JonhRon/Non-Isolate-DC_DC-Converter/Boost_Converter/Document/Images/testing/10W.jpg

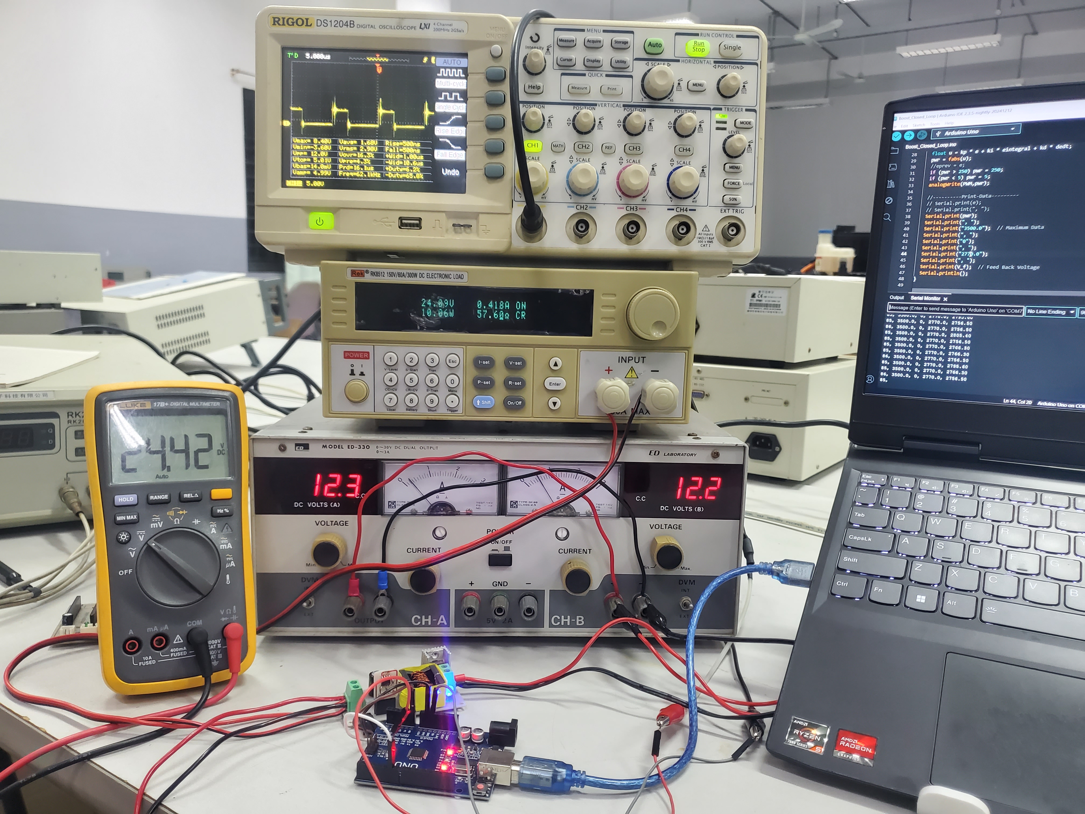
Boost_Converter/Document/Images/testing/10W.jpg
