JonhRon/Non-Isolate-DC_DC-Converter/README.md

# DC-DC Converter
The Project that i do with my 4th year at University.
