JonhRon/Non-Isolate-DC_DC-Converter/Power Electronic Digital Control/Power Electronic Digital Control.txt

Power Electronic Digital Control
[1]. https://drive.google.com/drive/folders/1nfMjxcqcaYfuC1_RFymzxEwPAJWWbfk1    %% For Buck, Boost, Buck-Boost
