JonhRon/Non-Isolate-DC_DC-Converter/Buck_Converter/Document/Docs/inductor_design_using_kg_v1.pdf

## Ferrite Core Selection Using the Kg Method

Input Parameters

L = 34.9 × 10⁻⁶ H | (Inductance)
Io = 4.583 A | (DC Current)
∆I = 1.375 A | (AC Ripple Current)
Po = 110W | (Output Power)
α = 1% | (Regulation)
fs = 100 × 10³ Hz | (Switching Frequency)
Bm = 0.25 T | (Operating Flux Density)
Ku = 0.4 | (Window Utilization)
Tr = 25 ◦C | (Temperature Rise Goal)

Calculations

1. Peak Current (Ipk):

Ipk = Io +

∆I
2
| = 4.583 +
| 1.375
| 2 = 5.27 A
2. Energy-Handling Capability (E):

E =

1
2

LI² pk =

1
2 | · 34.9 × 10⁻⁶ · (5.27)² = 4.87 × 10⁻⁴
J
3. Electrical Condition Coefficient (Ke):

Ke = 0.145 · Po · B

2

m · 10⁻⁴ = 0.145 · 110 · (0.25)²

- 10⁻⁴ = 9.96 × 10⁻⁵
4. Core Geometry Coefficient (Kg):

Kg =

E²
Ke · α

=

(4.87 × 10⁻⁴
)

2
9.96 × 10⁻⁵ · 1

= 2.38 × 10⁻³

Notes

- Kg determines the minimum core size required
- Select a ferrite core with Kg ≥ 2.38 × 10⁻³ cm⁵
- Verify core saturation at Bm = 0.25 T

1
