JonhRon/Non-Isolate-DC_DC-Converter/Buck_Converter/Document/Report/buck_converter_eng_ver02.pdf

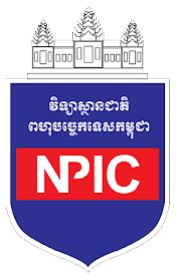
[picture p3: figure]

NATIONAL POLYTECHNIC INSTITUTE OF CAMBODIA

FACULTY OF ELECTRONIC

DEPARTMENT OF ELECTRONIC

# Assignment

# Power Electronic 2

# 120W Buck Converter Design

Professor’s Name : | Meas Saran
Student Name : | Phon Phearon

2024 - 2025

## Contents

1 Overview Of Power Electronic | 1
1.1 What’s DC/DC Converter? | | 1
1.2 Importance of Buck Converters | | 1
2 Fundamental Of Buck Converter | 2
2.1 Basic Operation and Working Principle | | 2
2.2 Key Components | | 3
2.3 Duty Cycle, In/Output Voltage Relationship, and Efficiency | | 3
3 | Mathematical Modeling | 4
3.1 Derivation of the Voltage Conversion Equation | | 4
3.2 Continuous Conduction Mode (CCM)vsDiscontinuous Conduction Mode (DCM) 5
4 Design and Implementation | 9
4.1 Power Stage Calculation and Component Selection | | 9
4.2 Power Stage Calculation and Component Selection Using Matlab Script . . . | 13
4.3 Simulation On LTspice ( Open Loop ) | | 14
4.4 Simulation On Simulink (Open Loop) | | 15
4.5 Simulation on Simulink Using PI Controller (Close Loop) | | 16

## List of Figures

1 | Buck DC-DC Converter | | 2
2 | Equivalent circuit for the switch closed | | | 2
3 | Equivalent circuit for the switch open | | 3
4 | Idealized current and voltage waveforms in the PWM buck converter for CCM. | | | 7
5 | Idealized current and voltage waveforms in the PWM buck converter for DCM. | | | 8
6 | Pulse and Magnetizing Inductance Current Waveform | | 11
7 | EE Core Selected | | | 11
8 | Buck Converter Schematic on LTspice | | | 14
9 | Output Voltage and Ouput Current Waveform | | 14
10 | Duty Cycle and Inductor Current Waveform | | 14
11 | Buck Converter Schematic on LTspice | | | 15
12 | Output Voltage and Ouput Current Waveform | | 15
13 | Duty Cycle and Inductor Current Waveform | | 15
14 | Buck Converter Schematic on LTspice | | | 16
15 | Output Voltage and Ouput Current Waveform | | 16
16 | Duty Cycle and Inductor Current Waveform | | 16

## List of Tables

1 | Parameters Needed for Power Stage Calculation | | 9
2 | IRF540N MOSFET | | 10
3 | 15SQ045 Schottky Diode | | 10
4 | Input Parameters for Ferrite Core Design | | 10
5 | Core Parameters for Ferrite Design | | 12

I

National Polytechnic Institute of Cambodia | | Faculty of Electronic

## 1 Overview Of Power Electronic

### 1.1 What’s DC/DC Converter?

A DC-DC converter is an electronic circuit that converts a source of direct current (DC) from one voltage level to another. Unlike transformers, which are designed to work with alternating current (AC), DC-DC converters are specifically tailored to handle DC power. The primary purpose of a DC-DC converter is to regulate and transform voltage levels to meet the requirements of various electronic devices. For example, step-down converters reduce voltage (for example, from 12V to 5V), while step-up converters increase voltage (e.g., from 3V to 12V).
There are several types of DC-DC converters, including:
- Buck Converter : Steps down voltage.
- Boost Converter : Steps up voltage.
- Buck-Boost Converter : Can both step up and step down voltage.
- Flyback Converter : Used for isolation and multiple outputs.

DC-DC converters are used in a wide range of applications, including consumer electronics (smartphones, laptops, and tablets), automotive systems (electric vehicles, infotainment systems, and lighting), renewable energy (solar panels, battery storage systems, and wind turbines) and industrial equipment (motor drives, robotics, and control systems).

### 1.2 Importance of Buck Converters

A buck converter is a type of DC-DC converter that steps down voltage while maintaining high efficiency. It is also known as a step-down converter because its output voltage is always lower than the input voltage. Buck converters are critical in modern electronics because they allow devices to operate at lower voltages while drawing power from higher-voltage sources. For example, a smartphone battery operates at around 3.7V, but the charger provides 5V or more. A buck converter steps this down efficiently.
The key advantages of buck converters include the following:
- High Efficiency : Buck converters typically achieve efficiencies of 90 or higher, min-imizing energy loss.
- Compact Size : Modern buck converters are small and lightweight, making them ideal for portable devices.
- Cost-Effective : They use fewer components compared to other types of converters, reducing cost and complexity.
- Reliability : With proper design, buck converters can operate reliably for years in demanding environments.

Buck converters are widely used across industries:

- Consumer Electronics : Power microprocessors, memory chips, and displays in laptops, smartphones, and gaming consoles.
- Automotive Systems : Regulating voltage for LED headlights, information system and electric vehicle drivetrains.
Power Electronic 2 | 1 | Buck Converter

- Renewable Energy : Converting the solar panel output to usable voltages for battery charging and grid integration.
- Telecommunications : Providing stable power for routers, switches, and communi-cation towers.

## 2 Fundamental Of Buck Converter

A buck converter is a type of DC-DC switching converter that steps down a higher input voltage Vin to a lower output voltage Vout. Below is a detailed, step-by-step breakdown of its operation, components, and key relationships.

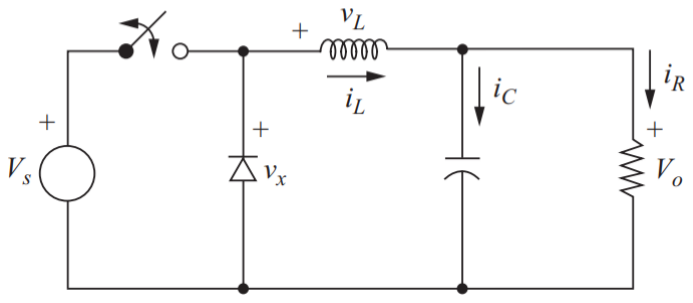
[picture p4: figure]

Figure 1: Buck DC-DC Converter

### 2.1 Basic Operation and Working Principle

The buck converter operates by rapidly switching a power semiconductor (e.g., MOSFET) on and off, controlling energy transfer to the load. Here’s how it works:

Step 1: Switch ON State
- The MOSFET (switch) is turned ON by a PWM (Pulse Width Modulation) signal.
- Current flows from Vin through the inductor (L) to the load and output capacitor (C).
- The inductor stores energy in its magnetic field, and the capacitor charges.
- The diode (D) is reverse-biased (off) during this phase.

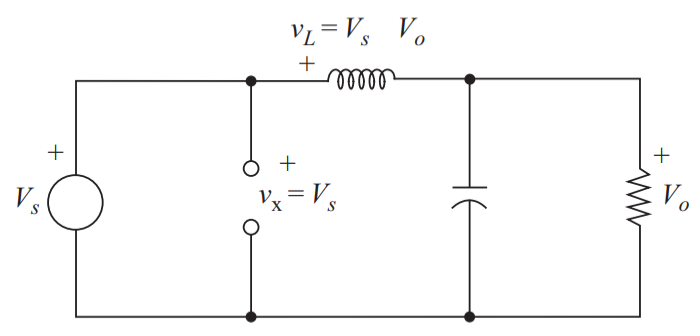
[picture p5: figure]

Figure 2: Equivalent circuit for the switch closed

Power Electronic 2 | 2 | Buck Converter

Step 2: Switch OFF State
- The MOSFET is turned OFF.
- The inductor’s magnetic field collapses, maintaining current flow through the freewheeling diode (D).
- Energy stored in L and C continues to power the load.

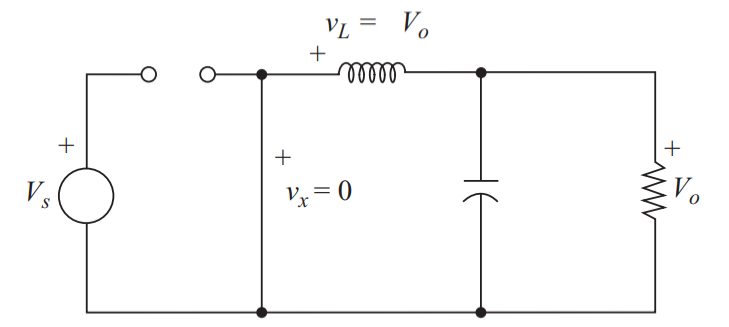
[picture p6: figure]

Figure 3: Equivalent circuit for the switch open

### 2.2 Key Components

A buck converter comprises five critical components:

- MOSFET (Switch):

– Acts as a fast-switching device (e.g., N-channel MOSFET).

– Controlled by a PWM signal to regulate energy transfer.

- Diode (Freewheeling Diode):

– Provides a path for inductor current when the switch is OFF.

– Modern designs often replace diodes with synchronous rectifiers (low-side MOS-FETs) for higher efficiency.

- Inductor (L):

– Stores energy during the ON state and releases it during the OFF state.

– Smooths current ripple.

- Capacitor (C):

– Filters output voltage ripple caused by switching.

– Maintains a stable Vout during load transients.

### 2.3 Duty Cycle, In/Output Voltage Relationship, and Efficiency

1. Duty Cycle (D)
- Defined as the ratio of ON time (Ton) to the total switching period (Tsw):

D =

Ton

Tsw

Power Electronic 2 | 3 | Buck Converter

2. Voltage Relationship:
- In continuous conduction mode (CCM), the output voltage is:

Vout = D · Vin

- This assumes ideal components (no losses).
3. Efficiency (η)
- Efficiency is the ratio of output power (Pout) to input power (Pin):

η =

Pout

Pin

× 100%

4. Losses reduce efficiency:
- Conduction Losses: I
2R losses in MOSFET, diode, inductor, and PCB traces.
- Switching Losses: Energy lost during MOSFET turn-on/turn-off transitions.
- Inductor Core Losses: Hysteresis and eddy current losses in the inductor.
- Capacitor ESR Losses: Equivalent series resistance (ESR) in the capacitor.

## 3 Mathematical Modeling

This section explains the mathematical foundation of buck converters, including voltage conversion equations, conduction modes, and ripple calculations.

### 3.1 Derivation of the Voltage Conversion Equation

During the ON state:
- The switch is closed, and the inductor is charged by the input voltage.
- The voltage across the inductor is:

VL = Vin − Vout

- The current through the inductor increases linearly according to:

∆IL =

VL · Ton
L

=

(Vin − Vout) · Ton
L

During the OFF state:
- The switch is open, and the inductor discharges energy to the load through the diode.
- The voltage across the inductor is:

VL = −Vout

- The current through the inductor decreases linearly according to:

∆IL =

VL · Toff
L

=

−Vout · Toff
L
- In steady-state operation, the increase in inductor current during the ON state equals the decrease during the OFF state:

L · (Vin − Vout) · Ton = L · Vout · Toff

- Simplifying this equation gives:

Vout = D · Vin

Power Electronic 2 | 4 | Buck Converter

### 3.2 Continuous Conduction Mode (CCM)vsDiscontinuous Conduction Mode (DCM)

Continuous Conduction Mode

- In Continuous Conduction Mode (CCM), the inductor current never drops to zero during the switching cycle.
- This mode is common in high-power applications where efficiency and stability are critical.

Discontinuous Conduction Mode

- In Discontinuous Conduction Mode (DCM), the inductor current drops to zero before the next switching cycle begins.
- This mode is often used in low-power applications where simplicity and cost are more important than efficiency.

Key Differences Between CCM and DCM

Inductor Current Waveform:

- In CCM, the inductor current is continuous and has a triangular waveform.
- In DCM, the inductor current becomes zero for part of the switching cycle.

Output Voltage Relationship:

- In CCM, the output voltage is determined solely by the duty cycle:

Vout = D · Vin

- In DCM, the output voltage depends on the load current and switching frequency:

Vout =

2 · L · fsw · Rload
Vin · D²

Efficiency:

- CCM is generally more efficient because the inductor is fully utilized.
- DCM can suffer from higher losses due to the discontinuous nature of the current.

Boundary Condition Between CCM and DCM:

- The boundary between CCM and DCM occurs when the inductor current just reaches zero at the end of the OFF state.
- The critical inductance Lcrit for maintaining CCM is given by:

Lcrit =

(1 − D) · Rload

2 · fsw

- If the actual inductance L is greater than Lcrit, the converter operates in CCM. Oth-erwise, it operates in DCM.
Power Electronic 2 | 5 | Buck Converter

Ripple Current in the Inductor:

- The ripple current ∆IL is the peak-to-peak variation in the inductor current during a switching cycle.
- For CCM, the ripple current is given by:

∆IL =

Vin · D · (1 − D)

L · fsw

where:

– Vin is the input voltage.

– D is the duty cycle.

– L is the inductance.

– fsw is the switching frequency.

Ripple Voltage Across the Capacitor:

- The ripple voltage ∆VC is the variation in the output voltage caused by the charging and discharging of the capacitor.
- It is given by:

∆VC =

∆IL
8 · fsw · C

where:

– ∆IL is the ripple current.

– C is the capacitance.

Power Electronic 2 | 6 | Buck Converter

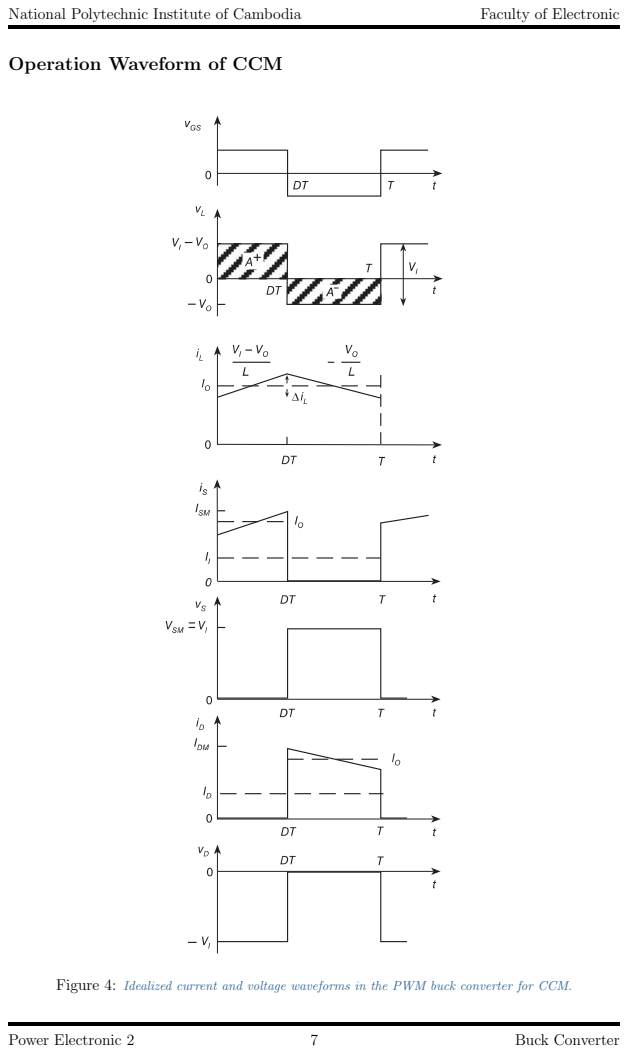
[picture p7: page 9]
Power Electronic 2; Buck Converter

Operation Waveform of CCM

Figure 4: Idealized current and voltage waveforms in the PWM buck converter for CCM.

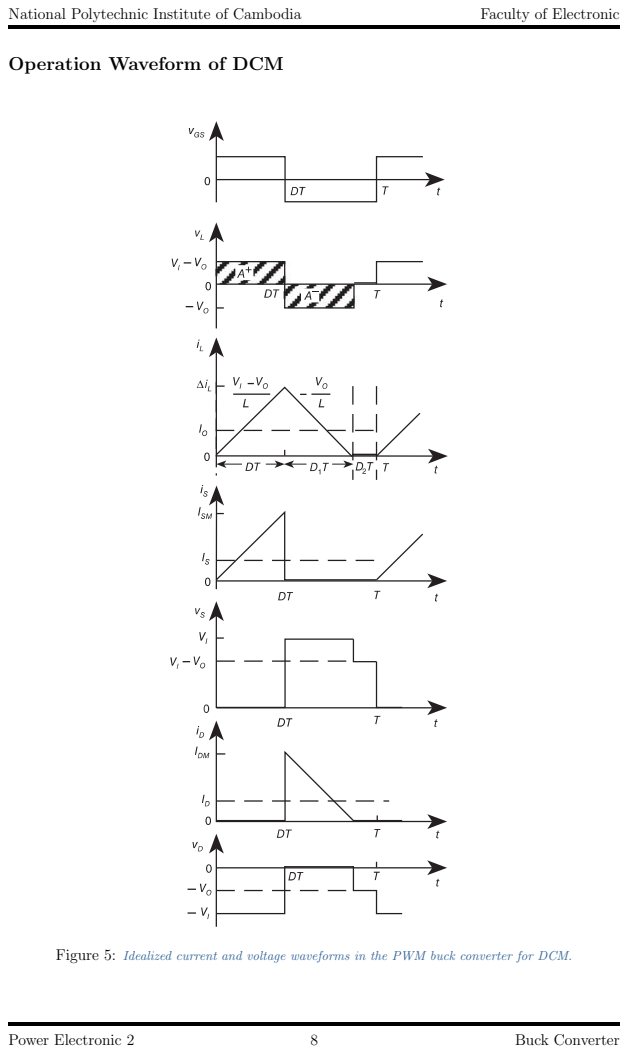
[picture p8: page 10]
Power Electronic 2; Buck Converter

Operation Waveform of DCM

Figure 5: Idealized current and voltage waveforms in the PWM buck converter for DCM.

## 4 Design and Implementation

### 4.1 Power Stage Calculation and Component Selection

Design of a 120W Buck Converter Operating in Continuous Conduction Mode (CCM) with the following specifications:

Parameter | Value
Output Voltage (Vout) | 24 V
Input Voltage (Vin) | 30 V
Output Power (Pout) | 120W
Switching Frequency (fsw) 100 kHz
Ripple Current Rated | 30% of Iout
Ripple Voltage Rated | 1% of Vout

Table 1: Parameters Needed for Power Stage Calculation

### Power Stage Calculations

### 1. Duty Cycle (D)

D =

Vout

Vin

=

24
30

= 0.8 (80%)

### 2. Output Current (Iout)

Iout =

Pout

Vout

=

120
24

≈ 5 A

### 3. Output Resistance (R)

R =

Vout

Iout

=

24
5

≈ 4.8 Ω

### 4. Inductor Ripple Current (∆IL)

∆IL = 30% × Iout = 0.3 × 5 ≈ 1.5 A (peak-to-peak)

### 5. Maximum/Minimum Inductor Current

ILmax = Iout +

∆IL
2

= 5 + 0.75 ≈ 5.75 A

ILmin = Iout −

∆IL
2

= 5 − 0.75 ≈ 4.25 A

### 6. Ripple Voltage (∆Vout)

∆Vout = 1% × Vout = 0.01 × 24 = | 0.24 V (peak-to-peak)
Power Electronic 2 | 9 | Buck Converter

### 7. Output Capacitor (C)

C =

∆IL · D

8 · Fs · ∆Vout

=

1.5 · 0.8
8 · 100 kHz · 0.24

= 6.25 µF

### 8. Inductor (L)

L =

Vout · (Vin − Vout)

Vin · Fs · ∆IL

=

24 · (30 − 24)
30 · 100 kHz · 1.5

= 32 µH

### 9. MOSFET Selection

Table 2: IRF540N MOSFET

Parameter | Value | Test Conditions
VDS | 100 V | Absolute Maximum Rating
ID | 14 A | TC = 25 ◦C
| 10 A | TC = 100 ◦C
RDS(on) | 0.16 Ω | VGS = 10 V, ID = 8.4 A

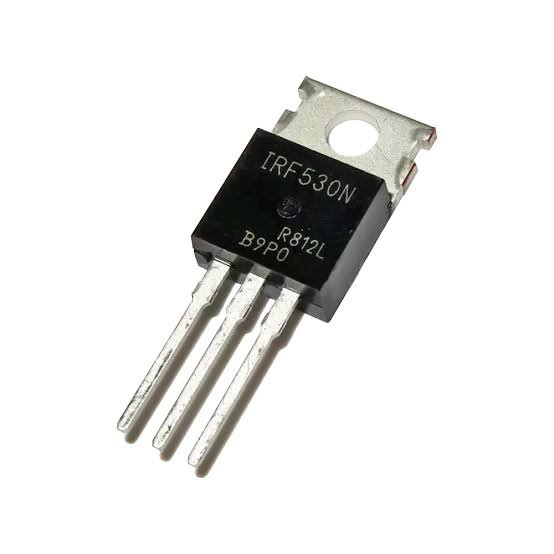
[picture p9: figure]

### 10. Diode Selection

Table 3: 15SQ045 Schottky Diode

Parameter Value | Test Conditions
VRRM | 45 V | Peak Reverse Voltage
IF | 15 A | Continuous, TA = 25 ◦C

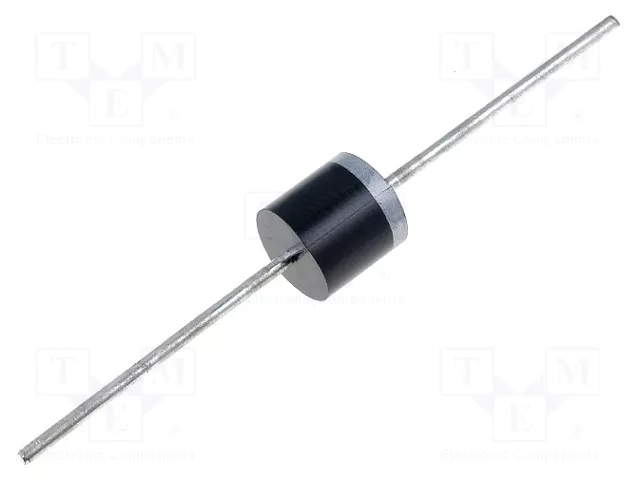
[picture p10: figure]

### 11. Inductor Design

•Inductor Core Selection Using Kg Method

Table 4: Input Parameters for Ferrite Core Design

Symbol Value | Description
L | 32 µH | Inductance
Io | 5 A | DC Current
∆I | 1.5 A | AC Ripple Current
Po | 120W | Output Power
α | 1% | Regulation
fs | 100 kHz Switching Frequency
Bm | 0.25 T | Operating Flux Density
Ku | 0.4 | Window Utilization
Tr | 25 ◦C | Temperature Rise Goal
Power Electronic 2 | 10 | Buck Converter

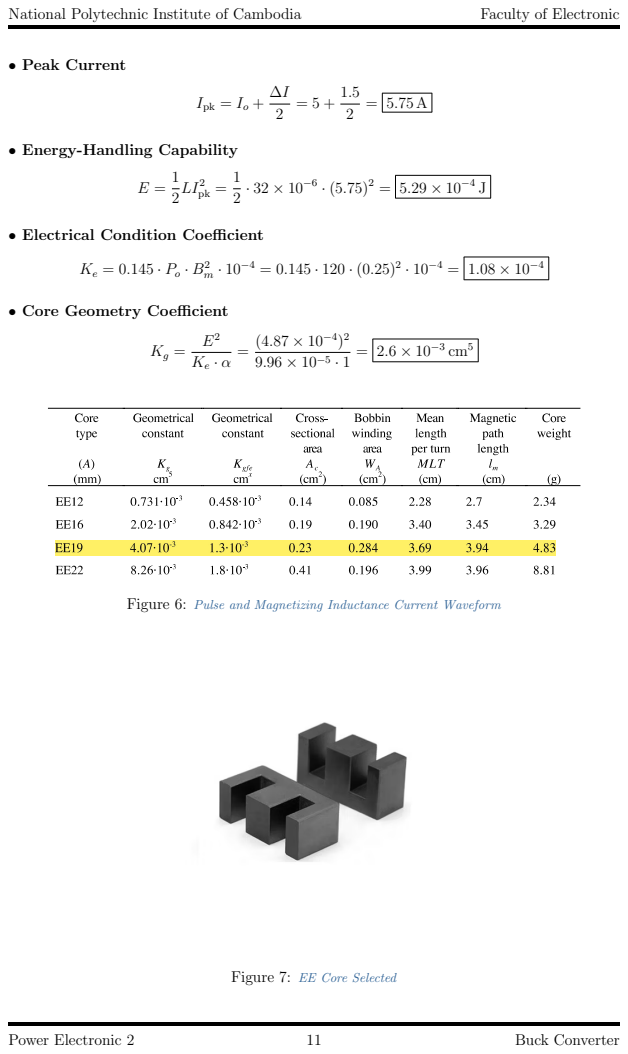
[picture p11: page 13]
• Peak Current; Ipk = Io +; LI² pk =; cm⁵; Power Electronic 2; Buck Converter

• Energy-Handling Capability

• Electrical Condition Coefficient

• Core Geometry Coefficient

Figure 6: Pulse and Magnetizing Inductance Current Waveform

Figure 7: EE Core Selected

Parameter | Value | Description
MPL | 3.94 | Magnetic Path Length (cm)
We | 4.83 | Core Weight (g)
MLT | 3.69 | Mean Length per Turn (cm)
Ac | 0.23 | Cross-Sectional Area (cm²
)
Wa | 0.284 | Window Area (cm²
)
Ap | 0.0653 | Core Product (cm⁴
)
Kg | 4.07 × 10⁻³ Core Geometry (cm⁵
)

Table 5: Core Parameters for Ferrite Design

- Current Density (J)

J =

2 · E · 10⁴

Bm · Ap · Ku

=

2 · 5.29 × 10⁻⁴
- 10⁴
0.25 · 0.06532 · 0.4

≈ 1620 A cm⁻²
- RMS Current (IRMS)

Irms =

p
I

2
o + ∆I

2 =

√
5

2 + 1.5

2 = | 5.22 A | .
- Bare Wire Area (Aw)

Aw =

Irms
J

=

5.22
1620

= 0.003 22 cm²
- Selected Bare Wire Area

Aws = 0.01 cm²

- Effective Window Area (Waeff)
- S3 = 0.75 Window Effective factor for Ferrite core

Waeff = Wa · S3 = 0.284 · 0.75 = 0.213 cm² .

- Number of Turns (N)
- S2 = 0.6 Fill Factor

N =

Waeff · S2

Aws

=

0.213 · 0.6
0.01
= | 12.7 turns | .
- Required Air Gap (Lg)

Lg =

0.4πN²Ac · 10⁻⁸
L

−

MP L
µ0
Substituting values:

Lg =

0.4 · π · 10²

- 0.23 · 10⁻⁸
32 × 10⁻⁶

−

3.94
2500
= | 0.0137 cm | .
Power Electronic 2 | 12 | Buck Converter

### 4.2 Power Stage Calculation and Component Selection Using Matlab Script

Below is the MATLAB code use to calculate the Power Stage and Component Selection for the 120W Buck Converter design.

%% 120W Buck Converter Design
clc , clear , close all ;
%% Design Parameter
Vin = 30; | % Input Voltage (V)
Vout = 24; | % Output Voltage (V)
Pout = 120; | % Output Power (W)
Fs = 100 e3 ; | % Switching Frequency (Hz)
ripple_current_rate = 0.3; % 30% ripple current ripple_voltage_rate = 0.01; % 1% ripple voltage %% 1. Duty Cycle (D)
D = Vout / Vin ;
%% 2. Output Current ( Iout )
Iout = Pout / Vout ;
%% 3. Output Resistance ( Rout )
Rout = Vout / Iout ;
%% 4. Ripple Current
delta_I_L = ripple_current_rate * Iout ; I_L_max = Iout + delta_I_L / 2;
I_L_min = Iout - delta_I_L / 2;
%% 5. Inductor (L)
L = ( Vout * ( Vin - Vout ) ) / ( Vin * Fs * delta_I_L ) ;
L_standard = ceil ( L / 1e -6) ; % Round to nearest standard valuellt %% 6. Ripple Voltage
delta_Vout = ripple_voltage_rate * Vout ;
%% 7. Output Capacitor (C)
C = ( delta_I_L * D ) / (8 * Fs * delta_Vout ) ;
C_standard = ceil ( C / 1e -6) ; % Round to nearest standard value

Listing 1: MATLAB Code for 120W Buck Converter Design

Power Electronic 2 | 13 | Buck Converter

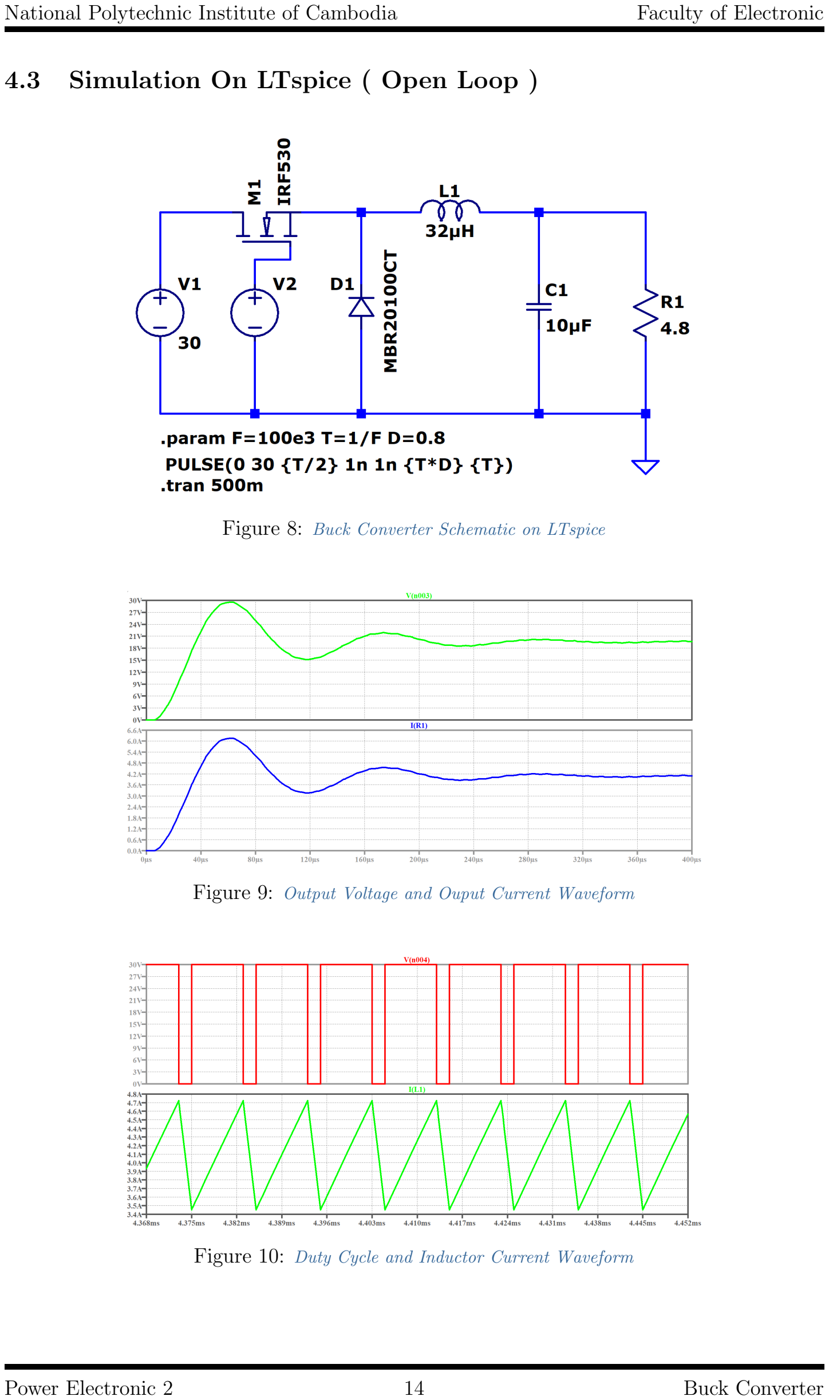
[picture p12: page 16]

### 4.3 Simulation On LTspice ( Open Loop )

Figure 8: Buck Converter Schematic on LTspice

Figure 9: Output Voltage and Ouput Current Waveform

Figure 10: Duty Cycle and Inductor Current Waveform

Power Electronic 2 | 14 | Buck Converter

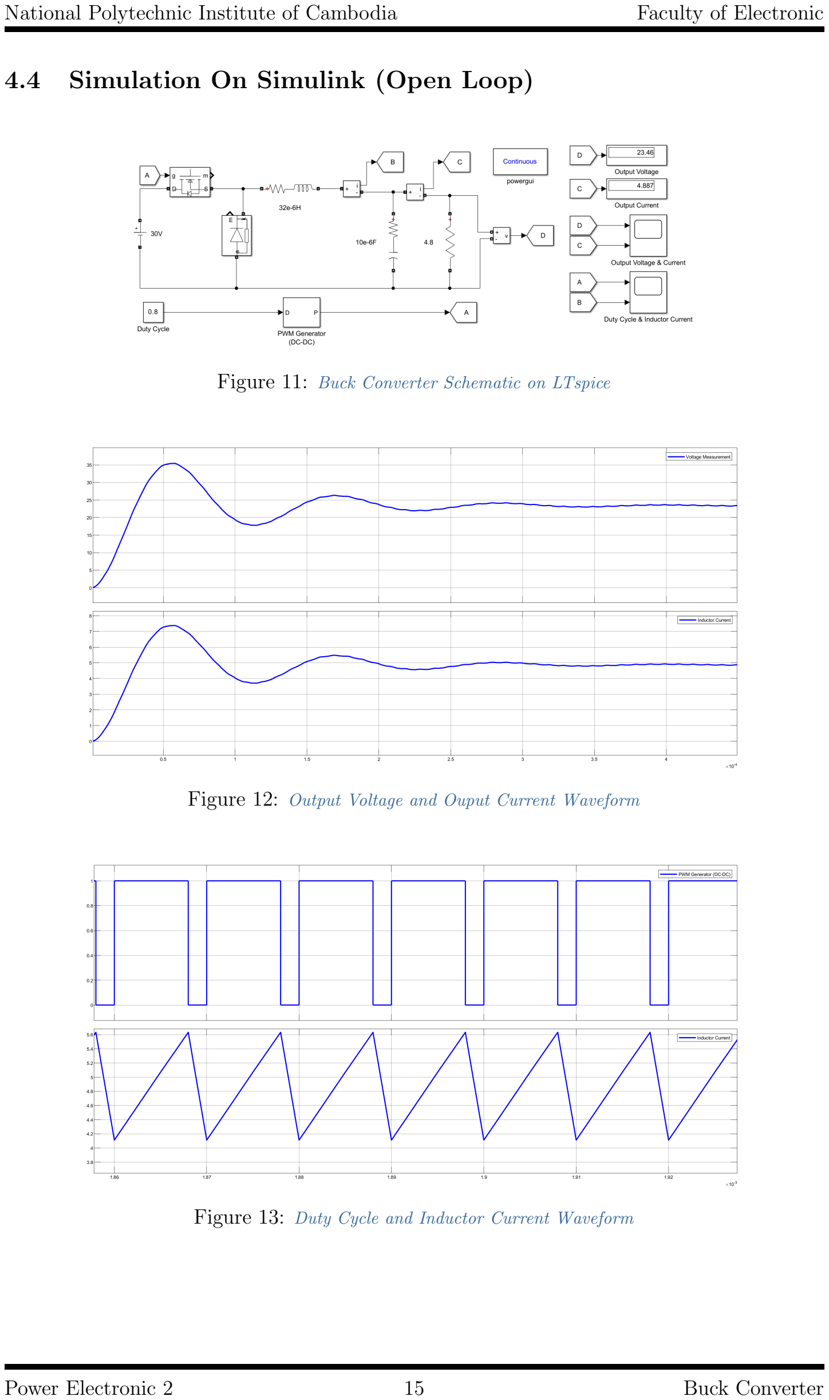
[picture p13: page 17]

### 4.4 Simulation On Simulink (Open Loop)

Figure 11: Buck Converter Schematic on LTspice

Figure 12: Output Voltage and Ouput Current Waveform

Figure 13: Duty Cycle and Inductor Current Waveform

Power Electronic 2 | 15 | Buck Converter

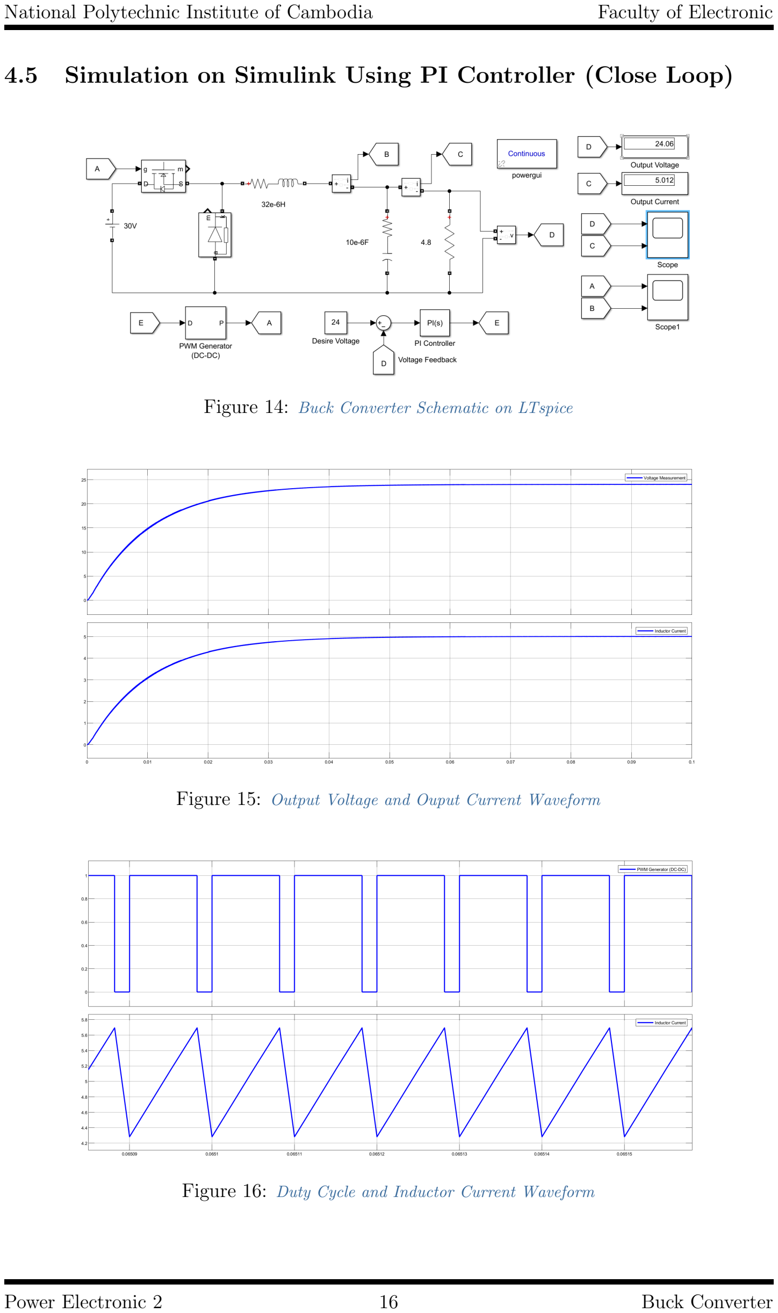
[picture p14: page 18]

### 4.5 Simulation on Simulink Using PI Controller (Close Loop)

Figure 14: Buck Converter Schematic on LTspice

Figure 15: Output Voltage and Ouput Current Waveform

Figure 16: Duty Cycle and Inductor Current Waveform

Power Electronic 2 | 16 | Buck Converter

## References

[1] COLONEY WM.T. MCLYMAN, Transformer Design and Inductor Design Handbook, 3rd ed., Publisher Marcel Dekker, Inc, California, U.S.A, 2004, ISBN: 0-8247-5393-3.
Power Electronic 2 | 17 | Buck Converter
