JonhRon/Non-Isolate-DC_DC-Converter/Boost_Converter/Document/Docs/inductor_design_kg.pdf

## Ferrite Core Selection Using Kg Method

Input Parameters

- Inductance (L): 20 µH
- DC Current (Io): 10 A
- AC Current (∆I): 3 A
- Output Power (Po): 120W
- Regulation (α): 1%
- Switching Frequency (Fs): 100 kHz
- Operating Flux Density (Bm): 0.25 T
- Window Utilization (Ku): 0.4
- Temperature Rise Goal (Tr): 25◦C

Calculations

### 1. Peak Current (Ipk)

Ipk = Io +

∆I
2

= 10 +

3
2
= | 11.5 A | [[4]]

### 2. Energy-Handling Capability (E)

E =

1
2

LI²
pk =

1
2
- 20 × 10⁻⁶
- (11.5)² ≈ | 0.00132W-s | [[3]]

### 3. Electrical Condition Coefficient (Ke)

Ke = 0.145 · Po · B

2

m · 10⁻⁴ = 0.145 · 120 · (0.25)²

- 10⁻⁴ ≈ 2.175 × 10⁻⁵
[[4]]

### 4. Core Geometry Coefficient (Kg)

Kg =

E²
Ke · α

=

(0.00132)²
2.175 × 10⁻⁵ · 1

≈ 0.0805 cm⁵
[[5]][[6]]

Core Selection Criteria

Select a ferrite core with:

Kg ≥ 0.0805 cm⁵
(from manufacturer datasheets) [[7]]

1

Summary of Results

Parameter | Value
Peak Current (Ipk) Energy-Handling (E) Electrical Coefficient (Ke) Core Geometry (Kg) | 11.5 A 0.00132W-s 2.175 × 10⁻⁵ 0.0805 cm⁵

2
