JonhRon/Non-Isolate-DC_DC-Converter/Boost_Converter/Document/Report/BOOST_CONVERTER.pdf

NATIONAL POLYTECHNIC INSTITUTE OF CAMBODIA

FACULTY OF ELECTRONIC

DEPARTMENT OF ELECTRONIC

# Assignment

# Power Electronic 2

# 120W Boost Converter Design

Professor’s Name : | Meas Saran
Student Name : | Phon Phearon

2024 - 2025

## Contents

1 Overview Of Power Electronic | 1
1.1 What’s DC/DC Converter? | | 1
1.2 Importance of Buck Converters | | 1
2 Fundamental Of Buck Converter | 2
2.1 Basic Operation and Working Principle | | 2
2.2 Key Components | | 3
2.3 Duty Cycle, Input/Output Voltage Relationship, and Efficiency | | 4
3 | Mathematical Modeling | 5
3.1 Derivation of the Voltage Conversion Equation | | 5
3.2 Mode of Operation | | 7
4 Design and Implementation | 8
4.1 Power Stage Calculation and Component Selection | | 8
4.2 Power Stage Calculation and Component Selection Using Matlab Script . . . | 13
4.3 Simulation On LTspice ( Open Loop ) | | 14
4.4 Simulation On Simulink (Open Loop) | | 15
4.5 Simulation on Simulink Using PI Controller (Close Loop) | | 16

## List of Figures

1 | 150W Boost Converter | | 1
2 | 5V-35V Boost Converter | | 1
3 | The boost converter | | | 2
4 | Equivalent circuit for the switch closed | | | 2
5 | Equivalent circuit for the switch open | | 3
6 | CCM Operation Mode | | 7
7 | DCM Operation Mode | | 8
8 | PQ Core Parameter Table List | | 11
9 | PQ20/20 Core Selected | | 11
10 | Boost Converter Schematic on LTspice | | 14
11 | Output Voltage and Ouput Current Waveform | | 14
12 | Duty Cycle and Inductor Current Waveform | | 14
13 | Boost Converter Schematic on LTspice | | 15
14 | Output Voltage and Ouput Current Waveform | | 15
15 | Duty Cycle and Inductor Current Waveform | | 15
16 | Boost Converter Schematic on LTspice | | 16
17 | Output Voltage and Ouput Current Waveform | | 16
18 | Duty Cycle and Inductor Current Waveform | | 16

## List of Tables

1 | Parameters Needed for Power Stage Calculation | | 9
2 | IRF540N MOSFET | | 10
3 | 15SQ045 Schottky Diode | | 10
4 | Input Parameters for Ferrite Core Design | | 10
5 | Core Parameters for Ferrite Design | | 12

I

National Polytechnic Institute of Cambodia | Faculty of Electronic

## 1 Overview Of Power Electronic

### 1.1 What’s DC/DC Converter?

A DC-DC converter is an electronic circuit that converts a source of direct current (DC) from one voltage level to another. Unlike transformers, which are designed to work with alternating current (AC), DC-DC converters are specifically tailored to handle DC power. The primary purpose of a DC-DC converter is to regulate and transform voltage levels to meet the requirements of various electronic devices. For example, step-down converters reduce voltage (for example, from 12V to 5V), while step-up converters increase voltage (e.g., from 3V to 12V).
There are several types of DC-DC converters, including:
- Buck Converter : Steps down voltage.
- Boost Converter : Steps up voltage.
- Buck-Boost Converter : Can both step up and step down voltage.
- Flyback Converter : Used for isolation and multiple outputs.

DC-DC converters are used in a wide range of applications, including consumer electronics (smartphones, laptops, and tablets), automotive systems (electric vehicles, infotainment systems, and lighting), renewable energy (solar panels, battery storage systems, and wind turbines) and industrial equipment (motor drives, robotics, and control systems).

### 1.2 Importance of Buck Converters

Boost converters play a vital role in modern power electronics due to their ability to efficiently step up voltage levels. Their importance lies in their capacity to generate higher output voltages from low-voltage sources, ensuring stable and regulated power delivery even under fluctuating input conditions. They are highly efficient, minimizing energy loss and heat generation, which is critical for optimizing system performance. Additionally, their compact design and wide input voltage range make them adaptable to diverse operating environments. Boost converters help increase voltage in different systems. They provide steady voltage control and support modern technologies, making them effective, affordable, and easy to expand.

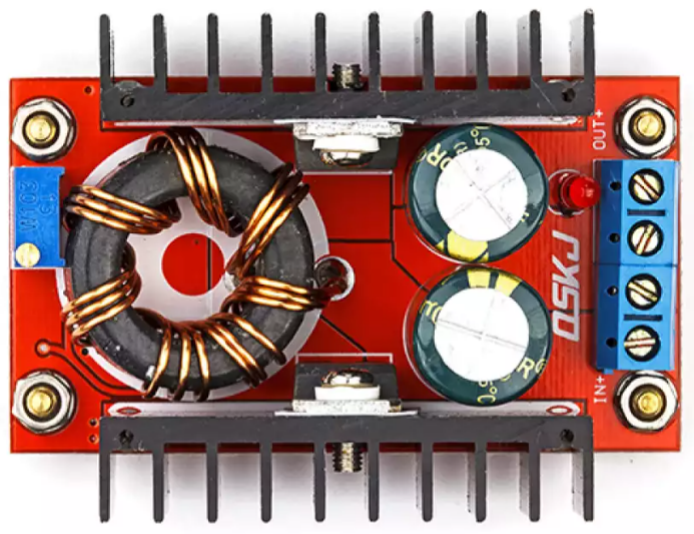
[picture p15: figure]

Figure 1: 150W Boost Converter

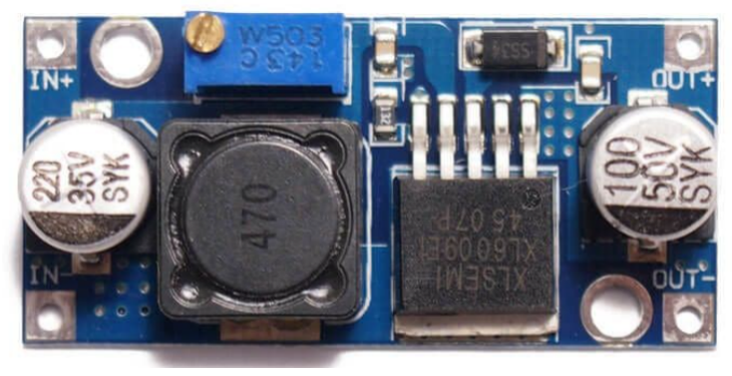
[picture p16: figure]

Figure 2: 5V-35V Boost Converter

Power Electronic 2 | 1 | Boost Converter

## 2 Fundamental Of Buck Converter

### 2.1 Basic Operation and Working Principle

is a type of DC-DC converter that steps up a lower input voltage to a higher output voltage. It operates on the principle of energy storage and transfer using an inductor, a switch, and a diode. The operation alternates between two main phases: Switch ON (Energy Storage) and Switch OFF (Energy Transfer).

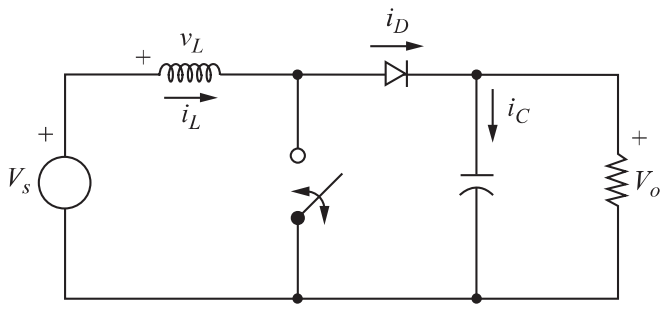
[picture p17: figure]

Figure 3: The boost converter

Switch ON (Energy Storage Phase)

When the switch (typically a MOSFET) is closed (ON), current flows through the inductor and the switch. During this phase:

- The inductor stores energy in its magnetic field.
- The diode is reverse-biased, so no current flows to the load or the output capacitor.
- The voltage across the inductor is given by:

VL = Vin

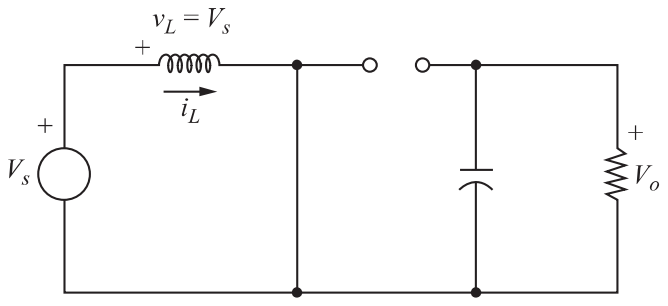
[picture p18: figure]

Figure 4: Equivalent circuit for the switch closed

Power Electronic 2 | 2 | Boost Converter

Switch OFF (Energy Transfer Phase)

When the switch is opened (OFF):

- The inductor resists the sudden drop in current by inducing a voltage that opposes the change.
- This induced voltage forward-biases the diode, allowing current to flow from the inductor to the load and the output capacitor.
- The output capacitor smooths out the voltage, providing a stable DC output.
- The voltage across the inductor during this phase is:

VL = Vout − Vin

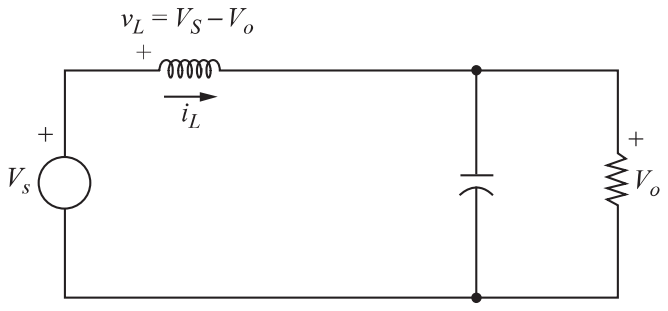
[picture p19: figure]

Figure 5: Equivalent circuit for the switch open

### 2.2 Key Components

The basic boost converter circuit consists of four key components:

### 1. Inductor (L)

- Function: Stores energy in the form of a magnetic field when the switch is ON and releases it to the load when the switch is OFF.
- Role: Smooths out the current ripple and ensures continuous energy transfer to the load.
- Selection Criteria: The inductor value determines the amount of energy stored and affects the ripple current. Larger inductors reduce ripple but increase size and cost.

### 2. Switch (S)

- Function: Controls the flow of current through the inductor. Typically implemented using a MOSFET or transistor.
- Role: The switch alternates between ON and OFF states at a high frequency (con-trolled by a PWM signal).
- Selection Criteria: The switch must handle the maximum input voltage and current with minimal power loss (low Rds(on)

for MOSFETs).

Power Electronic 2 | 3 | Boost Converter

### 3. Diode (D)

- Function: Acts as a freewheeling diode, providing a path for the inductor current when the switch is OFF.
- Role: Prevents the inductor from discharging back into the switch and ensures continuous current flow to the load.
- Selection Criteria: A Schottky diode is often used due to its low forward voltage drop and fast switching speed, which minimizes power loss.

### 4. Capacitor (C)

- Function: Smooths out the output voltage and reduces voltage ripple.
- Role: Stores charge during the OFF phase and releases it during the ON phase, ensuring a stable DC output.
- Selection Criteria: The capacitor value affects the output voltage ripple. Larger capacitors reduce ripple but may increase cost and size.

### 2.3 Duty Cycle, Input/Output Voltage Relationship, and Efficiency

### 1. Duty Cycle (D)

- Definition: The duty cycle is the fraction of time the switch is ON during a switching period.
- Formula:

D =

Ton

Ton + Tof f

=

Ton
T

Where:

– Ton: Time the switch is ON

– Tof f : Time the switch is OFF

– T: Total switching period (T = Ton + Tof f )

### 2. Input/Output Voltage Relationship

The relationship between the input voltage (Vin) and the output voltage (Vout) in a boost converter is determined by the duty cycle (D).

- Formula:

Vout =

Vin
1 − D
Rearranging for D:

D = 1 −

Vin

Vout

Power Electronic 2 | 4 | Boost Converter

### 3. Efficiency

- Definition: Efficiency is the ratio of output power to input power, expressed as a percentage.
- Formula:
Efficiency(η) = Pout

Pin

× 100%

Where:

– Pout = Vout · Iout

– Pin = Vin · Iin

## 3 Mathematical Modeling

### 3.1 Derivation of the Voltage Conversion Equation

The goal of this section is to derive the relationship between the input voltage (Vin) and the output voltage (Vout) in a boost converter. The derivation involves analyzing the two phases of operation (Switch ON and Switch OFF) and applying the principle of energy balance.

Step 1: Understanding the Two Phases of Operation

A boost converter operates in two distinct phases:

1. Switch ON (Energy Storage Phase): The switch is closed, and current flows through the inductor, storing energy in its magnetic field.
2. Switch OFF (Energy Transfer Phase): The switch is open, and the inductor releases its stored energy to the load through the diode.

We will analyze these two phases to derive the voltage conversion equation.

Step 2: Analyzing the Switch ON Phase

During the ON phase, the switch is closed, and the inductor is directly connected to the input voltage source (Vin). The voltage across the inductor is:

VL = Vin

The current through the inductor increases linearly with time because the inductor stores energy. The rate of change of inductor current is given by:

dIL
dt =

VL
L

=

Vin
L

where: - L: Inductance of the inductor - t: Time
The increase in inductor current during the ON phase is proportional to the duration of the ON phase (Ton):

∆Ion =

Vin
L
- Ton
Power Electronic 2 | 5 | Boost Converter

Step 3: Analyzing the Switch OFF Phase

During the OFF phase, the switch is open, and the inductor tries to maintain the current flow (due to its stored energy). This causes the inductor to induce a voltage that adds to the input voltage. The voltage across the inductor during this phase is:

VL = Vout − Vin

The current through the inductor decreases linearly with time. The rate of change of inductor current is given by:
dIL
dt =

VL
L

=

Vout − Vin
L
The decrease in inductor current during the OFF phase is proportional to the duration of the OFF phase (Tof f ):

∆Iof f =

Vout − Vin
L
- Tof f
Step 4: Applying the Principle of Energy Balance

To ensure continuous operation, the average current through the inductor over one switching cycle must remain constant. This means that the increase in inductor current during the ON phase must equal the decrease in inductor current during the OFF phase:

∆Ion = ∆Iof f

Substitute the expressions for ∆Ion and ∆Iof f :

Vin
L
- Ton =

Vout − Vin
L
- Tof f

Cancel out L (since it is the same in both phases):

Vin · Ton = (Vout − Vin) · Tof f

Step 5: Relating Ton and Tof f to the Duty Cycle

From the definition of the duty cycle:

D =

Ton
T

, Tof f = T − Ton = T · (1 − D)

where: - T: Total switching period (T = Ton + Tof f )
Substitute Ton = D · T and Tof f = (1 − D) · T into the equation:

Vin · (D · T) = (Vout − Vin) · ((1 − D) · T)

Cancel out T (since it is the same on both sides):

Vin · D = (Vout − Vin) · (1 − D)

Expand the right-hand side:

Vin · D = Vout · (1 − D) − Vin · (1 − D)

Simplify:

Vin · D = Vout − Vout · D − Vin + Vin · D

Power Electronic 2 | 6 | Boost Converter

Cancel out Vin · D on both sides:

0 = Vout − Vout · D − Vin

Factor out Vout:
Vout · (1 − D) = Vin

Solve for Vout:

Vout =

Vin
1 − D

### 3.2 Mode of Operation

Continuous Conduction Mode (CCM)

In CCM, the inductor current never drops to zero during the switching cycle. This means that energy is continuously transferred from the input to the output through the inductor. CCM is typically used in high-power applications where the load current is relatively high.

- The inductor current has a triangular waveform with a DC offset.
- The converter operates in steady-state, meaning the average inductor current remains constant over time.
- The ripple current is small compared to the average inductor current.

Key Characteristics

- The inductor current is always positive (IL > 0).
- The output voltage depends only on the duty cycle (D) and input voltage (Vin).
- The ripple current is small compared to the average inductor current.

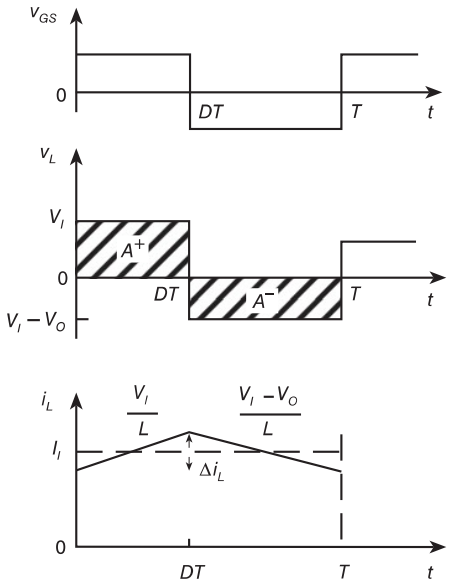
[picture p20: figure]

Figure 6: CCM Operation Mode

Power Electronic 2 | 7 | Boost Converter

### Discontinuous Conduction Mode (DCM)

### DCM Operation Mode

In DCM, the inductor current drops to zero before the next switching cycle begins. This mode occurs when the load current is low, and the inductor cannot maintain continuous current flow. DCM is typically used in low-power applications.

- The inductor current waveform has a triangular shape but drops to zero during part of the switching cycle.
- The output voltage depends not only on the duty cycle (D) but also on the load current and inductor value.

Key Characteristics

- The inductor current is zero for part of the switching cycle (IL = 0).
- The output voltage is less stable compared to CCM.
- Efficiency may drop at very light loads.

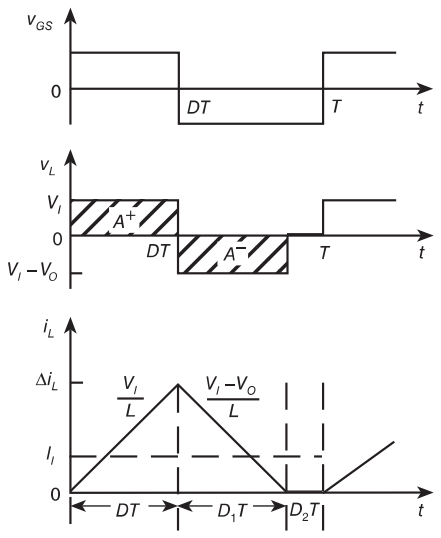
[picture p21: figure]

Figure 7: DCM Operation Mode

## 4 Design and Implementation

### 4.1 Power Stage Calculation and Component Selection

Design of a 120W Boost Converter Operating in Continuous Conduction Mode (CCM) with the following specifications:

Power Electronic 2 | 8 | Boost Converter

Parameter | Value
Output Voltage (Vout) | 24 V
Input Voltage (Vin) | 12 V
Output Power (Pout) | 120W
Switching Frequency (fsw) 100 kHz
Ripple Current Rated | 30%
Ripple Voltage Rated | 1%

Table 1: Parameters Needed for Power Stage Calculation

### Power Stage Calculations

### 1. Duty Cycle (D)

D = 1 −

Vin

Vout

= 1 −

12
24

= 0.5 (50%)

### 2. Output Current (Iout)

Iout =

Pout

Vout

=

120
24

= 5 A

### 3. Output Resistance (R)

Rout =

V

2
out
Pout

=

24²
120

= 4.8 Ω

### 4. Inductor Ripple Current (∆IL)

- Average Inductor Current:

ILavg =

Vout · Iout

Vin

=

24 · 5
12

= 10 A

- Inductor Ripple Current:

∆IL = 0.3 · ILavg = 0.3 · 10 = 3 A (peak-to-peak)

- Minimum Inductor Current:

ILmax = ILavg +

∆IL
2

= 10 −

3
2

= 8.5 A

- Maximum Inductor Current:

ILmin = ILavg −

∆IL
2

= 10 +

3
2

= 11.5A

### 5. Ripple Voltage (∆Vout)

∆Vout = 0.01 · Vout = 0.24 V

Power Electronic 2 | 9 | Boost Converter

### 6. Output Capacitor (C)

C =

Iout · D

Fs · ∆Vout

=

5 · 0.5
100 × 10³
- 0.24

≈ 104 µF

### 7. Inductor (L)

L =

Vin · D
Fs · ∆IL

=

12 · 0.5
100 × 10³
- 3

= 20 µH

### 8. MOSFET Selection

Table 2: IRF540N MOSFET

Parameter | Value | Test Conditions
VDS | 100 V | Absolute Maximum Rating
ID | 14 A | TC = 25 ◦C
| 10 A | TC = 100 ◦C
RDS(on) | 0.16 Ω | VGS = 10 V, ID = 8.4 A


### 9. Diode Selection

Table 3: 15SQ045 Schottky Diode

Parameter Value | Test Conditions
VRRM | 100 V | Maximum repetitive rating
IF | 5 A | Continuous, TA = 25 ◦C


### 11. Inductor Design

- Inductor Core Selection Using Kg Method

Table 4: Input Parameters for Ferrite Core Design

Symbol Value | Description
L | 20 µH | Inductance
Io | 10 A | DC Current
∆I | 3 A | AC Ripple Current
Po | 120W | Output Power
α | 1% | Regulation
fs | 100 kHz Switching Frequency
Bm | 0.25 T | Operating Flux Density
Ku | 0.4 | Window Utilization
Tr | 25 ◦C | Temperature Rise Goal
Power Electronic 2 | 10 | Boost Converter

- Peak Current

Ipk = Io +

∆I
2

= 10 +

3
2

= 11.5 A

- Energy-Handling Capability

E =

1
2

LI²
pk =

1
2
- 20 × 10⁻⁶
- (11.5)² ≈ 0.00132W-s
- Electrical Condition Coefficient

Ke = 0.145 · Po · B

2

m · 10⁻⁴ = 0.145 · 120 · (0.25)²

- 10⁻⁴ ≈ 1.075 × 10⁻⁴
- Core Geometry Coefficient

Kg =

E

2
Ke · α

=

(0.00132)²
1.075 × 10⁻⁴
- 1

≈ 0.0161 cm⁵

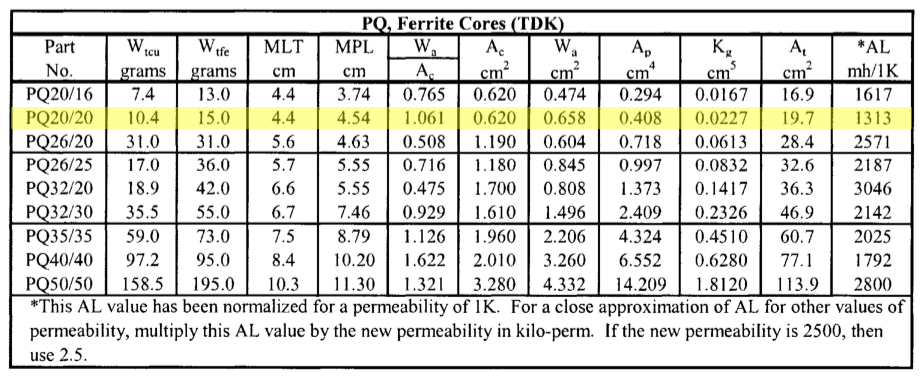
[picture p22: figure]

Figure 8: PQ Core Parameter Table List

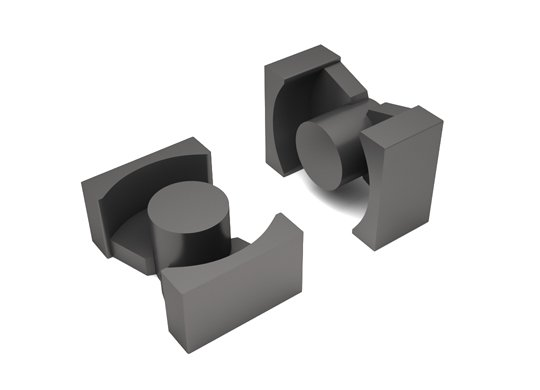
[picture p23: figure]

Figure 9: PQ20/20 Core Selected

Power Electronic 2 | 11 | Boost Converter

Parameter | Value | Description
MPL | 4.54 | Magnetic Path Length (cm)
We | 15 | Core Weight (g)
MLT | 4.4 | Mean Length per Turn (cm)
Ac | 0.620 | Cross-Sectional Area (cm²
)
Wa | 0.658 | Window Area (cm²
)
Ap | 0.408 | Core Product (cm⁴
)
Kg | 0.0227 | Core Geometry (cm⁵
)

Table 5: Core Parameters for Ferrite Design

- Current Density (J)

J =

2 · E · 10⁴

Bm · Ap · Ku

| =

2 · 0.0013 · 10⁴
0.25 · 0.408 · 0.4

≈ 637.25 A/cm²

- RMS Current (IRMS)

Irms =

p
I

2
o + ∆I

2 =

√
10² + 3² = 10.44 A
- Bare Wire Area (Aw)

Aw =

Irms
J

=

10.44
637.25

≈ 0.0164 cm²

- Selected Bare Wire Area

Aws = 0.015 cm²

- Effective Window Area (Waeff)
- S3 = 0.75 Window Effective factor for Ferrite core

Waef f = Wa · S3 = 0.658 · 0.65 ≈ 0.4277 cm²

- Number of Turns (N)
- S2 = 0.6 Fill Factor

N =

Waef f · S2

Aws

=

0.4277 · 0.6
0.015

≈ 17.11 turns

- Required Air Gap (Lg)

Lg =

0.4πN²Ac · 10⁻⁸
L

−

MP L
µ0
Substituting values:

Lg =

0.4 · π · (17.11)²

- 0.620 · 10⁻⁸
20 × 10⁻⁶
−
4.54

2500
≈ | 0.112 cm
Power Electronic 2 | 12 | Boost Converter

### 4.2 Power Stage Calculation and Component Selection Using Matlab Script

Below is the MATLAB code use to calculate the Power Stage and Component Selection for the 120W Boost Converter design.

%% MATLAB Script for Boost Converter Design in Continuous Conduction Mode ( CCM)
clc , clear ;
%% Input Parameters
Vin = 12; % Input Voltage (V)
Vout = 24; % Output Voltage (V)
fsw = 100 e3 ; % Switching Frequency (Hz)
Pout = 120; % Output Power (W)
RippleCurrentRated = 0.3; % Ripple Current Rated (30% of average inductor current )
RippleVoltageRated = 0.01; % Ripple Voltage Rated (1% of output voltage ) %% Step -by - Step Calculations
% Step 1: Calculate Duty Cycle (D)
D = 1 - ( Vin / Vout ) ;
% Step 2: Calculate Output Current ( Iout ) Iout = Pout / Vout ;
% Step 3: Calculate Load Resistance ( Rload )
Rload = Vout / Iout ;
% Step 4: Calculate Ripple Output Voltage ( DeltaVout ) DeltaVout = RippleVoltageRated * Vout ;
% Step 5: Calculate Inductor Value (L)
IL = Iout / (1 - D ) ; % Average Inductor Current
DeltaIL = RippleCurrentRated * IL ; % Ripple Current
L = ( Vin * D ) / ( fsw * DeltaIL ) ; % Inductance in Henries % Step 6: Calculate Maximum and Minimum Inductor Currents ILmax = IL + DeltaIL / 2; % Maximum Inductor Current
ILmin = IL - DeltaIL / 2; % Minimum Inductor Current
C = ( Iout * D ) / ( fsw * DeltaVout ) ; % Capacitance in Farads

Listing 1: MATLAB Code for 120W Boost Converter Design

Power Electronic 2 | 13 | Boost Converter

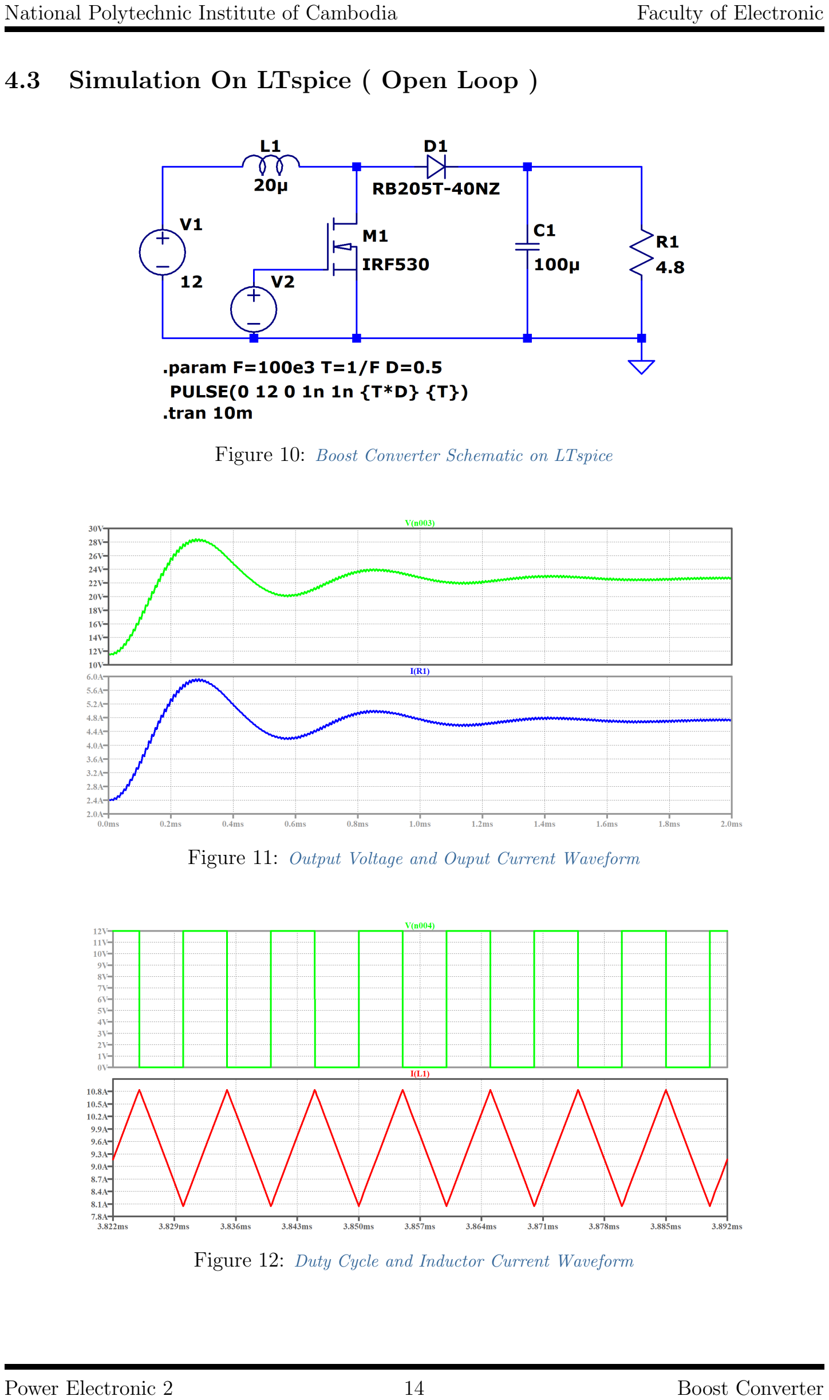
[picture p24: page 16]

### 4.3 Simulation On LTspice ( Open Loop )

Figure 10: Boost Converter Schematic on LTspice

Figure 11: Output Voltage and Ouput Current Waveform

Figure 12: Duty Cycle and Inductor Current Waveform

Power Electronic 2 | 14 | Boost Converter

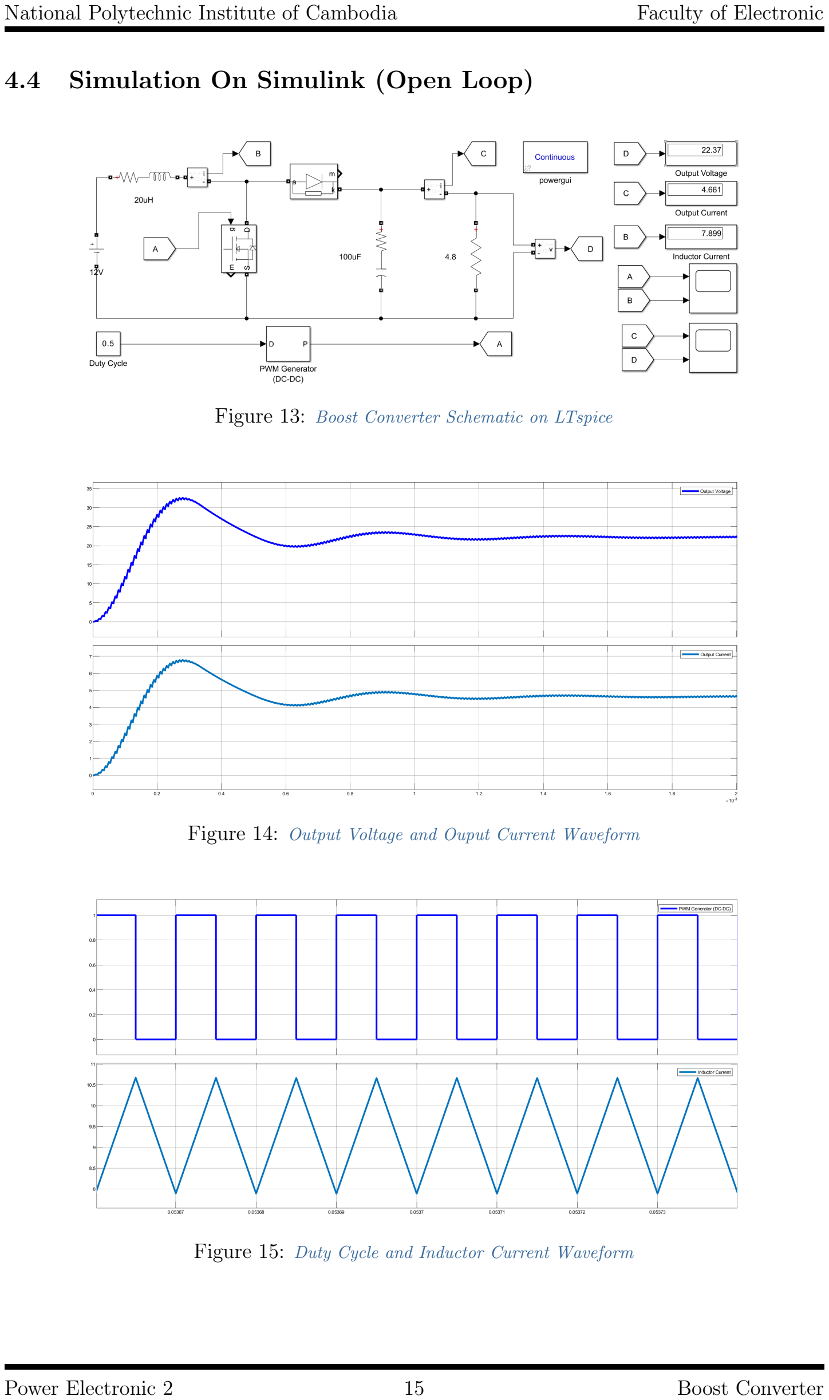
[picture p25: page 17]

### 4.4 Simulation On Simulink (Open Loop)

Figure 13: Boost Converter Schematic on LTspice

Figure 14: Output Voltage and Ouput Current Waveform

Figure 15: Duty Cycle and Inductor Current Waveform

Power Electronic 2 | 15 | Boost Converter

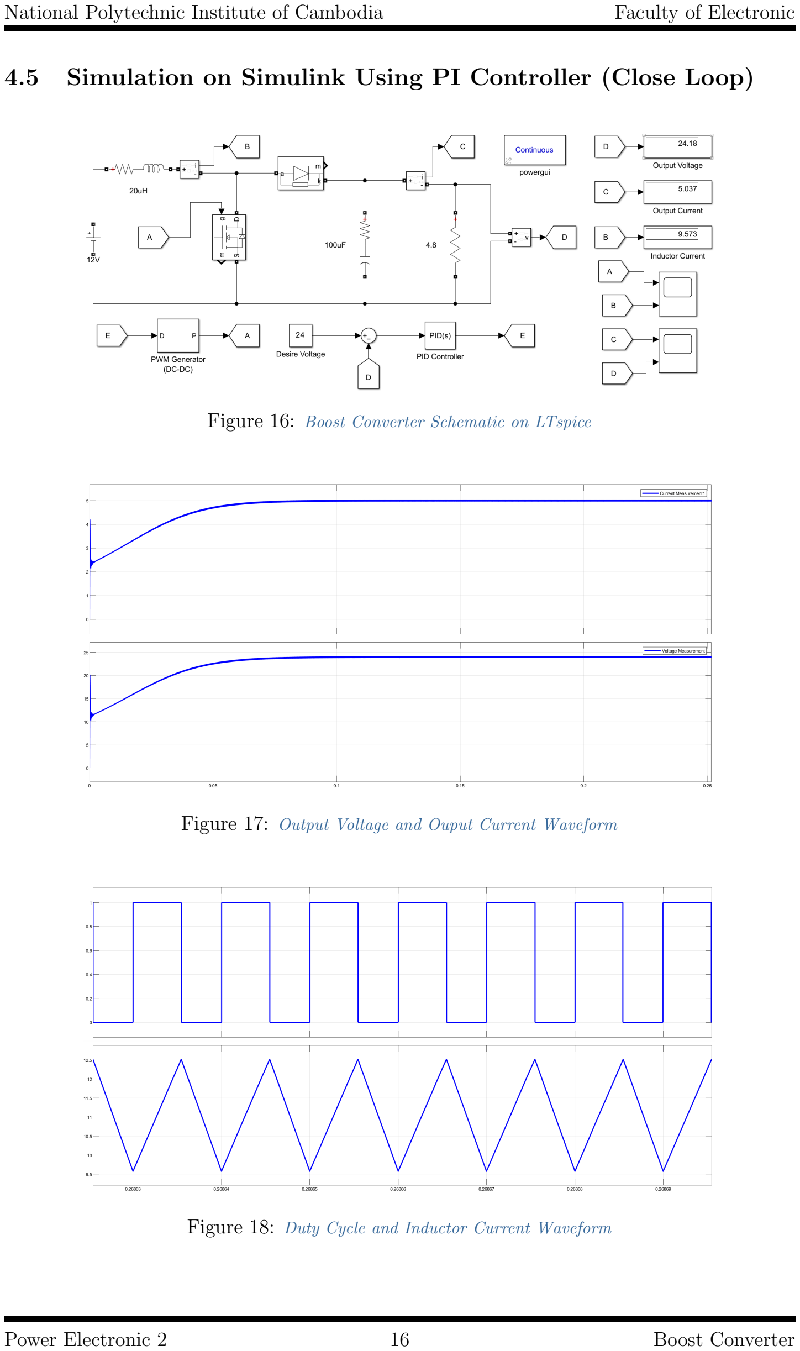
[picture p26: page 18]

### 4.5 Simulation on Simulink Using PI Controller (Close Loop)

Figure 16: Boost Converter Schematic on LTspice

Figure 17: Output Voltage and Ouput Current Waveform

Figure 18: Duty Cycle and Inductor Current Waveform

Power Electronic 2 | 16 | Boost Converter
