JonhRon/Non-Isolate-DC_DC-Converter/Boost_Converter/Document/data.pdf

Desire Power [W] | Load Resistance | Output Current [A] | Output Voltage [V] | Actual Power [W]
5.00 | 115.20 | 0.21 | 24.38 | 5.10
10.00 | 57.60 | 0.42 | 24.42 | 10.21
15.00 | 38.40 | 0.62 | 24.28 | 15.15
20.00 | 28.80 | 0.84 | 24.26 | 20.38
25.00 | 23.04 | 1.03 | 24.18 | 24.91
30.00 | 19.20 | 1.22 | 24.25 | 29.59
35.00 | 16.46 | 1.45 | 24.46 | 35.47
40.00 | 14.40 | 1.69 | 24.65 | 41.66
45.00 | 12.80 | 1.88 | 24.56 | 46.17
50.00 | 11.52 | 2.12 | 24.74 | 52.45
55.00 | 10.47 | 2.34 | 24.77 | 57.96
60.00 | 9.60 | 2.53 | 24.58 | 62.19
