JonhRon/Non-Isolate-DC_DC-Converter/Buck_Converter/Document/Docs/buck_command_v1.pdf

## Flyback Converter Power Stage Calculation

Given parameters:

- Input Voltage: Vin = 30V
- Output Voltage: Vout = 24V
- Output Power: Pout = 120W
- Switching Frequency: Fs = 100KHz
- Ripple Current Rate: 30%
- Ripple Voltage Rate: 1%
- Calculate Duty Cycle
- Calculate Output Current
- Calculate Output Resistance
- Calculate Ripple Current, Maximum and Minimum Ripple Current
- Calculate Ripple Voltage
- Calculate Cpacitor
- Calculate Inductor
- Calculate Selection of Mosfet
- Calculate Selection of Diode

1
