JonhRon/Non-Isolate-DC_DC-Converter/Buck_Converter/Document/Docs/buck_power_stage_calculation_v2.pdf

# Buck Converter Power Stage Design

## Given Parameters

- Input Voltage: Vin = 30 V
- Output Voltage: Vout = 24 V
- Output Power: Pout = 120W
- Switching Frequency: Fs = 100 kHz
- Ripple Current Rate: 30%
- Ripple Voltage Rate: 1%

## Calculations

### 1. Duty Cycle (D)

D =

Vout

Vin

=

24 V
30 V

= 0.8 (80%)

### 2. Output Current (Iout)

Iout =

Pout

Vout

=

120W
24 V

= 5 A

### 3. Output Resistance (Rout)

Rout =

Vout

Iout

=

24 V
5 A = 4.8 Ω

### 4. Ripple Current (∆IL)

∆IL = 0.3 × Iout = 0.3 × 5 A = 1.5 A (peak-to-peak)

ILmax = Iout +

∆IL
2

= 5 A + 0.75 A = 5.75 A

ILmin = Iout −

∆IL
2

= 5 A − 0.75 A = 4.25 A

1

### 5. Inductor (L)

L =

Vout · (Vin − Vout)
Vin · Fs · ∆IL

=

24 · (30 − 24)
30 · 100 kHz · 1.5

= 32 µH

Selection: 33 µH inductor with saturation current > 5.75 A.

### 6. Ripple Voltage (∆Vout)

∆Vout = 1% × Vout = 0.24 V

### 7. Output Capacitor (C)

C =

∆IL · D
8 · Fs · ∆Vout

=

1.5 · 0.8
8 · 100 kHz · 0.24

= 6.25 µF

Selection: 10 µF, 35 V, low-ESR ceramic or polymer capacitor.

### 8. MOSFET Selection

- Voltage Rating: > 30 V (choose 50 V for margin)
- Current Rating: > 5.75 A (peak current)
- Recommendation: IRF540N (50 V, 22 A, low RDS(on))

### 9. Diode Selection

- Voltage Rating: > 30 V (choose 40 V for margin)
- Current Rating: > 5.75 A (peak current)
- Recommendation: SB1045 (40 V, 10 A Schottky diode)

## Component Summary

Component | Value/Part Number
Inductor Capacitor MOSFET Diode | 33 µH, 7 A saturation 10 µF, 35 V, X7R/Ceramic IRF540N (50 V, 22 A) SB1045 (40 V, 10 A)

2
