JonhRon/Non-Isolate-DC_DC-Converter/Buck_Converter/Document/Docs/inductor_winding_parameter_v1.pdf

## EE16 Ferrite Core Design Calculations

Core Parameters

MP L = 3.45 cm | (Magnetic Path Length)
W e = 3.29 g | (Core Weight)
MLT = 3.40 cm | (Mean Length per Turn)
Ac = 0.19 cm² | (Cross-Sectional Area)
Wa = 0.19 cm² | (Window Area)
Ap = Ac · Wa = 0.0361 cm⁴ | (Core Product)

Kg = 2.02 × 10⁻³
cm⁵
| (Core Geometry)

Design Calculations

### 1. Current Density (J)

J =

2E · 10⁴
Bm · Ap · Ku

=

2 · 4.87 × 10⁻⁴
- 10⁴
0.25 · 0.0361 · 0.4
| =
| 9.74
| 0.00361 ≈ 2698 A cm⁻²

### 2. RMS Current (IRMS)

IRMS =

p
I

2
o + (∆I)

2 =

p
4.583² + 1.375² =

√
21.00 + 1.89 ≈ 4.785 A

### 3. Bare Wire Area (Aw)

Aw =

IRMS
J

=

4.785
2698

≈ 0.001 77 cm²

- Selected Bare Wire Area:

Aws = 0.003 cm²

### 4. Effective Window Area (Waeff)

Waeff = Wa · S3 = 0.19 · 0.75 = 0.1425 cm²

### 5. Number of Turns (N)

N =

Waeff · S2

Aws

=

0.1425 · 0.6
0.003

=

0.0855
0.003

= 28.5 ≈ 29 turns

1

### 6. Required Air Gap (Lg)

Lg =

0.4πN²Ac · 10⁻⁸
L

−

MP L
µ0
Substituting values:

Lg =

0.4π · 29²

- 0.19 · 10⁻⁸
34.9 × 10⁻⁶

−

3.45
2500

=

0.4π · 841 · 0.19 · 10⁻⁸
34.9 × 10⁻⁶

− 0.00138

=

0.4 · 3.1416 · 160.0 · 10⁻⁸ 34.9 × 10⁻⁶

− 0.00138

=

2.01 × 10⁻⁶
34.9 × 10⁻⁶

− 0.00138

= 0.0576 − 0.00138 ≈ 0.0562 cm

Design Notes

- Use AWG 30 wire (Aw ≈ 0.001 77 cm²
)
- Verify core saturation: Bsat > 0.25 T
- Gap tolerance: Maintain ±0.001 cm precision
- Thermal check: Ensure Tr ≤ 25 ◦C rise

2
