JonhRon/Non-Isolate-DC_DC-Converter/Buck_Converter/Document/Docs/irf530.pdf

Table 1: Key Parameters for IRF530 MOSFET
Parameter | Value | Test Conditions
VDS | 100 V | Absolute Maximum Rating
ID | 14 A | TC = 25 ◦C
| 10 A | TC = 100 ◦C
RDS(on) | 0.16 Ω | VGS = 10 V, ID = 8.4 A

Table 2: Key Parameters for SR510 Schottky Diode
Parameter | Value | Test Conditions
VRRM | 100 V | Maximum repetitive rating
IF | 5 A | Continuous, TA = 25 ◦C

1
