JonhRon/Non-Isolate-DC_DC-Converter/Boost_Converter/Document/Docs/boost_power_stage_cal_v2.pdf

## Boost Converter Power Stage Calculation (12V to 24V)

Given Parameters

- Input Voltage (Vin): 12V
- Output Voltage (Vout): 24V
- Output Power (Pout): 120W
- Switching Frequency (Fs): 100 kHz
- Ripple Current Rate: 30%
- Ripple Voltage Rate: 1%

### 1. Duty Cycle (D)

For a boost converter in CCM:

D = 1 −

Vin

Vout

= 1 −

12
24

= 0.5 (50%)

### 2. Output Current (Iout)

Iout =

Pout

Vout

=

120
24

= 5 A

### 3. Output Resistance (Rout)

Rout =

V

2
out
Pout

=

24²
120

= 4.8 Ω

### 4. Inductor Current Calculations

- Average Inductor Current (ILavg ):

ILavg =

Vout · Iout

Vin

=

24 · 5
12

= 10 A

- Ripple Current (∆IL):

∆IL = 0.3 · ILavg = 0.3 · 10 = 3 A (peak-to-peak)

- Maximum/Minimum Inductor Current:

ILmax = 10 +

3
2

= 11.5 A, ILmin = 10 −

3
2

= 8.5 A

1

### 5. Inductor Value (L)

L =

Vin · D
Fs · ∆IL

=

12 · 0.5
100 × 10³ · 3

= 20 µH

### 6. Output Capacitor (C)

- Ripple Voltage (∆Vout):

∆Vout = 0.01 · Vout = 0.24 V

- Capacitor Value:

C =

Iout · D

Fs · ∆Vout

=

5 · 0.5
100 × 10³ · 0.24

≈ 104 µF

### 7. MOSFET Selection

- Voltage Rating: ≥ 24 V (Choose 30V for margin)
- Current Rating: ≥ 10 A (Choose 15A for margin)
- Example: IRF540N (100V, 33A)

### 8. Diode Selection

- Reverse Voltage: ≥ 24 V (Choose 30V Schottky diode)
- Average Current: ≥ 5 A
- Example: STPS20H100CT (100V, 20A)

2
