JonhRon/Non-Isolate-DC_DC-Converter/Buck_Converter/Document/Images/eecore.pdf

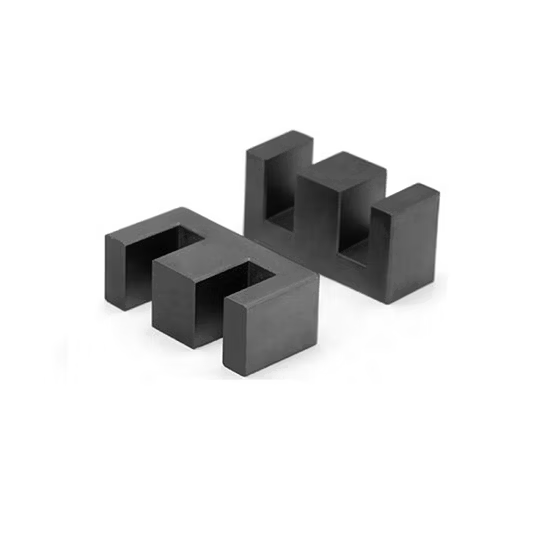
[picture p27: page 1]
