JonhRon/Non-Isolate-DC_DC-Converter/Buck_Converter/Document/Images/ltspic_shem.pdf

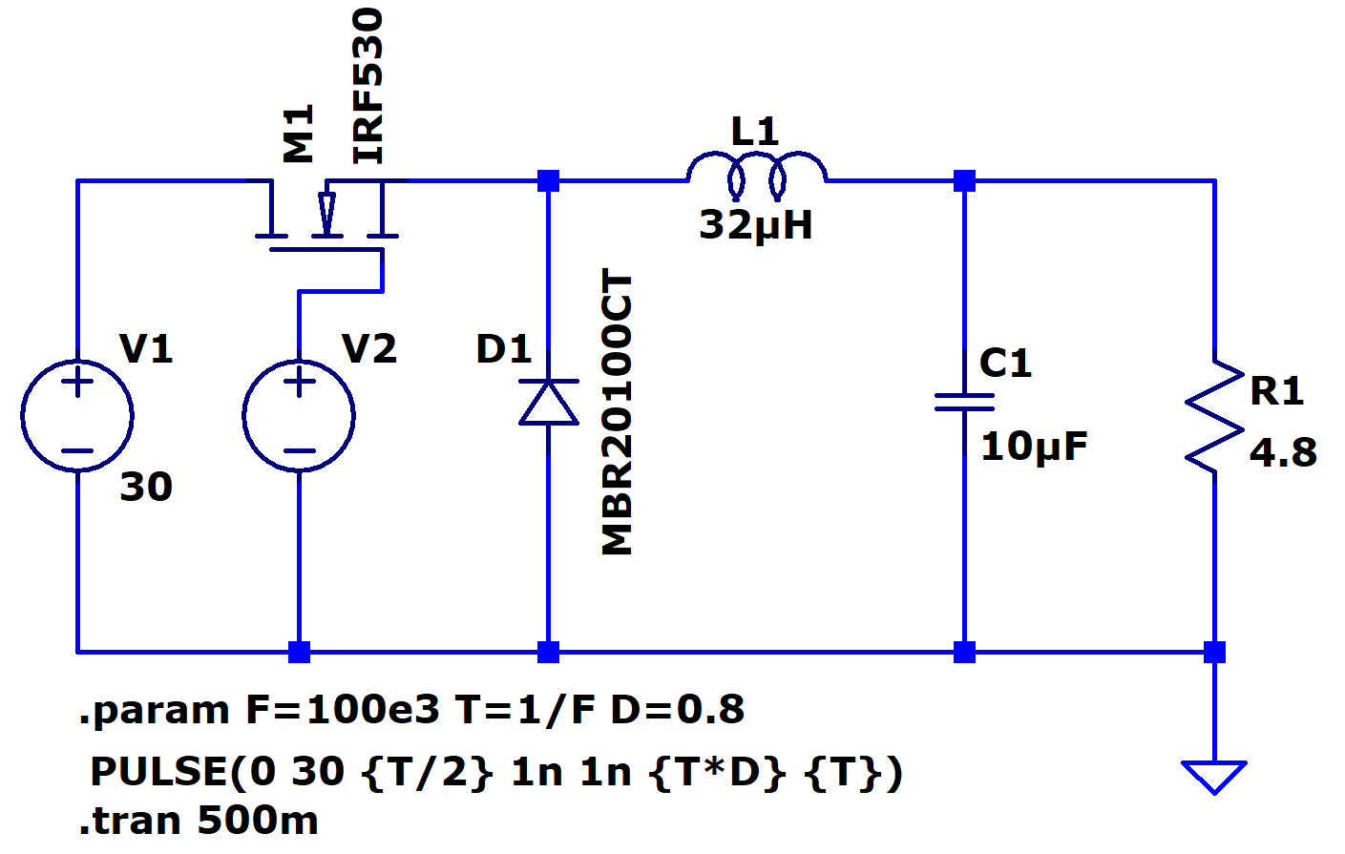
[picture p28: page 1]
