JonhRon/Non-Isolate-DC_DC-Converter/Buck_Converter/Document/Images/ltspic_waveform_1.pdf

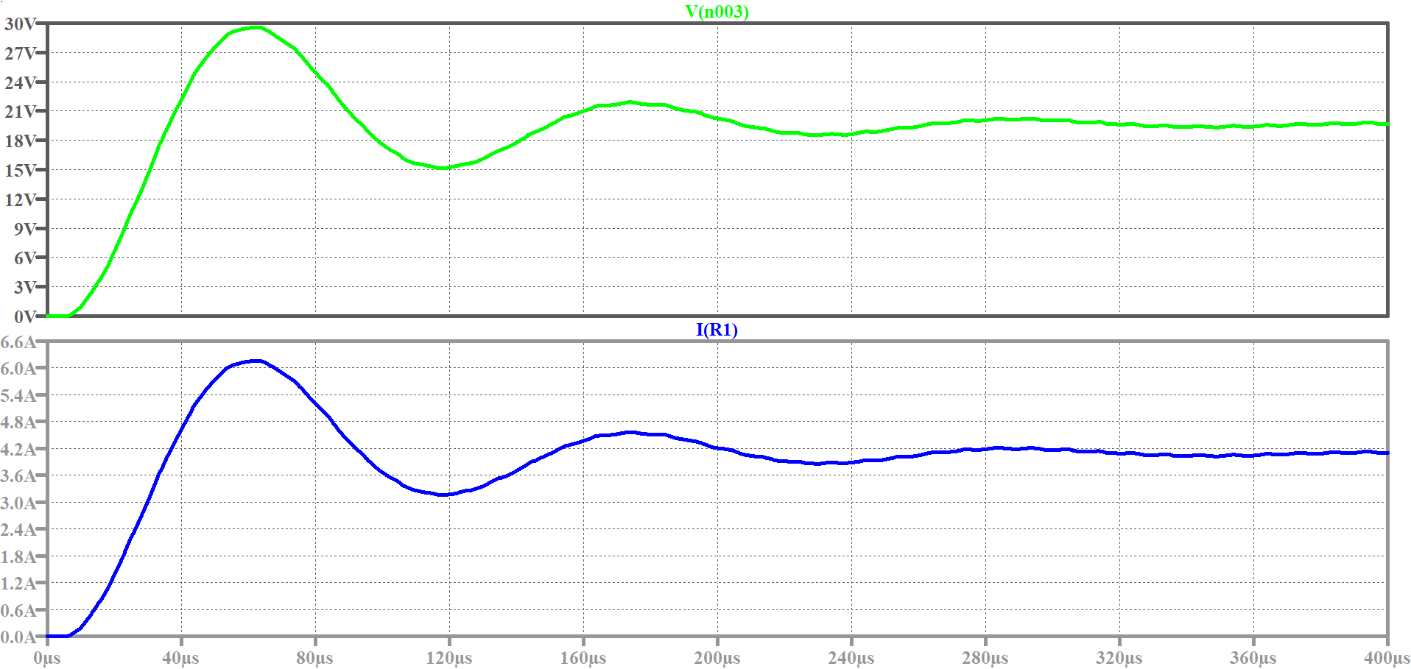
[picture p29: page 1]
