JonhRon/Non-Isolate-DC_DC-Converter/Buck_Converter/Document/Images/ltspic_waveform_2.pdf

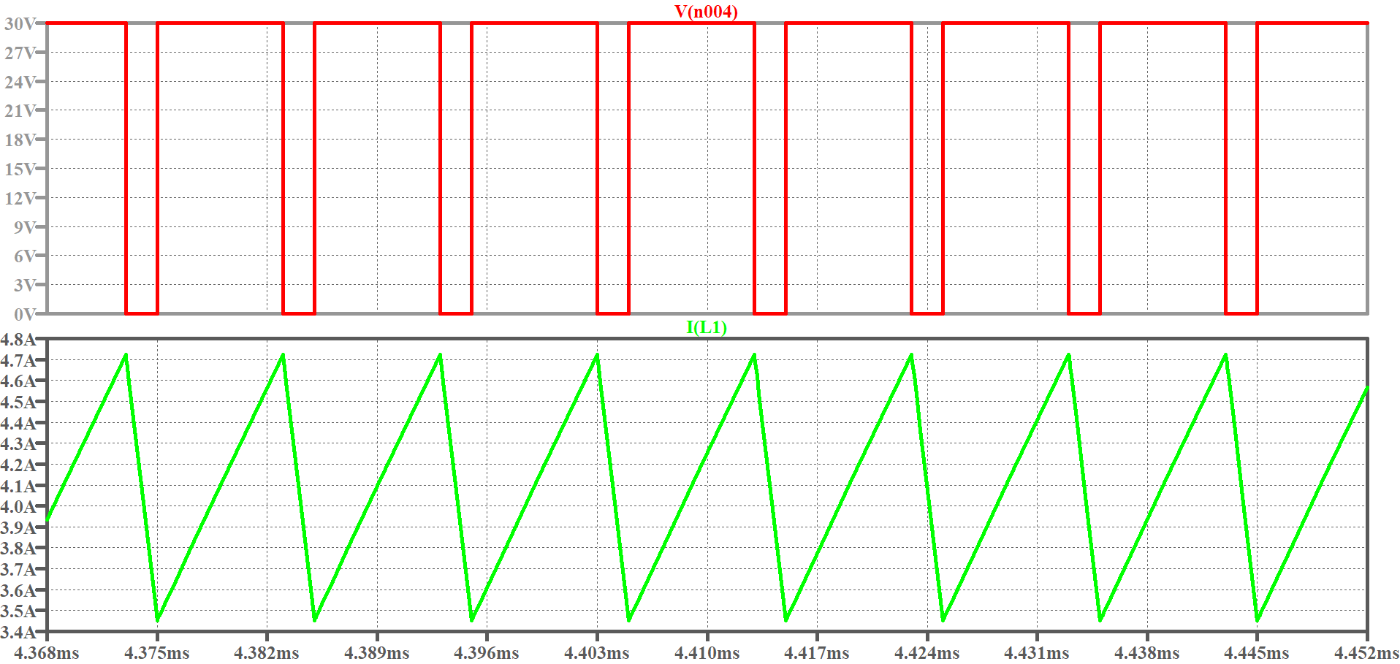
[picture p30: page 1]
