JonhRon/Non-Isolate-DC_DC-Converter/Buck_Converter/Document/Images/simulink_schem_close.pdf

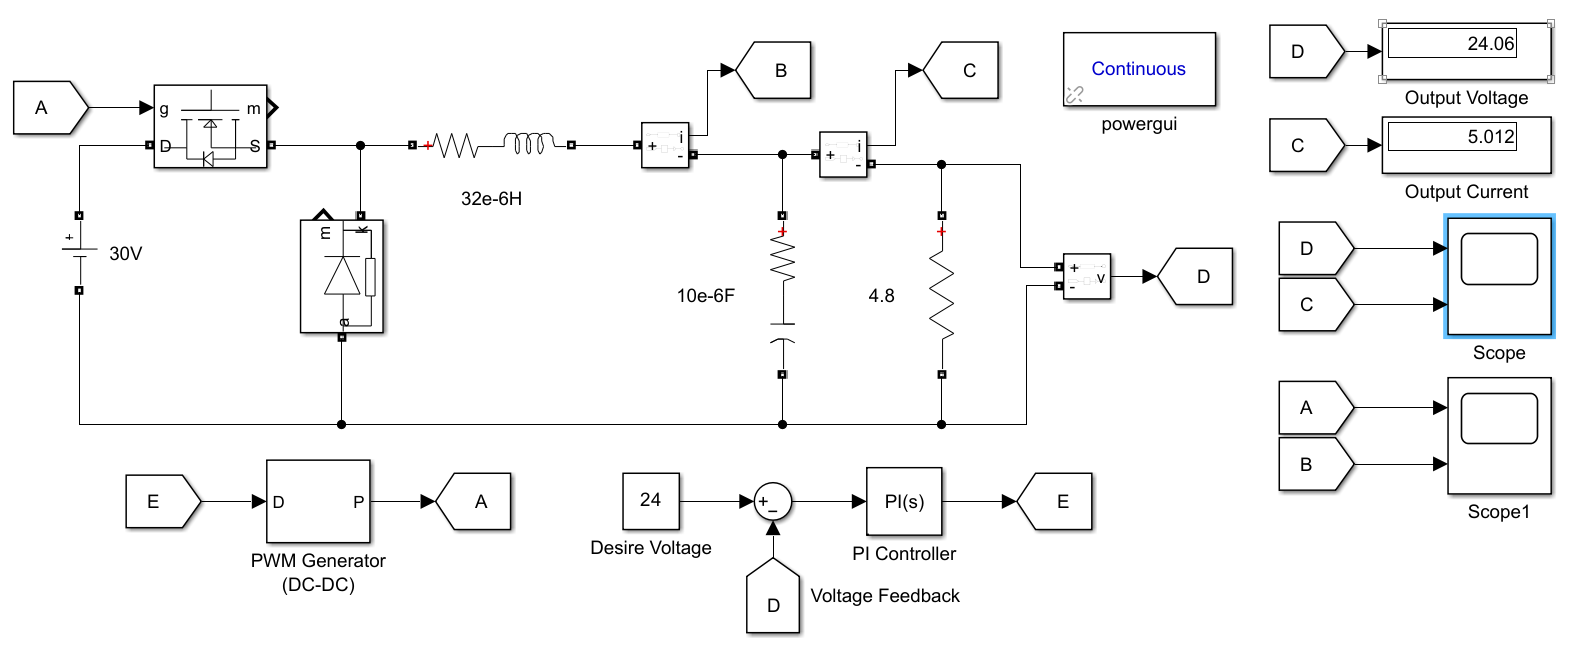
[picture p31: page 1]
