JonhRon/Non-Isolate-DC_DC-Converter/Buck_Converter/Document/Images/simulink_schem_open.pdf

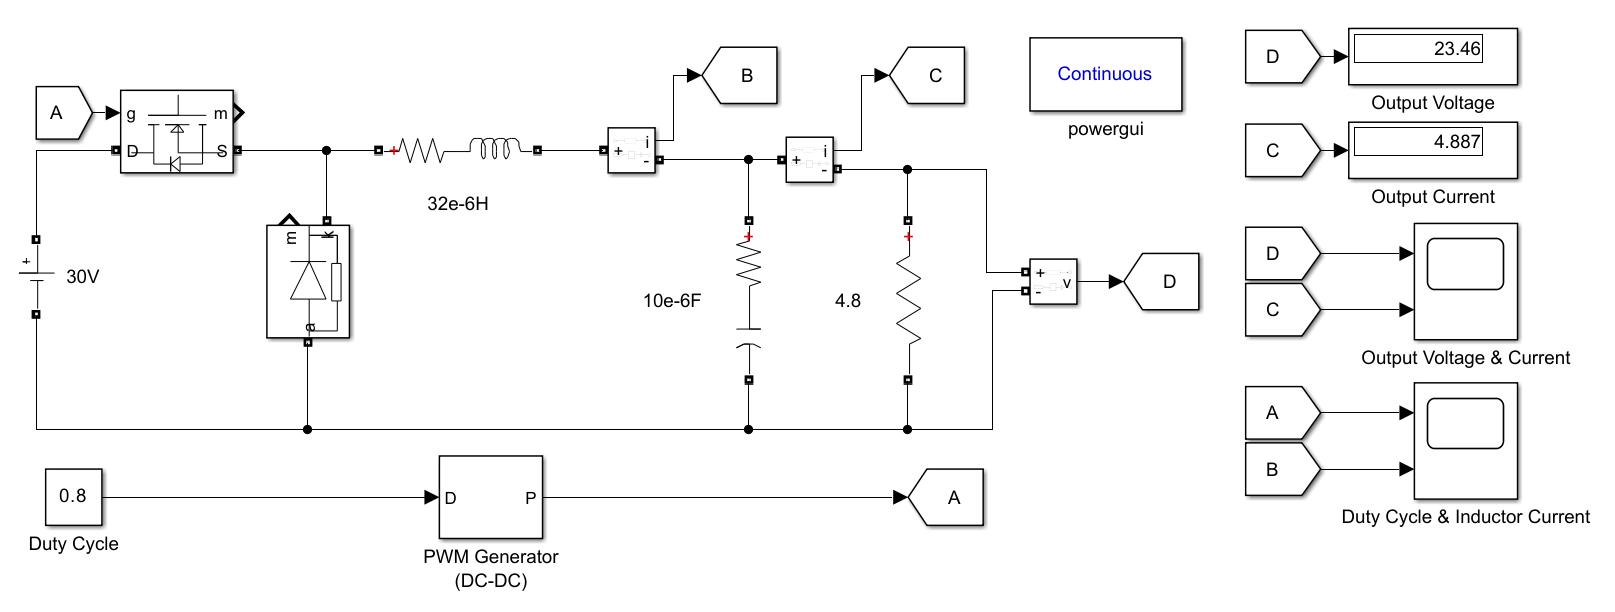
[picture p32: page 1]
