JonhRon/Non-Isolate-DC_DC-Converter/Buck_Converter/Document/Images/simulink_waveform_close_1.pdf

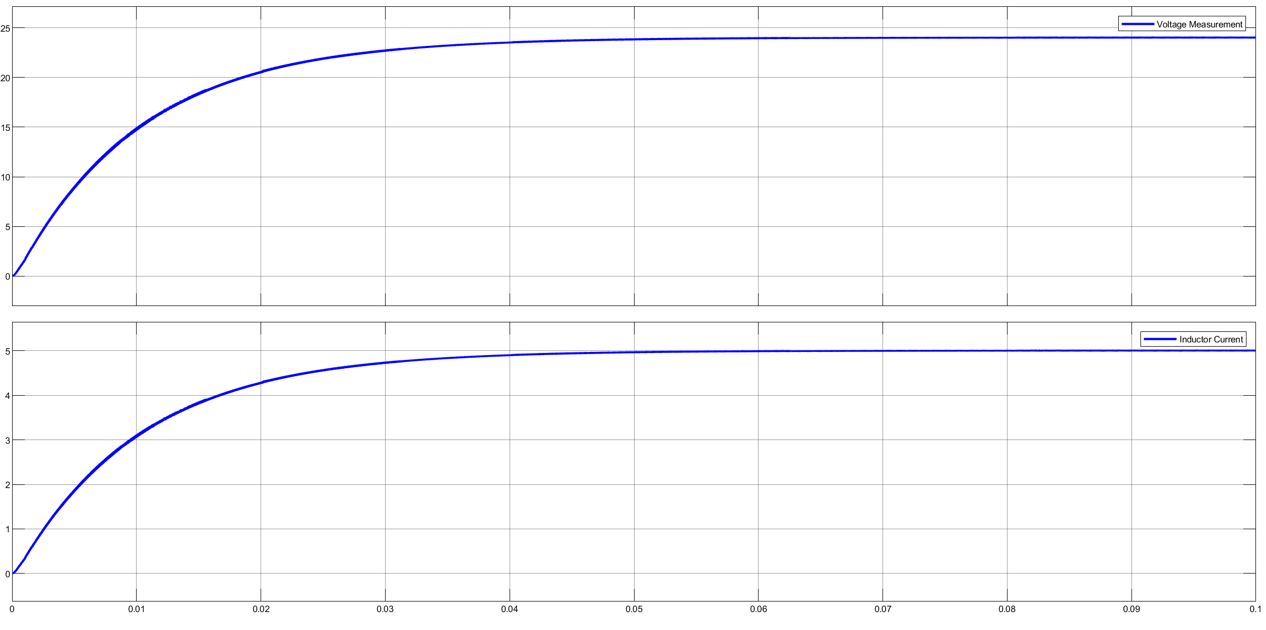
[picture p33: page 1]
