JonhRon/Non-Isolate-DC_DC-Converter/Buck_Converter/Document/Images/simulink_waveform_close_2.pdf

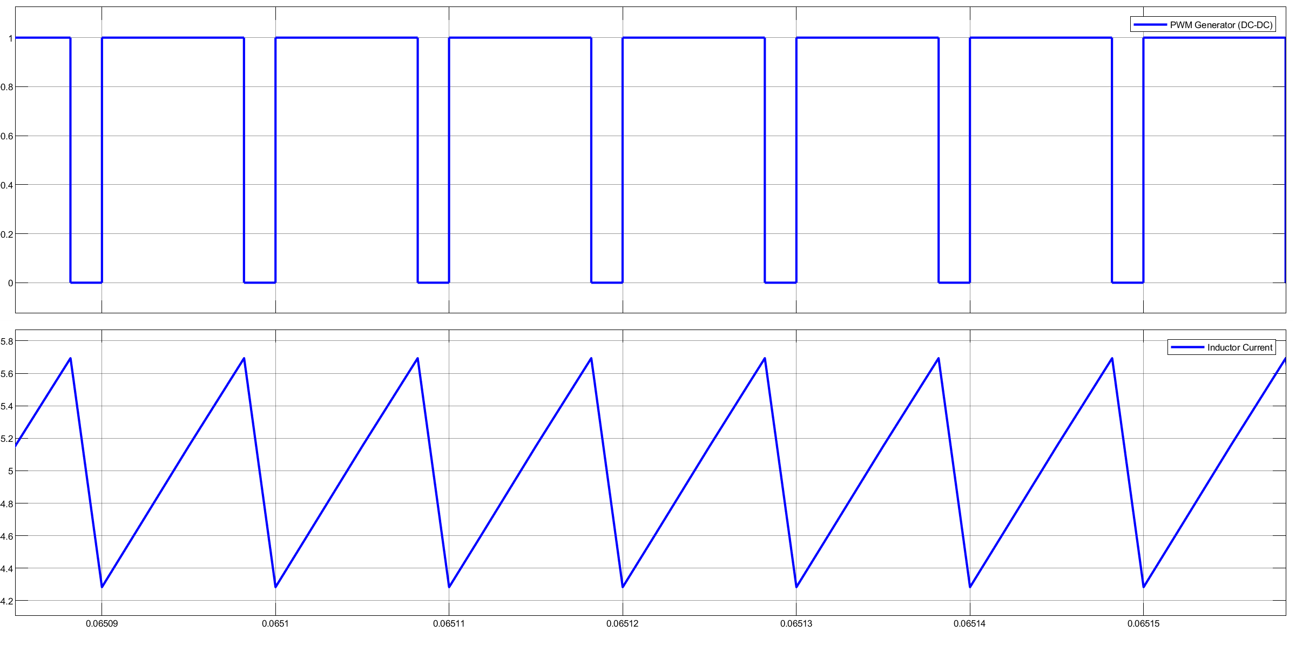
[picture p34: page 1]
