JonhRon/Non-Isolate-DC_DC-Converter/Buck_Converter/Document/Images/simulink_waveform_open_1.pdf

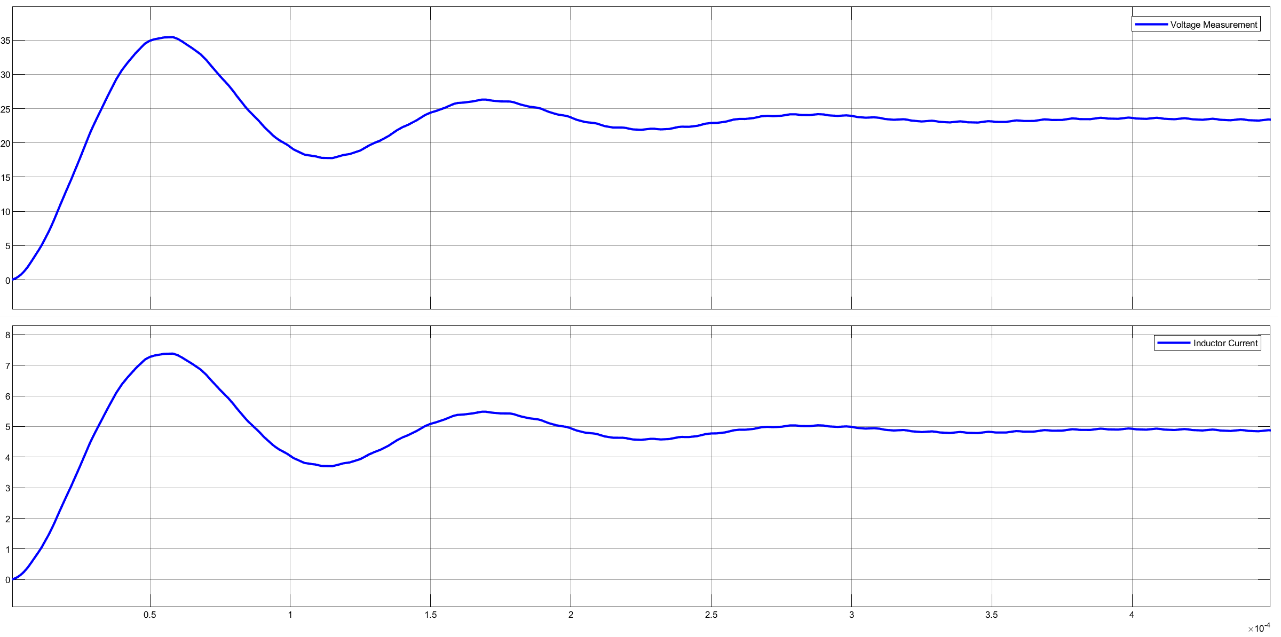
[picture p35: page 1]
