JonhRon/Non-Isolate-DC_DC-Converter/Buck_Converter/Document/Images/simulink_waveform_open_2.pdf

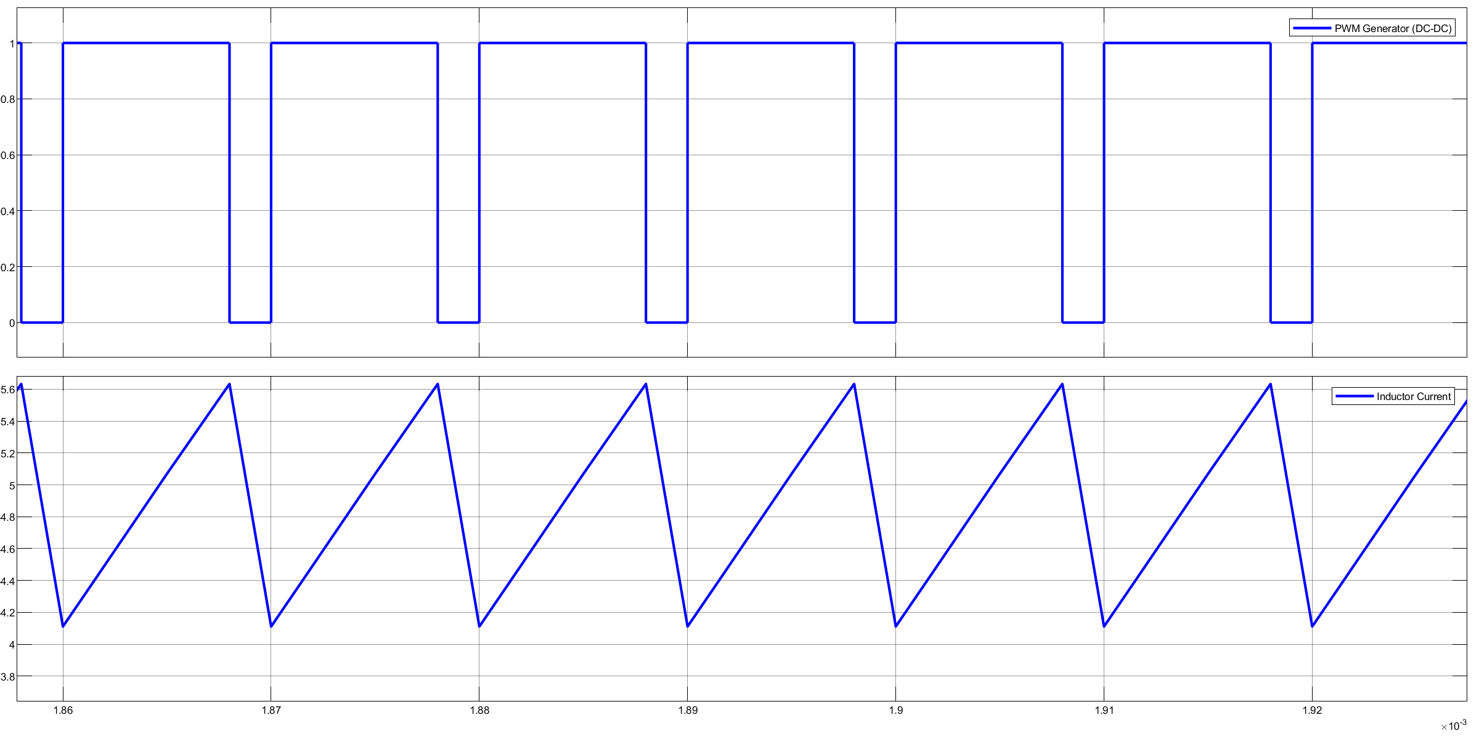
[picture p36: page 1]
