JonhRon/Non-Isolate-DC_DC-Converter/Boost_Converter/Document/Images/it_duty_inductor_cur.pdf

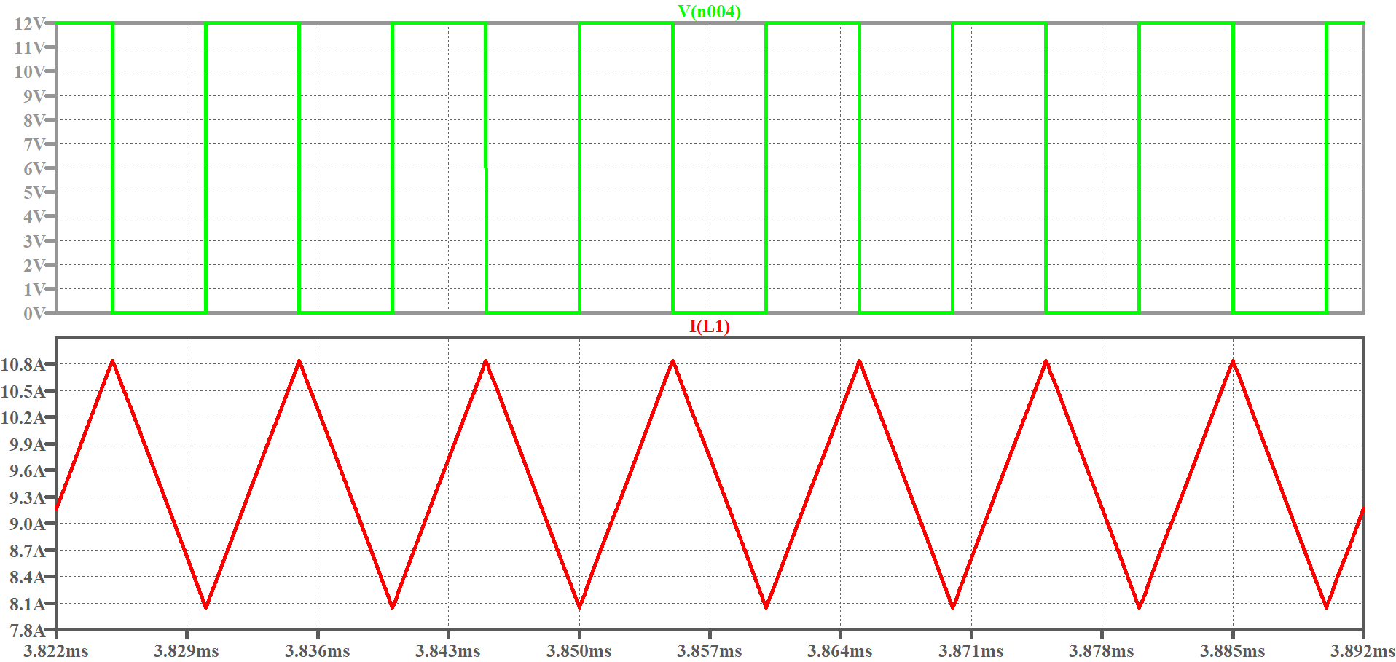
[picture p37: page 1]
