JonhRon/Non-Isolate-DC_DC-Converter/Boost_Converter/Document/Images/it_schem.pdf

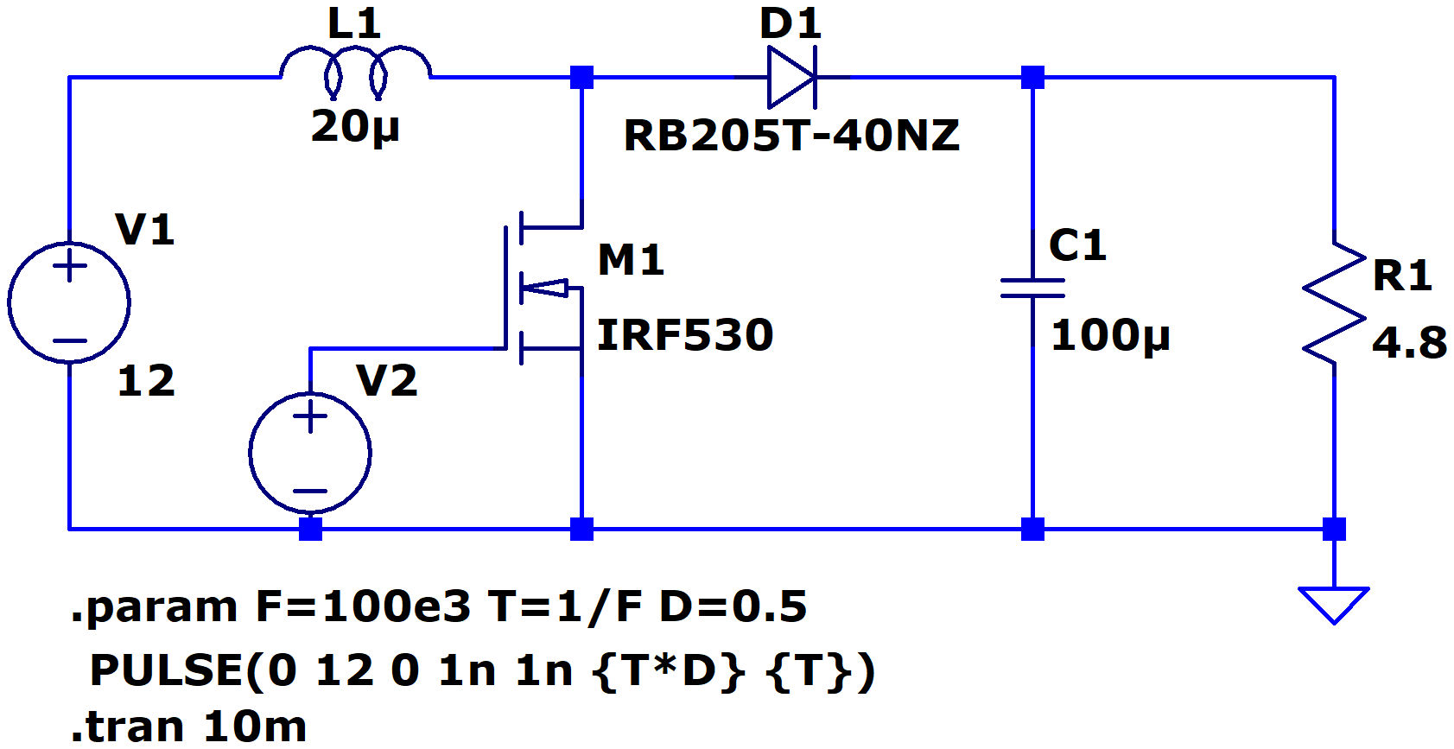
[picture p38: page 1]
