JonhRon/Non-Isolate-DC_DC-Converter/Boost_Converter/Document/Images/lt_volt_current.pdf

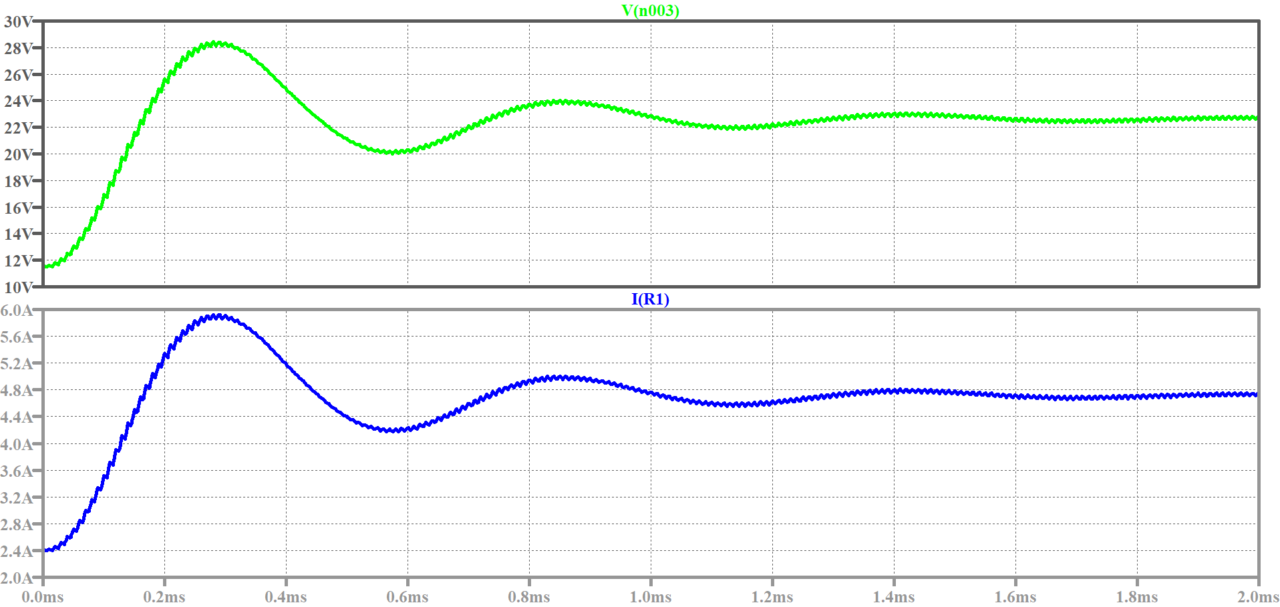
[picture p39: page 1]
