JonhRon/Non-Isolate-DC_DC-Converter/Boost_Converter/Document/Images/sim_close_duty_cur_inductor.pdf

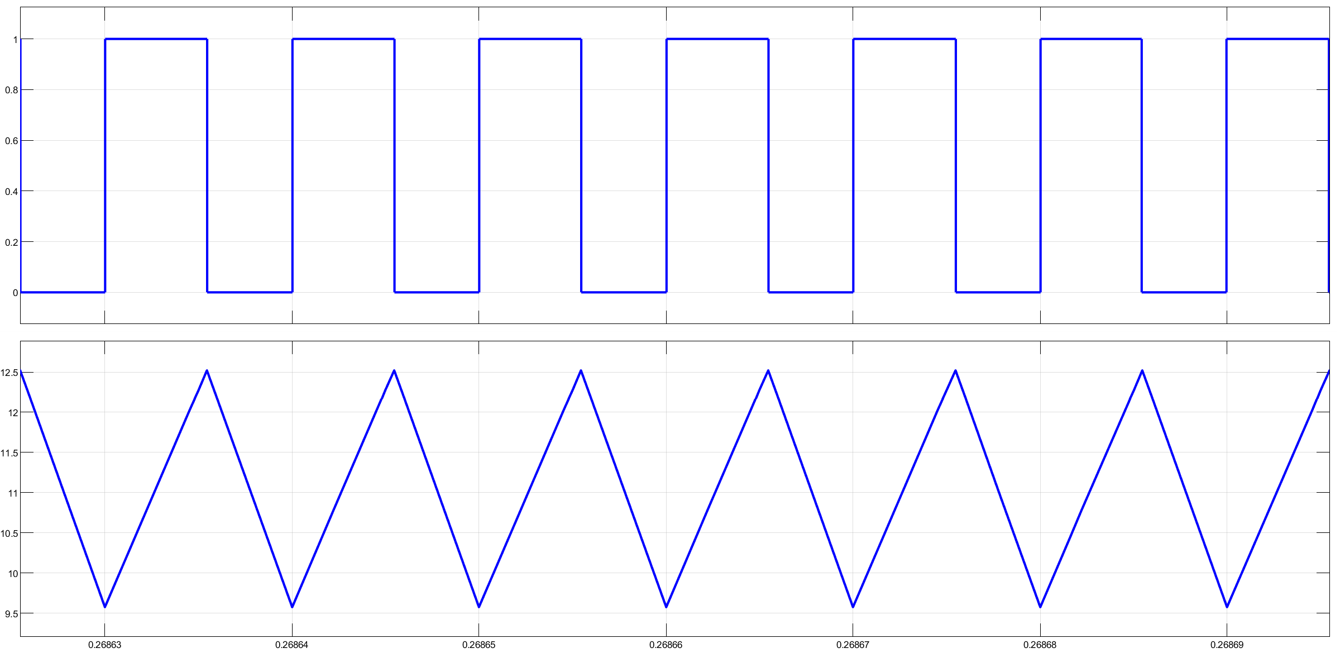
[picture p40: page 1]
