JonhRon/Non-Isolate-DC_DC-Converter/Boost_Converter/Document/Images/sim_close_schem.pdf

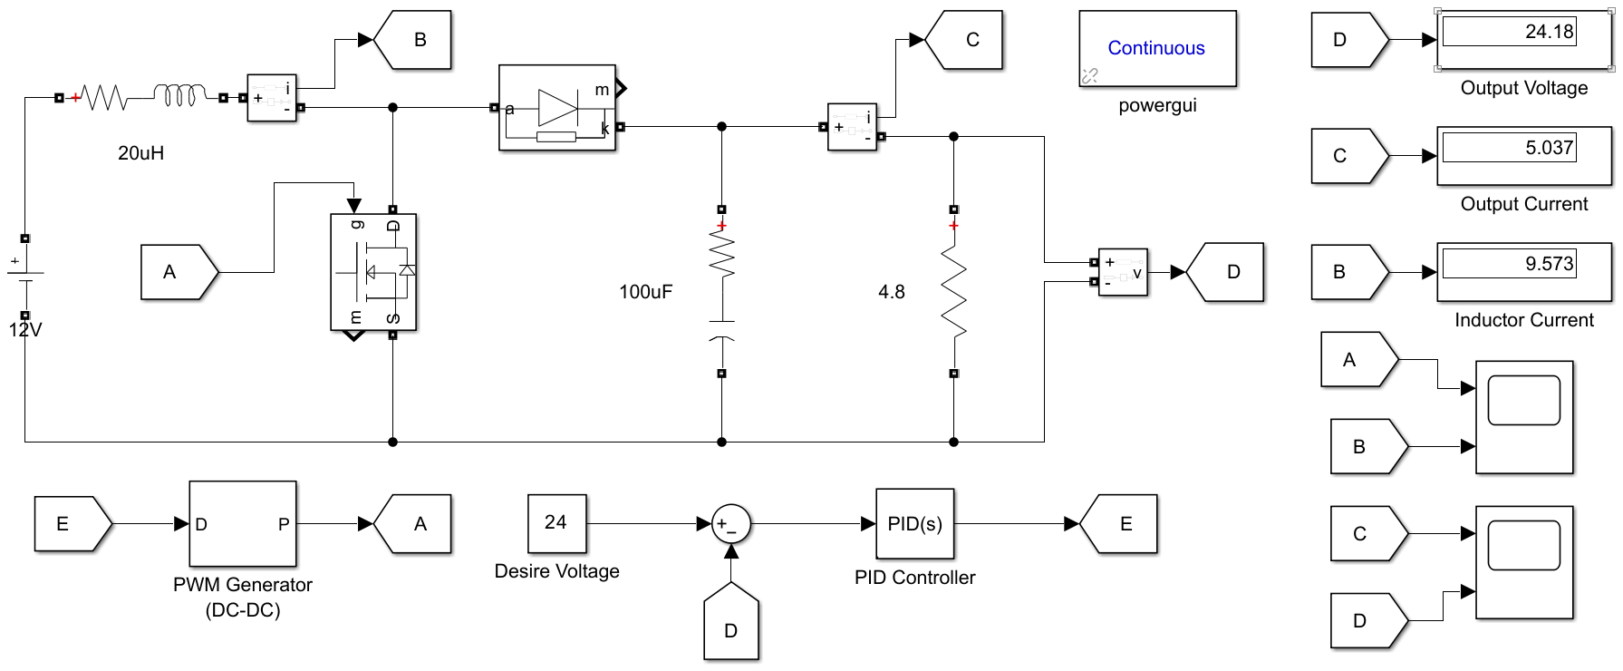
[picture p41: page 1]
