JonhRon/Non-Isolate-DC_DC-Converter/Boost_Converter/Document/Images/sim_close_volt_cur.pdf

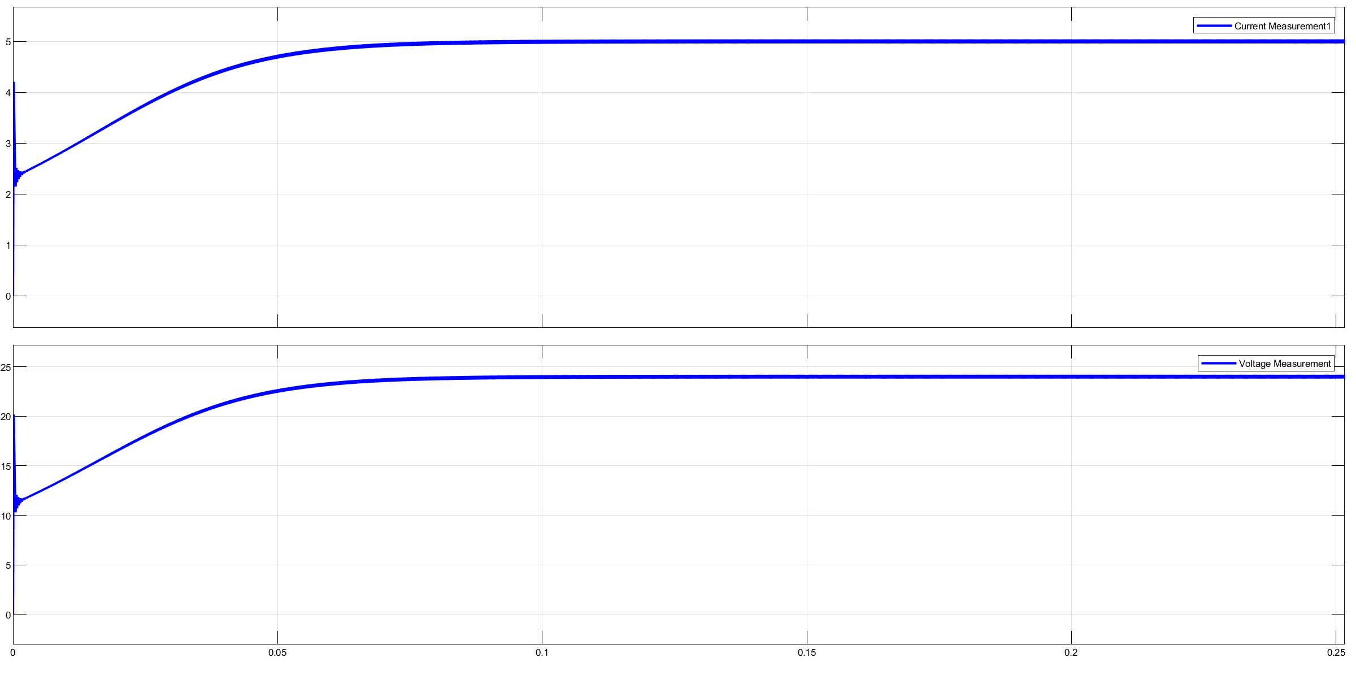
[picture p42: page 1]
