JonhRon/Non-Isolate-DC_DC-Converter/Boost_Converter/Document/Images/sim_open_duty_cur.pdf

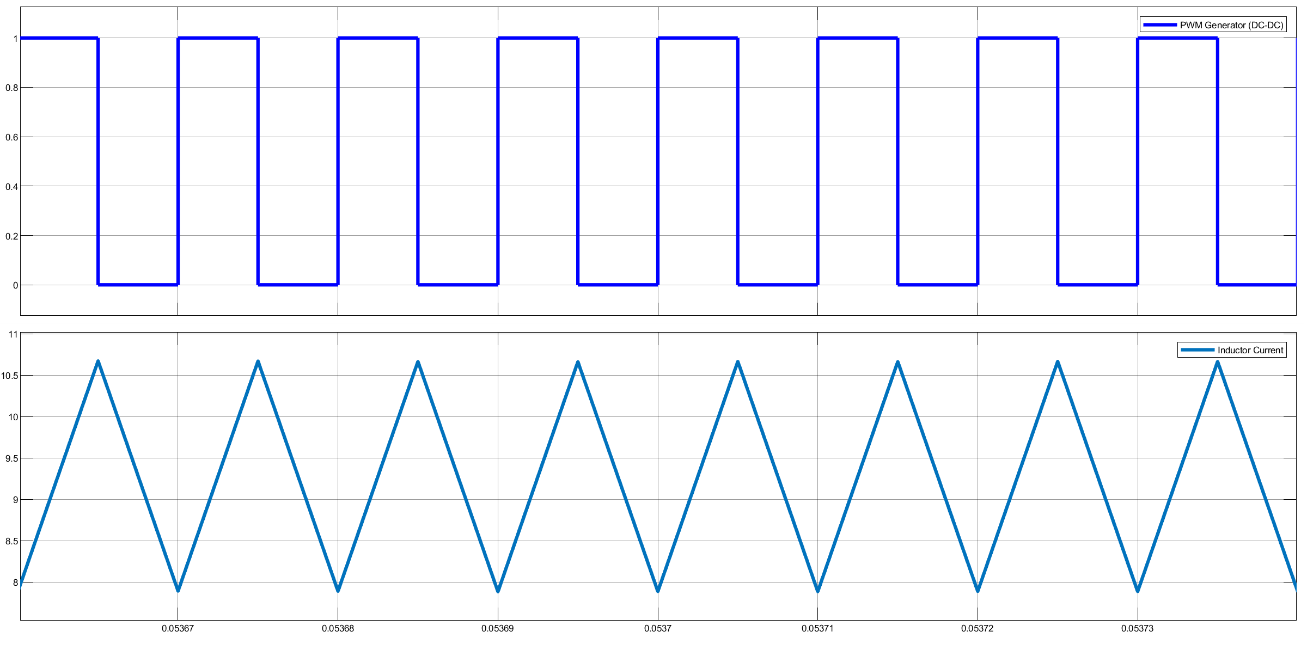
[picture p43: page 1]
