JonhRon/Non-Isolate-DC_DC-Converter/Boost_Converter/Document/Images/sim_open_schem.pdf

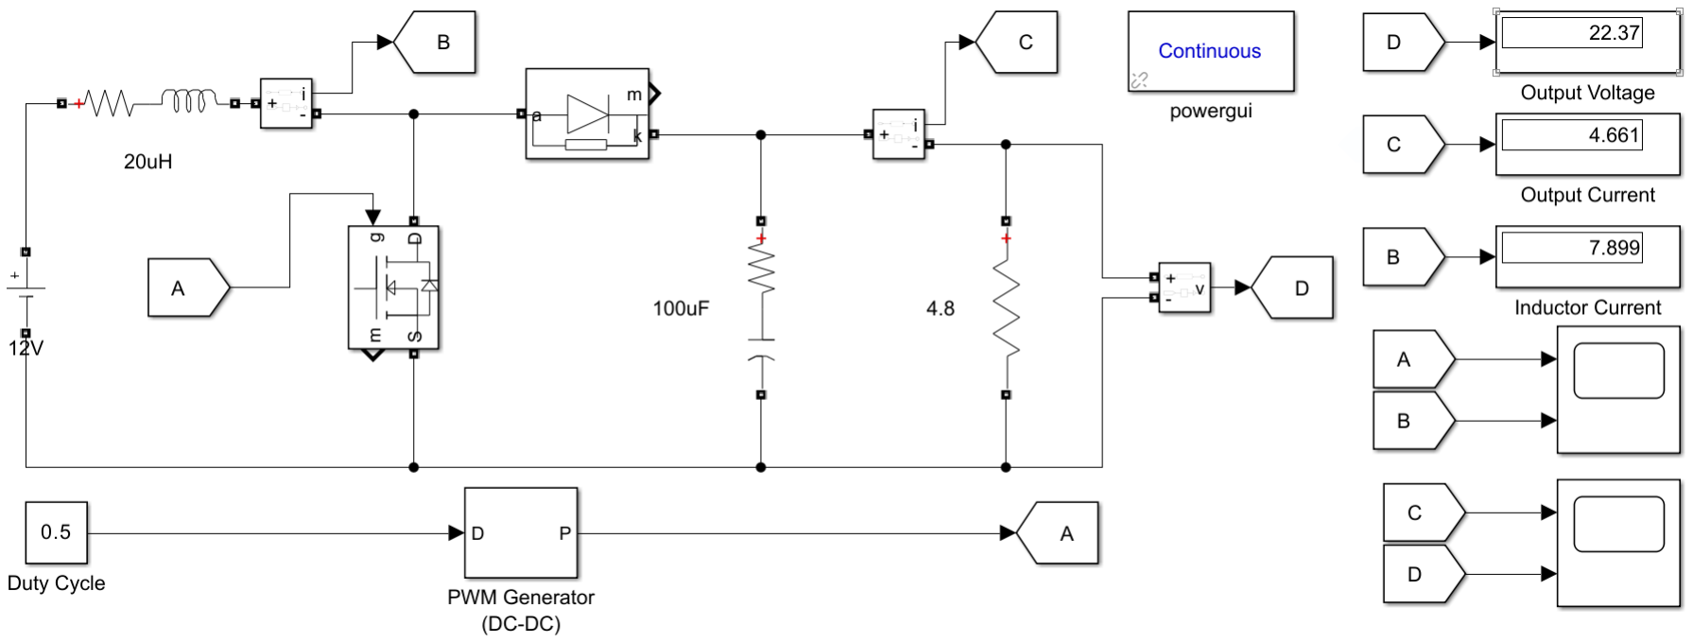
[picture p44: page 1]
