JonhRon/Non-Isolate-DC_DC-Converter/Boost_Converter/Document/Images/sim_open_volt_cur.pdf

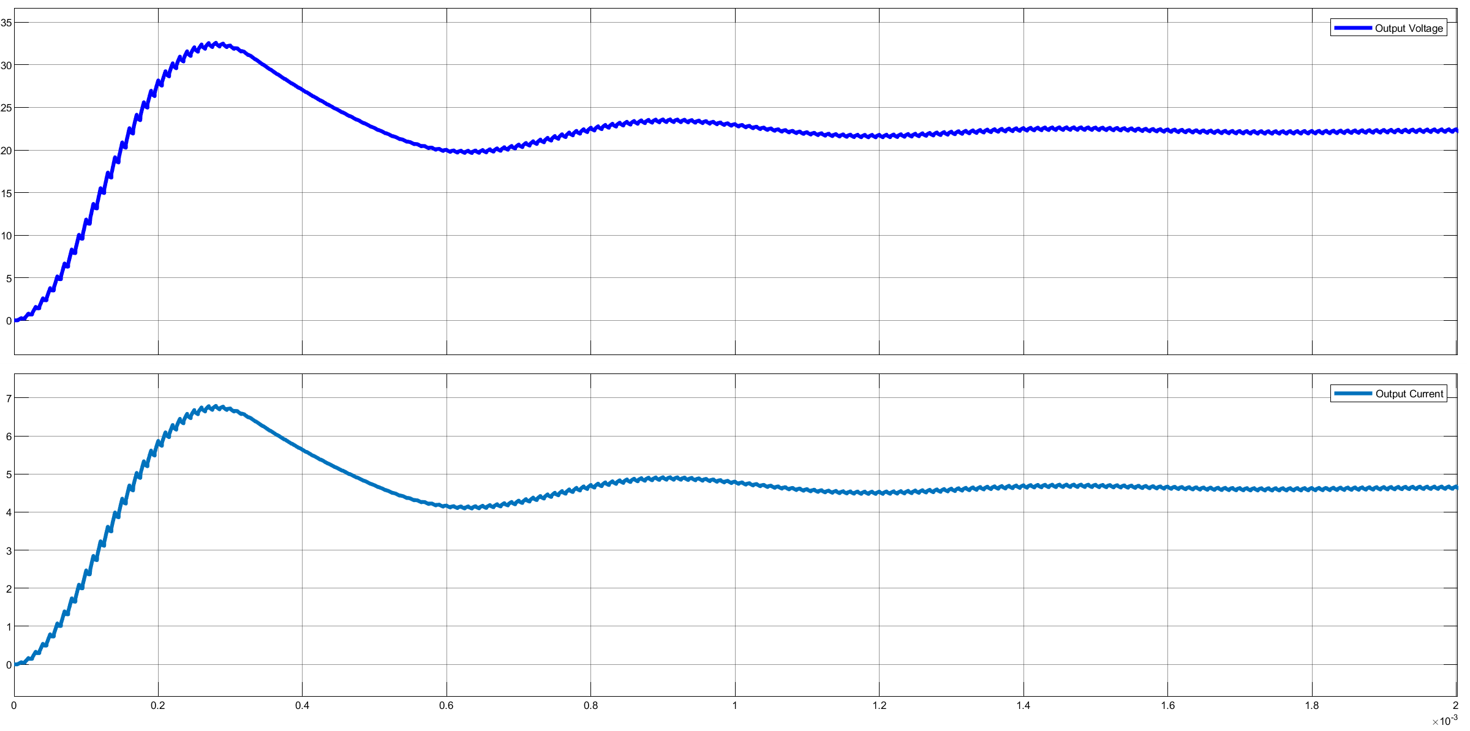
[picture p45: page 1]
