JonhRon/Non-Isolate-DC_DC-Converter/Buck_Converter/Document/Docs/buck_power_stage_calculation_v1.pdf

## Flyback Converter Power Stage Calculation

Given Parameters

- Input Voltage: Vin = 30 V
- Output Voltage: Vout = 24 V
- Output Power: Pout = 110W
- Switching Frequency: fsw = 100 kHz
- Ripple Current Rate: 30% of Iout
- Ripple Voltage Rate: 1% of Vout

Calculations

### 1. Duty Cycle (D)

D =

Vout

Vin

=

24
30

= 0.8 (80%)

### 2. Output Current (Iout)

Iout =

Pout

Vout

=

110
24

≈ 4.583 A

### 3. Output Resistance (R)

R =

Vout

Iout

=

24
4.583

≈ 5.236 Ω

### 4. Ripple Current (∆IL)

∆IL = 30% × Iout = 0.3 × 4.583 ≈ 1.375 A (peak-to-peak)

### 5. Maximum/Minimum Inductor Current

ILmax = Iout +

∆IL
2

= 4.583 + 0.6875 ≈ 5.27 A

ILmin = Iout −

∆IL
2

= 4.583 − 0.6875 ≈ 3.896 A

### 6. Ripple Voltage (∆Vout)

∆Vout = 1% × Vout = 0.01 × 24 = 0.24 V (peak-to-peak)

2

### 7. Output Capacitor (C)

C =

Iout · D

fsw · ∆Vout

=

4.583 · 0.8
100, 000 · 0.24

≈ 152.8 µF

### 8. Inductor (L)

L =

(Vin − Vout) · D
fsw · ∆IL

=

(30 − 24) · 0.8
100, 000 · 1.375

≈ 34.9 µH

### 9. MOSFET Selection

- Voltage Rating: ≥ 40 V
- Current Rating: ≥ 8 A

### 10. Diode Selection

- Voltage Rating: ≥ 40 V
- Current Rating: ≥ 5 A

Summary Table

Parameter | Value
Duty Cycle | 80% (0.8)
Output Current | 4.583 A
Output Resistance | 5.236 Ω
Ripple Current | 1.375 A (p-p)
Inductor Current (Max/Min) | 5.27 A/3.896 A
Ripple Voltage | 0.24 V (p-p)
Output Capacitor | 152.8 µF
Inductor | 34.9 µH

Notes

- The calculations assume a buck converter topology, though the ti-tle mentions a flyback converter. Flyback designs require additional parameters (e.g., transformer turns ratio).
- Thermal management is critical for MOSFET and diode.

3
