JonhRon/Non-Isolate-DC_DC-Converter/Boost_Converter/Document/Docs/boost_power_stage_cal_v1.pdf

# Boost Converter Power Stage Design

## Given Parameters

- Input Voltage: Vin = 12 V
- Output Voltage: Vout = 48 V
- Output Power: Pout = 120W
- Switching Frequency: fs = 100 kHz
- Ripple Current Rate: 30%
- Ripple Voltage Rate: 1%

## 1. Duty Cycle (D)

D = 1 −

Vin

Vout

= 1 −

12
48

= 0.75 (75%)

## 2. Output Current (Iout)

Iout =

Pout

Vout

=

120
48

= 2.5 A

## 3. Output Resistance (Rout)

Rout =

Vout

Iout

=

48
2.5

= 19.2 Ω

1

## 4. Inductor Ripple Current (∆IL)

Average Inductor Current: ILavg =

Iout
1 − D

=

2.5
1 − 0.75

= 10 A

Ripple Current: ∆IL = 0.3 × ILavg = 0.3 × 10 = 3 A

Max/Min Current: ILmax = ILavg +

∆IL
2

= 11.5 A

ILmin = ILavg −

∆IL
2

= 8.5 A

## 5. Output Capacitor (C)

∆Vout = 0.01 × Vout = 0.01 × 48 = 0.48 V

C =

Iout · D

fs · ∆Vout

=

2.5 × 0.75
100,000 × 0.48

= 39.06 µF (Use 47 µF, 63 V)

## 6. Inductor (L)

L =

Vin · D
fs · ∆IL

=

12 × 0.75
100,000 × 3

= 30 µH (Use 33 µH)

## 7. MOSFET Selection

- Voltage Rating: ≥ 48 V (Choose 60 V or 100 V)
- Current Rating: ≥ 11.5 A (Choose ≥ 15 A)
- Example: IRF540N (100 V, 33 A)

## 8. Diode Selection

- Reverse Voltage: ≥ 48 V (Choose 60 V or 100 V)
- Current Rating: ≥ 2.5 A (Peak ≥ 11.5 A)

2

- Example: STPS20H100CT (100 V, 20 A Schottky)

## Component Summary

Component | Value/Part | Specification
Inductor | 33 µH | Saturation current ≥ 12 A
Capacitor | 47 µF, 63 V | Low ESR
MOSFET | IRF540N | 100 V, 33 A
Diode | STPS20H100CT | 100 V, 20 A Schottky

3
