JonhRon/Non-Isolate-DC_DC-Converter/Boost_Converter/Document/Images/hardware/3D.png

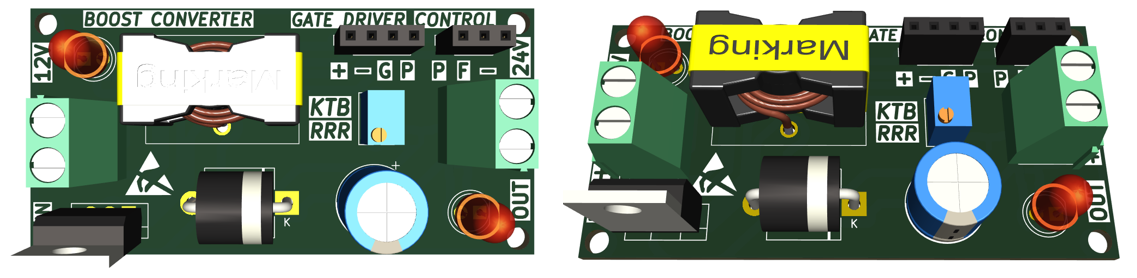
Boost_Converter/Document/Images/hardware/3D.png
