JonhRon/Non-Isolate-DC_DC-Converter/Boost_Converter/Document/Images/hardware/gate.png

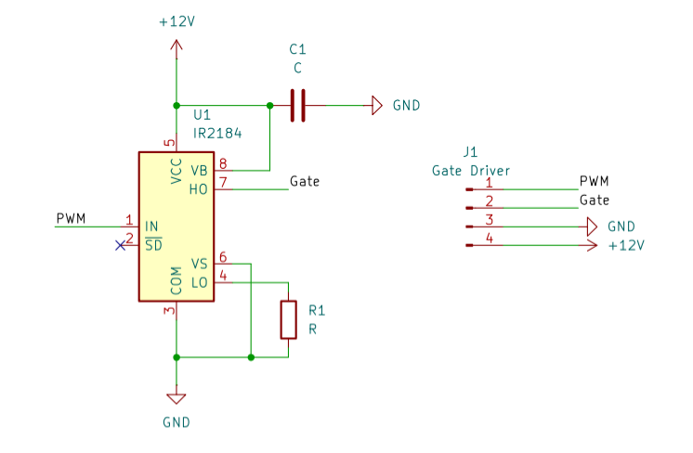
Boost_Converter/Document/Images/hardware/gate.png
