JonhRon/Non-Isolate-DC_DC-Converter/Boost_Converter/Document/Images/hardware/gate_3d.png

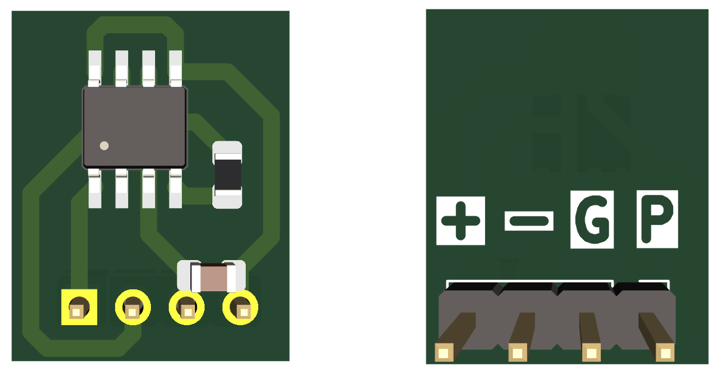
Boost_Converter/Document/Images/hardware/gate_3d.png
