JonhRon/Non-Isolate-DC_DC-Converter/Boost_Converter/Document/Images/hardware/gate_pcb.png

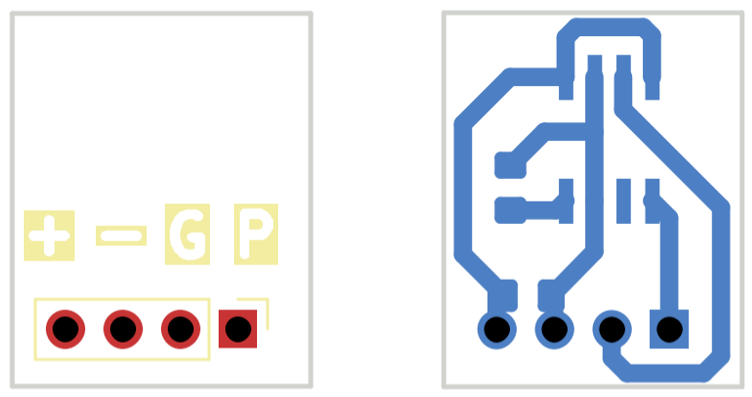
Boost_Converter/Document/Images/hardware/gate_pcb.png
