JonhRon/Non-Isolate-DC_DC-Converter/Boost_Converter/Document/Images/hardware/pcb.png

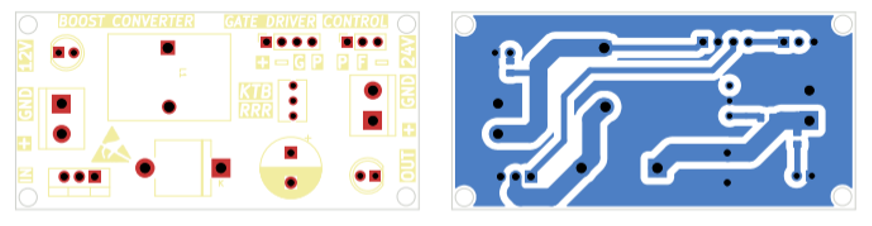
Boost_Converter/Document/Images/hardware/pcb.png
