JonhRon/Non-Isolate-DC_DC-Converter/Buck_Converter/Document/Component/diode.pdf

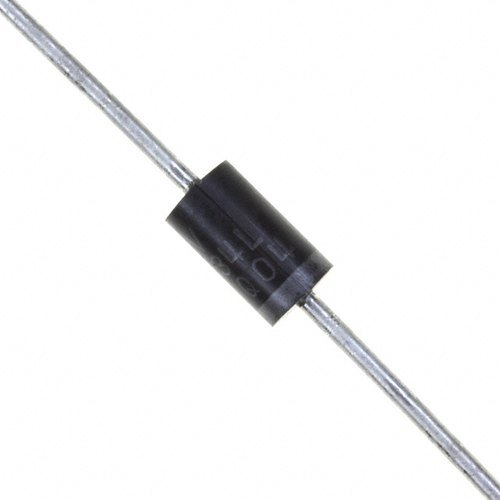
[picture p51: page 1]
