JonhRon/Non-Isolate-DC_DC-Converter/Boost_Converter/Document/Images/testing/5W.jpg

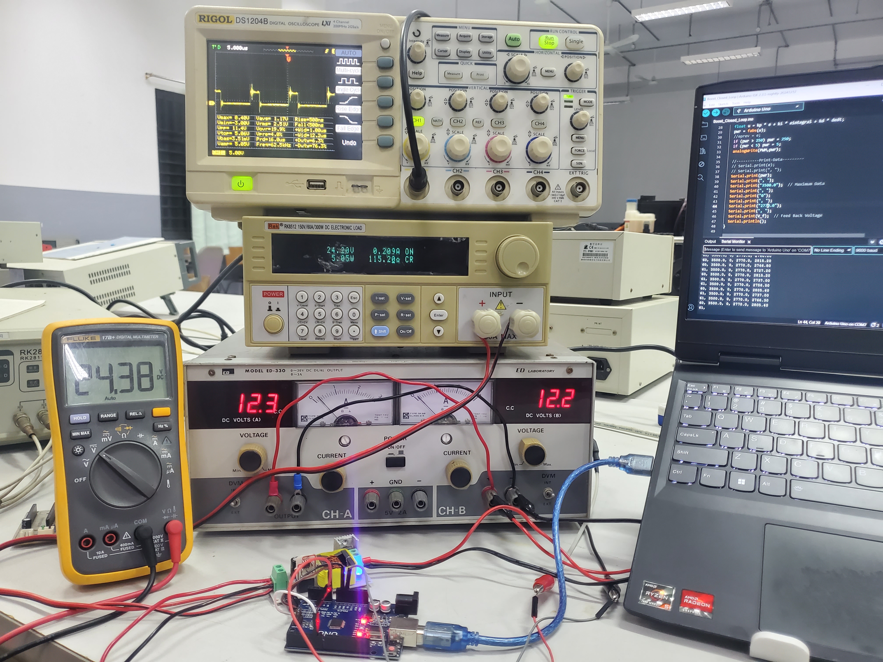
Boost_Converter/Document/Images/testing/5W.jpg
