JonhRon/Non-Isolate-DC_DC-Converter/Boost_Converter/Document/Images/testing/20W.jpg

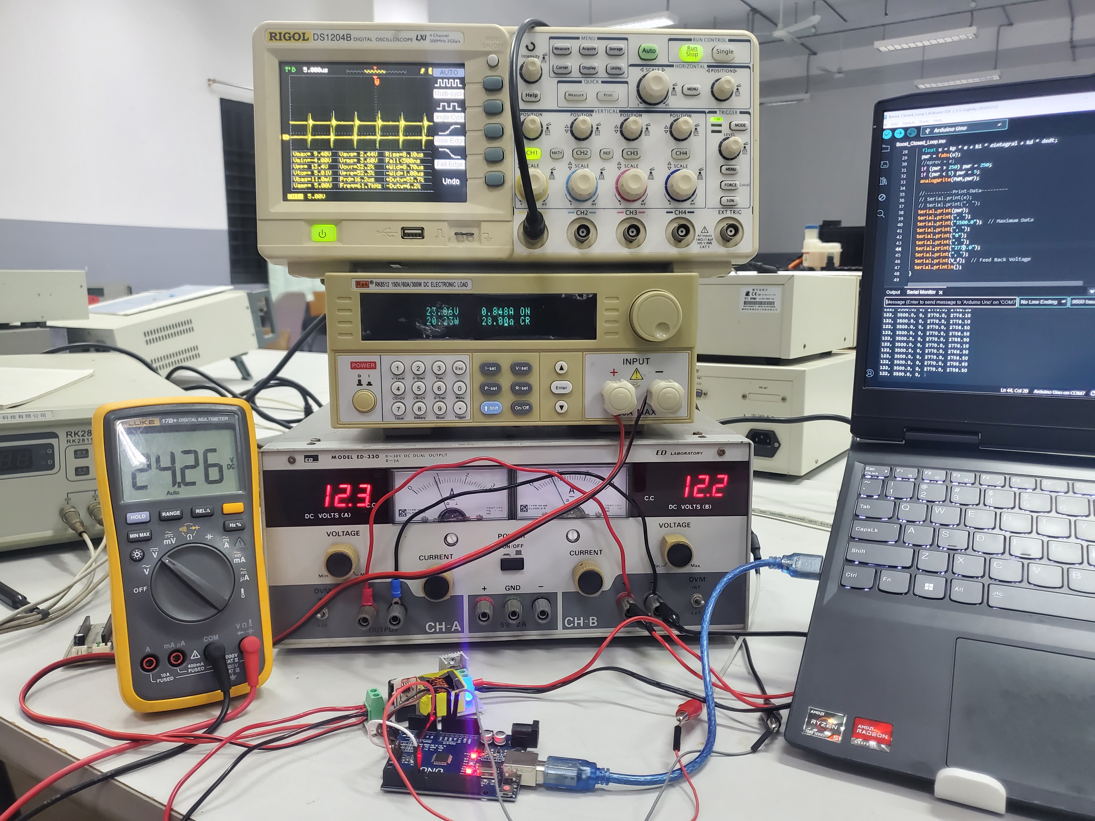
Boost_Converter/Document/Images/testing/20W.jpg
