JonhRon/Non-Isolate-DC_DC-Converter/Boost_Converter/Document/Images/testing/30W.jpg

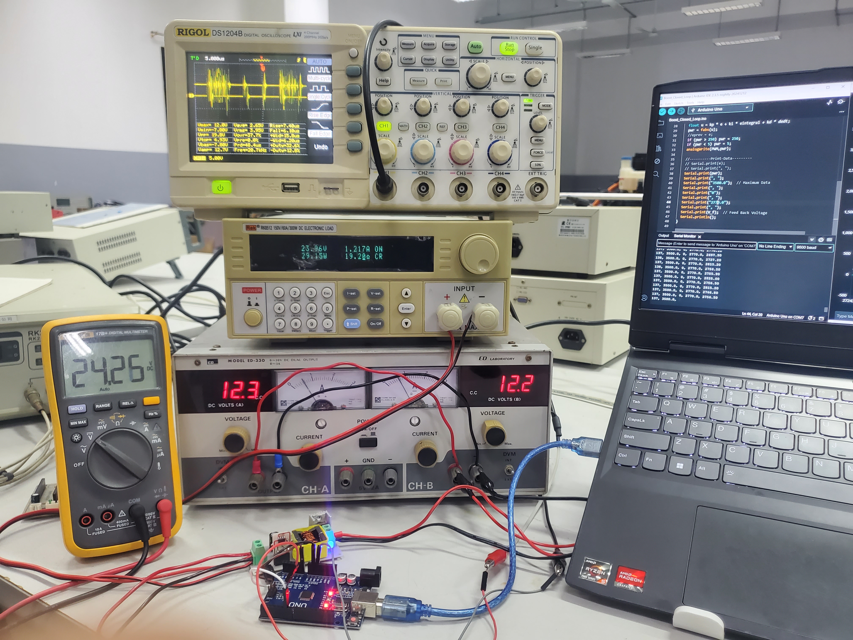
Boost_Converter/Document/Images/testing/30W.jpg
