JonhRon/Non-Isolate-DC_DC-Converter/Boost_Converter/Document/Images/testing/50W.jpg

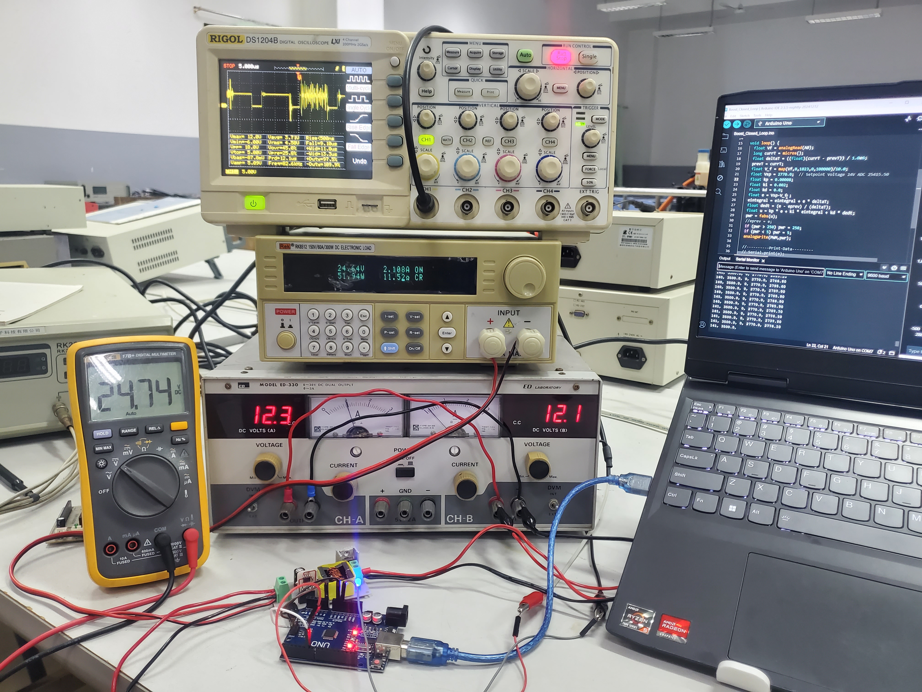
Boost_Converter/Document/Images/testing/50W.jpg
