JonhRon/Non-Isolate-DC_DC-Converter/Boost_Converter/Document/Images/testing/65W.jpg

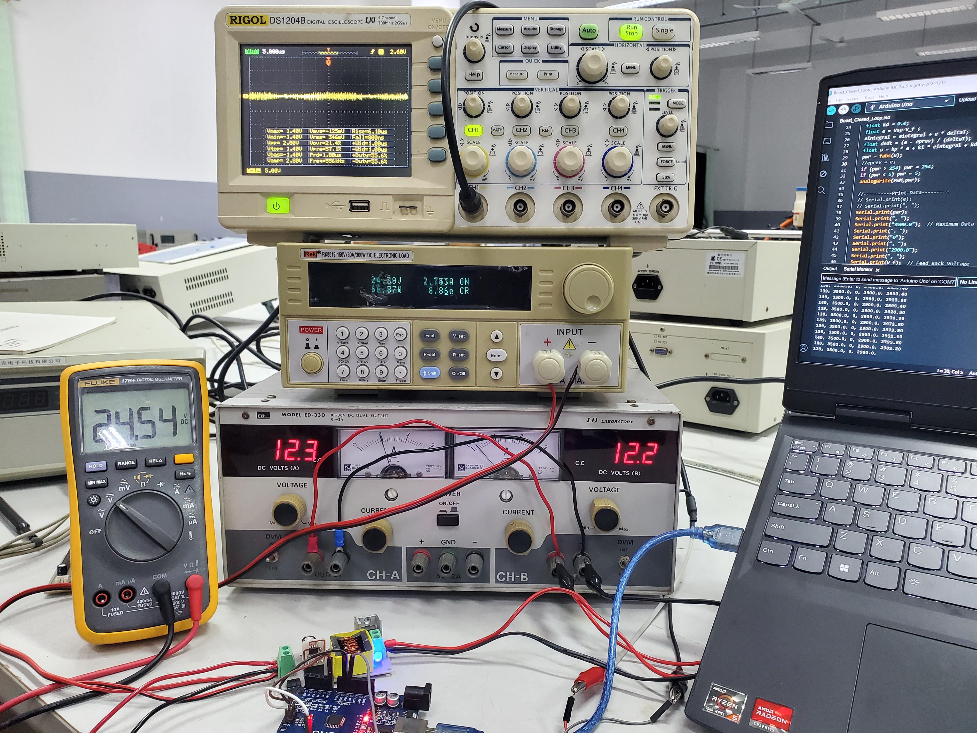
Boost_Converter/Document/Images/testing/65W.jpg
