JonhRon/Non-Isolate-DC_DC-Converter/Boost_Converter/Document/Images/testing/data.png

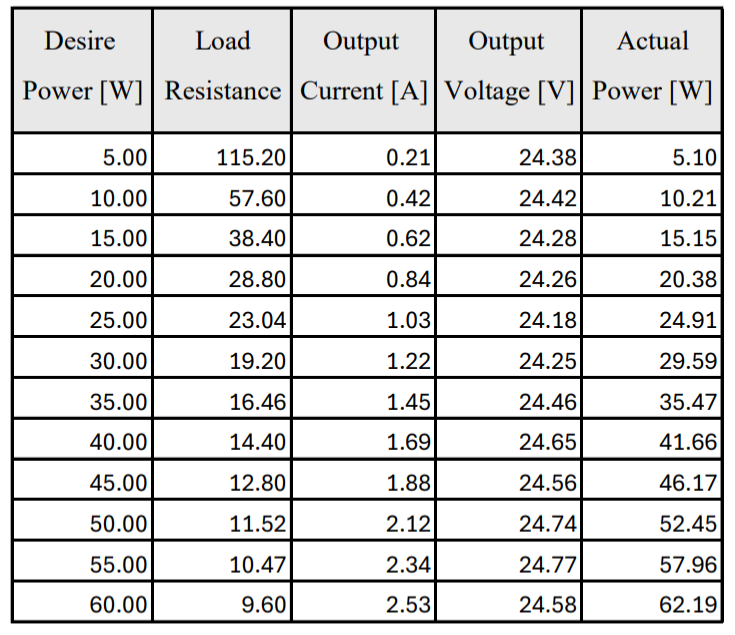
Boost_Converter/Document/Images/testing/data.png
