JonhRon/Non-Isolate-DC_DC-Converter/Report Power Suppy Testing/pics/3.png

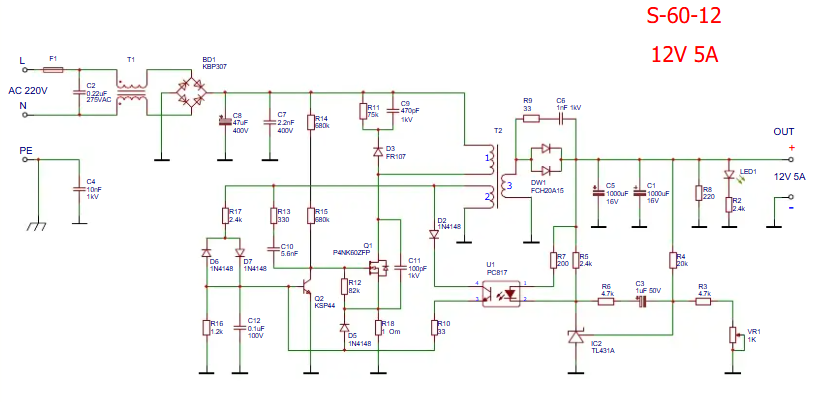
Report Power Suppy Testing/pics/3.png
