JonhRon/Non-Isolate-DC_DC-Converter/Report Power Suppy Testing/testing/10W.jpg

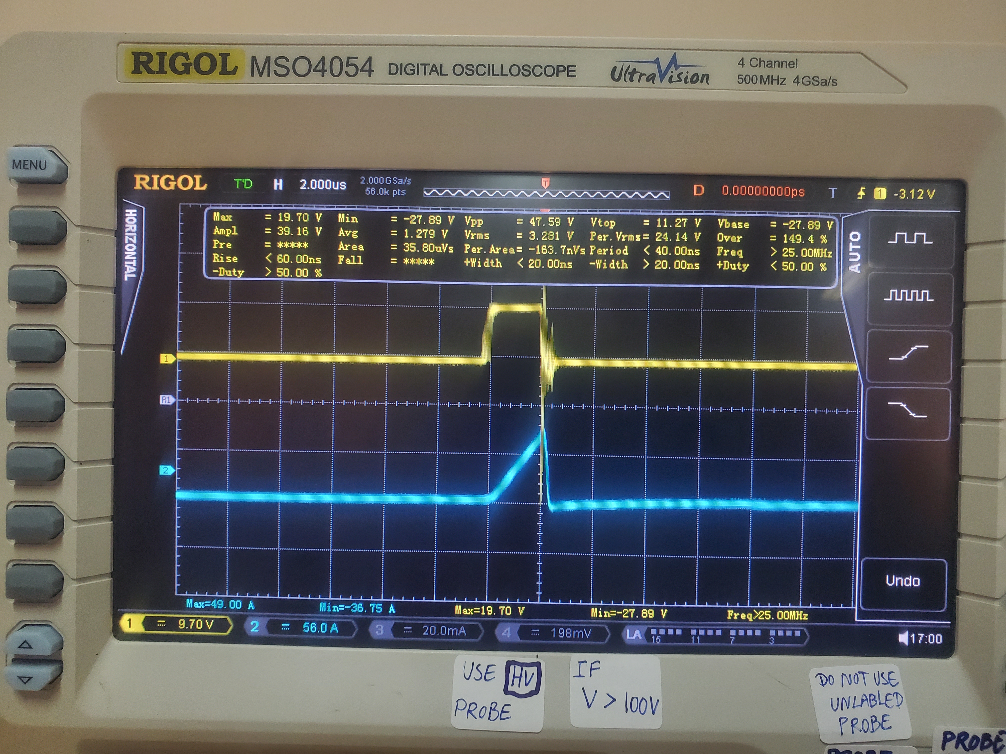
Report Power Suppy Testing/testing/10W.jpg
