JonhRon/Non-Isolate-DC_DC-Converter/Boost_Converter/Document/Images/hardware/full.pdf

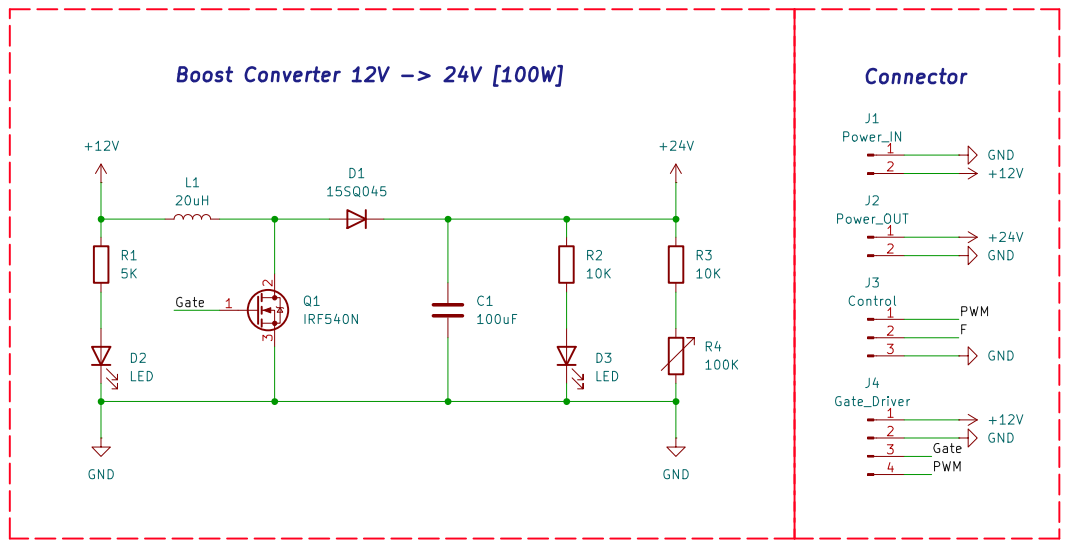
[picture p83: page 1]
