JonhRon/Non-Isolate-DC_DC-Converter/Boost_Converter/Document/Images/hardware/full_bottom4.pdf

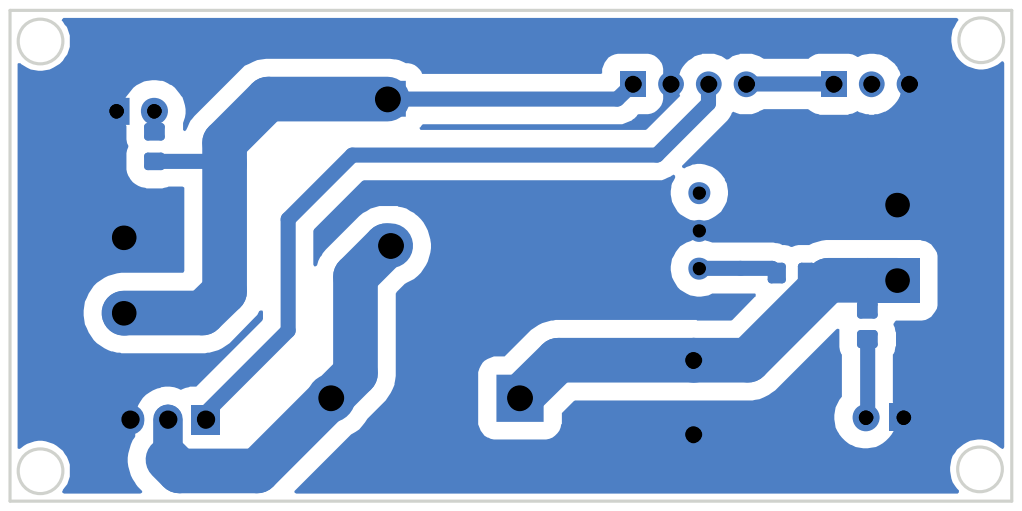
[picture p84: page 1]
