JonhRon/Non-Isolate-DC_DC-Converter/Boost_Converter/Document/Images/hardware/full_top.pdf

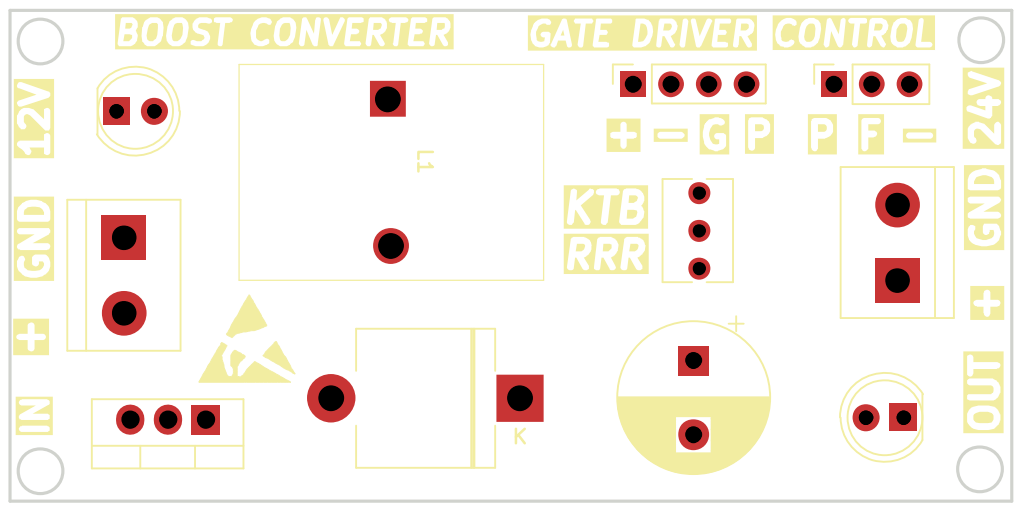
[picture p85: page 1]
