JonhRon/Non-Isolate-DC_DC-Converter/Boost_Converter/Document/Images/hardware/gate.pdf

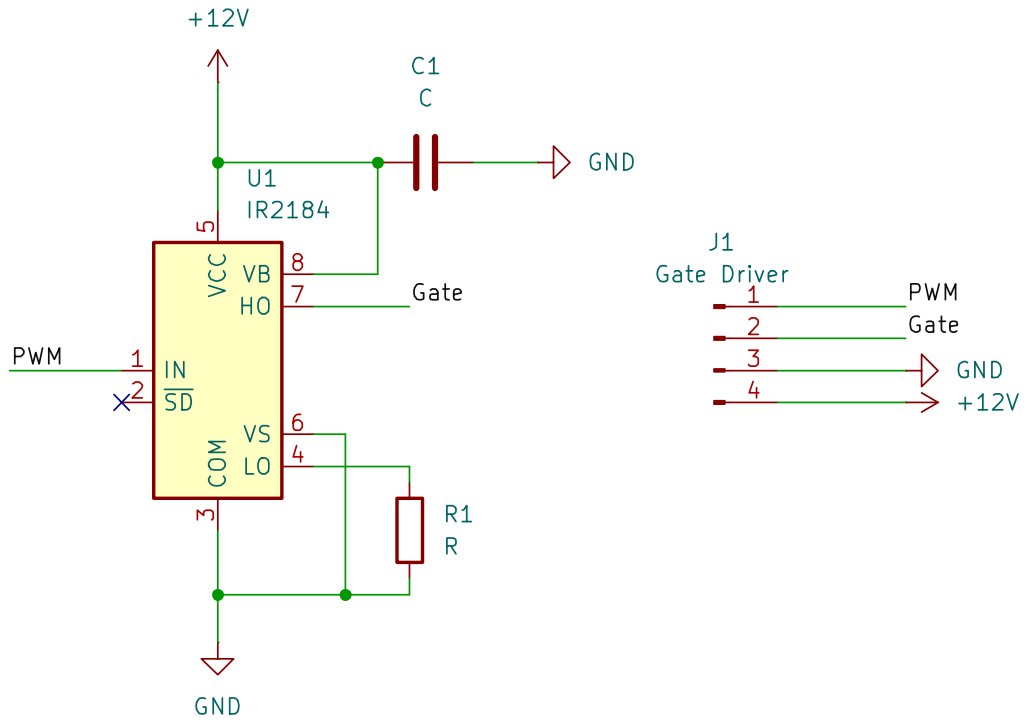
[picture p86: page 1]
