JonhRon/Non-Isolate-DC_DC-Converter/Boost_Converter/Document/Images/hardware/schem.pdf

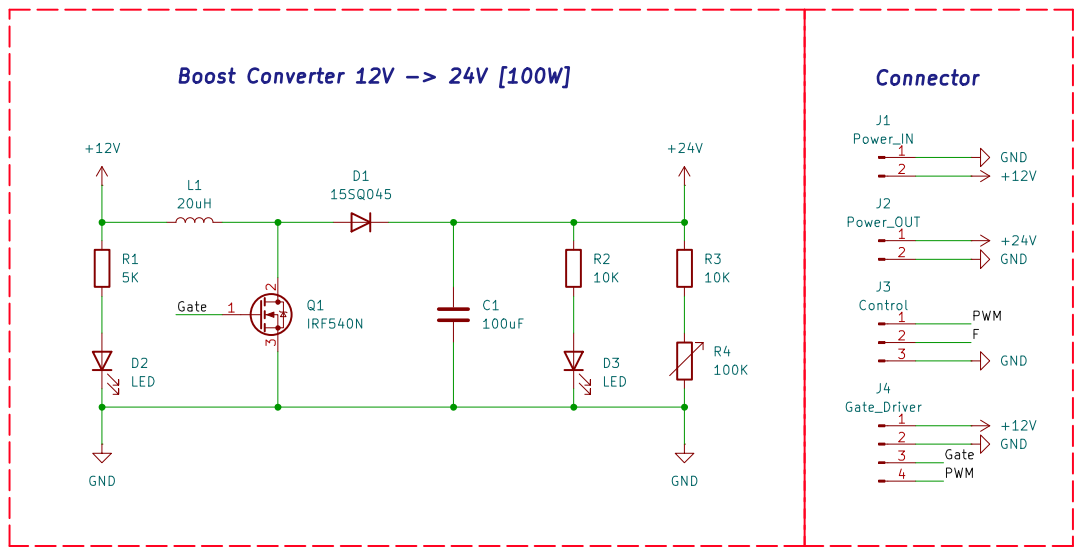
[picture p87: page 1]
