JonhRon/Non-Isolate-DC_DC-Converter/Buck_Converter/Document/Images/EE16_core.pdf

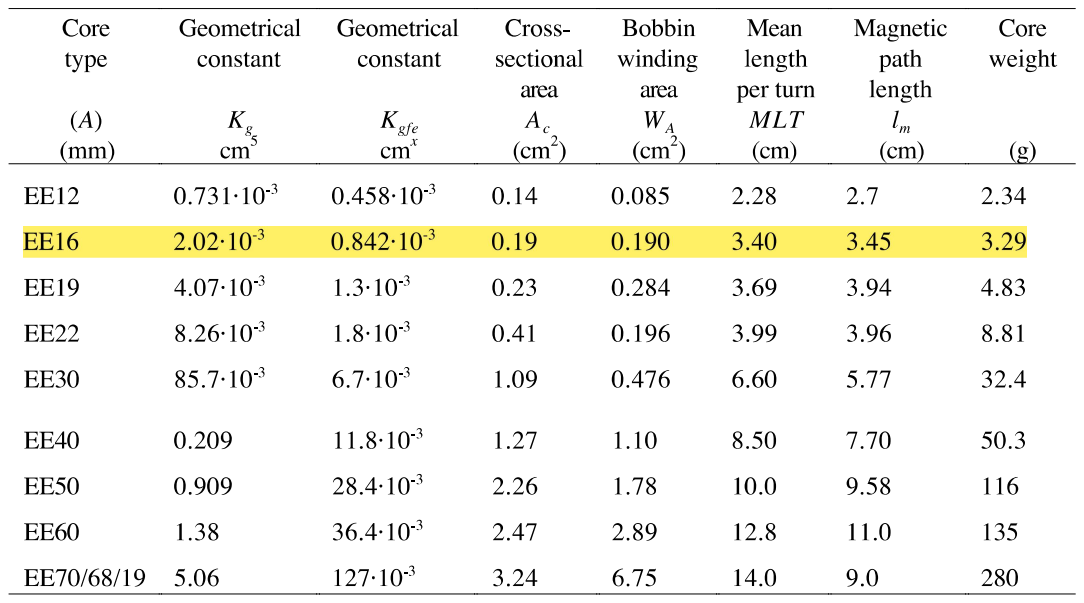
[picture p88: page 1]
