JonhRon/Non-Isolate-DC_DC-Converter/Buck_Converter/Document/Images/EE19_core.pdf

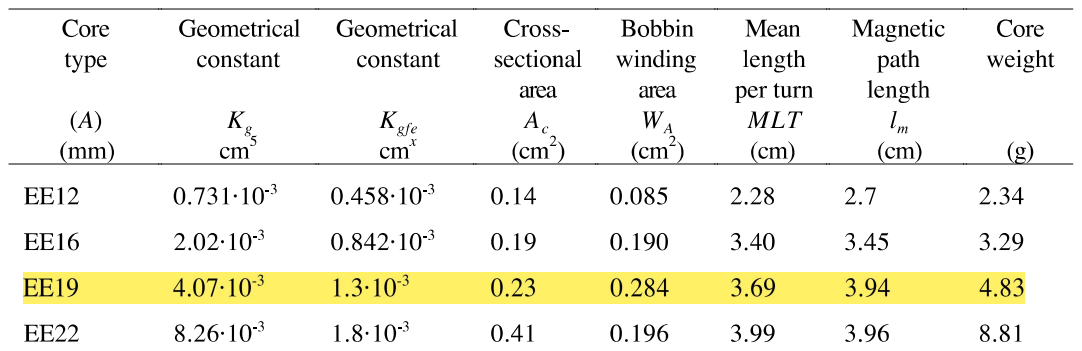
[picture p89: page 1]
