JonhRon/Non-Isolate-DC_DC-Converter/Gate_Driver/PMOS_Gate.asc

M1: pmos; IRF7404
Q1: npn; 2N2222
Q2: pnp; 2N2907
Q3: npn; 2N2222
R1: res; 1k
R2: res; 10
R3: res; 100
R4: res; 1k
V1: voltage; PULSE(0 3.3 0 1n 1n {T*D} {T})
V2: voltage; 3.3
V3: voltage; 30
Named nets: 0
.param Fs=100e3 D=0.5 T=1/Fs
.tran 0.25m
