JonhRon/Non-Isolate-DC_DC-Converter/Buck_Converter/Simulation/LTspice/buck_converter.asc

C1: cap; 10µF
D1: diode; MBR20100CT
L1: ind; 32µH
M1: pmos; IRF9640
Q1: npn; BC547C
Q2: npn; BC547B
Q3: pnp; BC557B
R1: res; 4.8
R2: res; 10
R3: res; 1K
R4: res; 100
V1: voltage; PULSE(0 3.3 0 1n 1n {T*D} {T})
V2: voltage; 30
Named nets: 0
.param F=100e3 T=1/F D=0.8
.tran 500m
