JonhRon/Non-Isolate-DC_DC-Converter/Buck_Converter/Simulation/LTspice/buck_converter_v3.asc

C1: cap; 10µF; V=50 Rser=0.001
D1: diode; RB205T-40NZ
L1: ind; 32µH; Ipk=7 Rser=0.001
M1: nmos; IRF9410
R1: res; 4.8
V1: voltage; 30
V2: voltage; PULSE(0 30 {T/2} 1n 1n {T*D} {T})
Named nets: 0
.param Fs=100e3 T=1/Fs D=0.8
.tran 10m
