JonhRon/Non-Isolate-DC_DC-Converter/Boost_Converter/Simulation/LTspice/boost_converter.asc

C1: cap; 100µ
D1: diode; RB205T-40NZ
L1: ind; 20µ
M1: nmos; IRF530
R1: res; 4.8
V1: voltage; 12
V2: voltage; PULSE(0 12 0 1n 1n {T*D} {T})
Named nets: 0
.param F=100e3 T=1/F D=0.5
.tran 100m
