JonhRon/Non-Isolate-DC_DC-Converter/Boost_Converter/Simulation/LTspice/Draft1.asc

C1: cap
D1: diode
L1: ind
M1: nmos
R1: res
V1: voltage
V2: voltage
Named nets: 0
