JonhRon/Non-Isolate-DC_DC-Converter/(list of files, drawings)

Other design files:
Buck_Converter/Simulation/protues/boost.pdsprj
Buck_Converter/Simulation/protues/buck.pdsprj
Buck_Converter/Simulation/protues/buck_1.pdsprj
Buck_Converter/Simulation/protues/Project Backups/buck [20250702, 15-20-02].pdsprj
