JonhRon/Non-Isolate-DC_DC-Converter/Gate_Driver/PCB_Design/nmos_gate_ir2182/nmos_gate_ir2182.kicad_pcb

## KiCad design Gate_Driver/PCB_Design/nmos_gate_ir2182/nmos_gate_ir2182.kicad_pcb (2026-07-28)

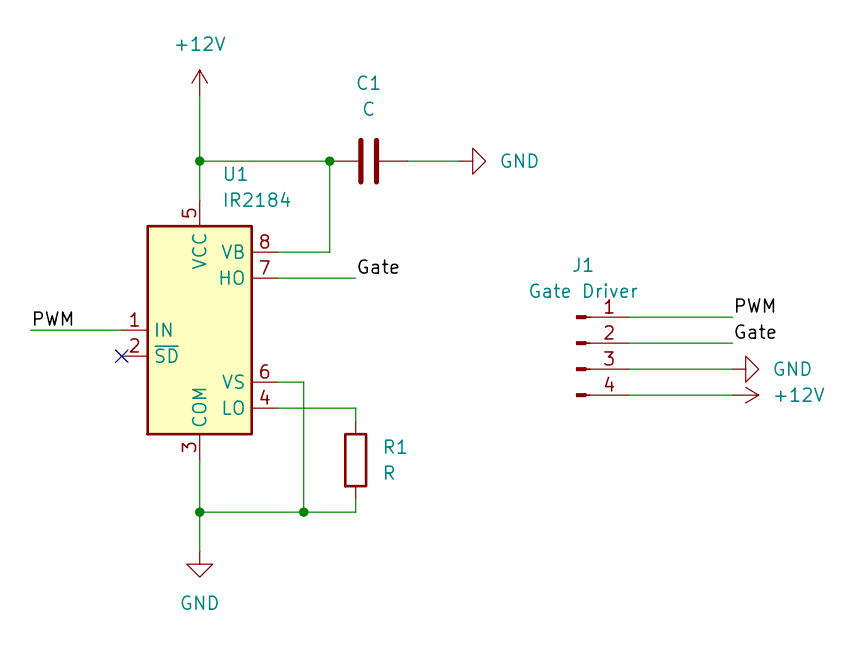
[picture p90: schematic nmos_gate_ir2182.kicad_sch]

Parts:
C1: C; C_0805_2012Metric_Pad1.18x1.45mm_HandSolder
J1: Gate Driver; PinHeader_1x04_P2.54mm_Vertical
R1: R; R_0805_2012Metric_Pad1.20x1.40mm_HandSolder
U1: IR2184; PowerIntegrations_SO-8

Connections:
+12V: C1.1, J1.4, U1.5 (VCC), U1.8 (VB)
/Gate: J1.2, U1.7 (HO)
/PWM: J1.1, U1.1 (IN)
GND: C1.2, J1.3, R1.2, U1.3 (COM), U1.6 (VS)
unnamed: R1.1, U1.4 (LO)

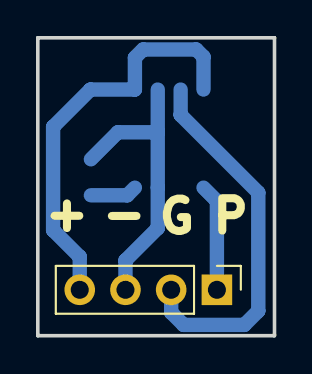
[picture p91: board nmos_gate_ir2182.kicad_pcb from above]

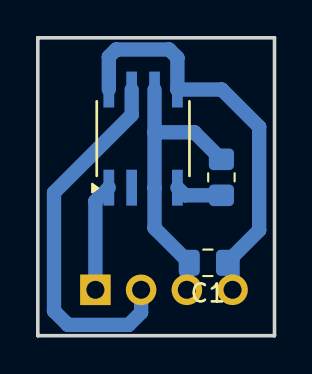
[picture p92: board nmos_gate_ir2182.kicad_pcb from below]

Board: 2 copper layers, 13.2 x 16.6 mm, 4 parts (3 on the bottom side), 5 nets.
