JonhRon/Non-Isolate-DC_DC-Converter/Buck_Converter/Simulation/PCB-Design/Buck_converter_ver01/Buck_converter_ver01.kicad_pcb

## KiCad design Buck_Converter/Simulation/PCB-Design/Buck_converter_ver01/Buck_converter_ver01.kicad_pcb (2026-07-28)

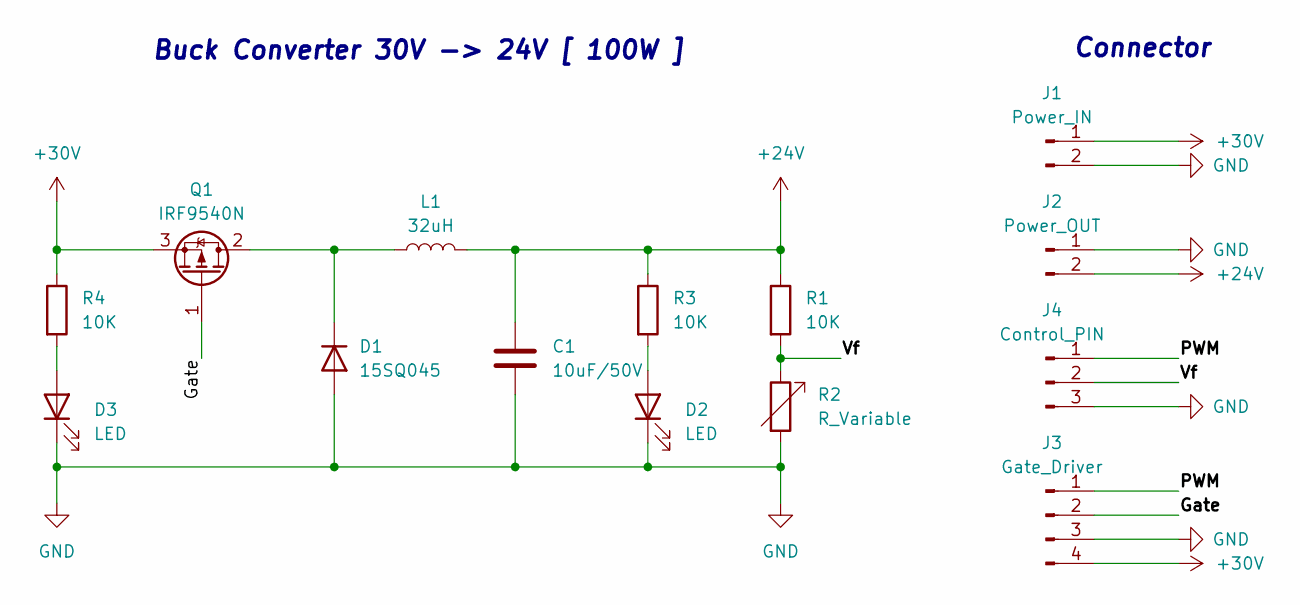
[picture p93: schematic Buck_converter_ver01.kicad_sch]

Parts:
C1: 10uF/50V; CP_Radial_D10.0mm_P3.50mm
D1: 15SQ045; D_P600_R-6_P12.70mm_Horizontal
D2, D3: LED; LED_D5.0mm
J1: Power_IN; TerminalBlock_bornier-2_P5.08mm
J2: Power_OUT; TerminalBlock_bornier-2_P5.08mm
J3: Gate_Driver; PinSocket_1x04_P2.54mm_Vertical
J4: Control_PIN; PinSocket_1x03_P2.54mm_Vertical
L1: 32uH; L_Wurth_WE-HCFT-2012_LeadDiameter1.5mm
Q1: IRF9540N; TO-220-3_Vertical
R1, R3, R4: 10K; R_0805_2012Metric_Pad1.20x1.40mm_HandSolder
R2: R_Variable; Potentiometer_Bourns_3296W_Vertical

Connections:
+24V: C1.1, J2.2, L1.2, R1.1, R3.1
+30V: J1.1, J3.4, Q1.3 (S), R4.1
/Gate: J3.2, Q1.1 (G)
/PWM: J3.1, J4.1
/Vf: J4.2, R1.2, R2.1
GND: C1.2, D1.2 (A), D2.1 (K), D3.1 (K), J1.2, J2.1, J3.3, J4.3, R2.2
unnamed: D1.1 (K), L1.1, Q1.2 (D)
unnamed: D2.2 (A), R3.2
unnamed: D3.2 (A), R4.2

Notes on the sheet:
Connector
Buck Converter 30V -> 24V [ 100W ]

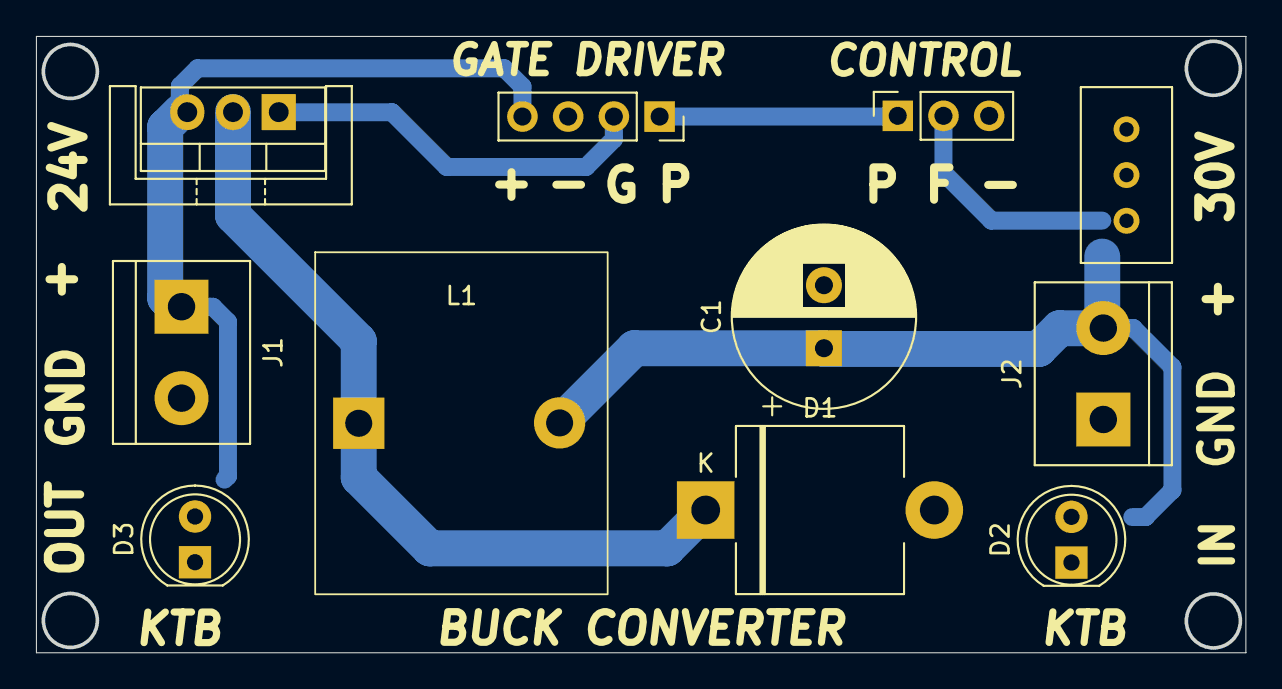
[picture p94: board Buck_converter_ver01.kicad_pcb from above]

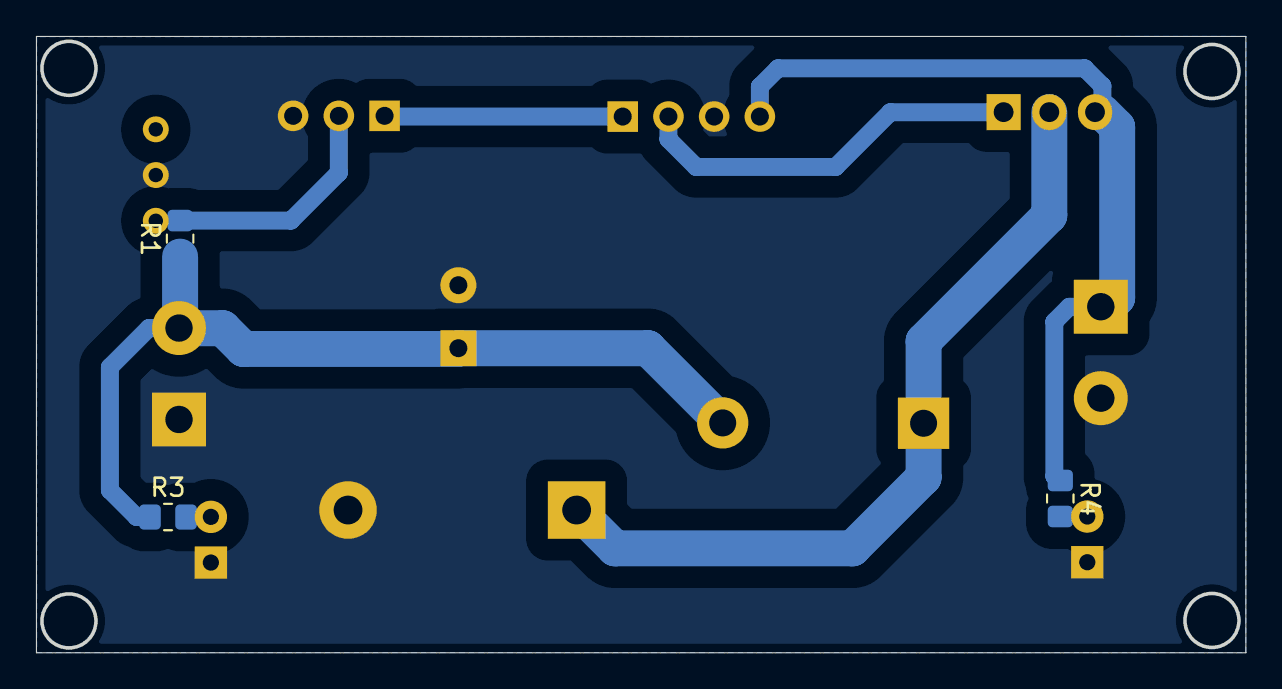
[picture p95: board Buck_converter_ver01.kicad_pcb from below]

Board: 2 copper layers, 67.2 x 34.2 mm, 14 parts (3 on the bottom side), 9 nets.
