JonhRon/Non-Isolate-DC_DC-Converter/Boost_Converter/Simulation/PCB_Design/boost_converter_v1/boost_converter_v1.kicad_pcb

## KiCad design Boost_Converter/Simulation/PCB_Design/boost_converter_v1/boost_converter_v1.kicad_pcb (2026-07-28)

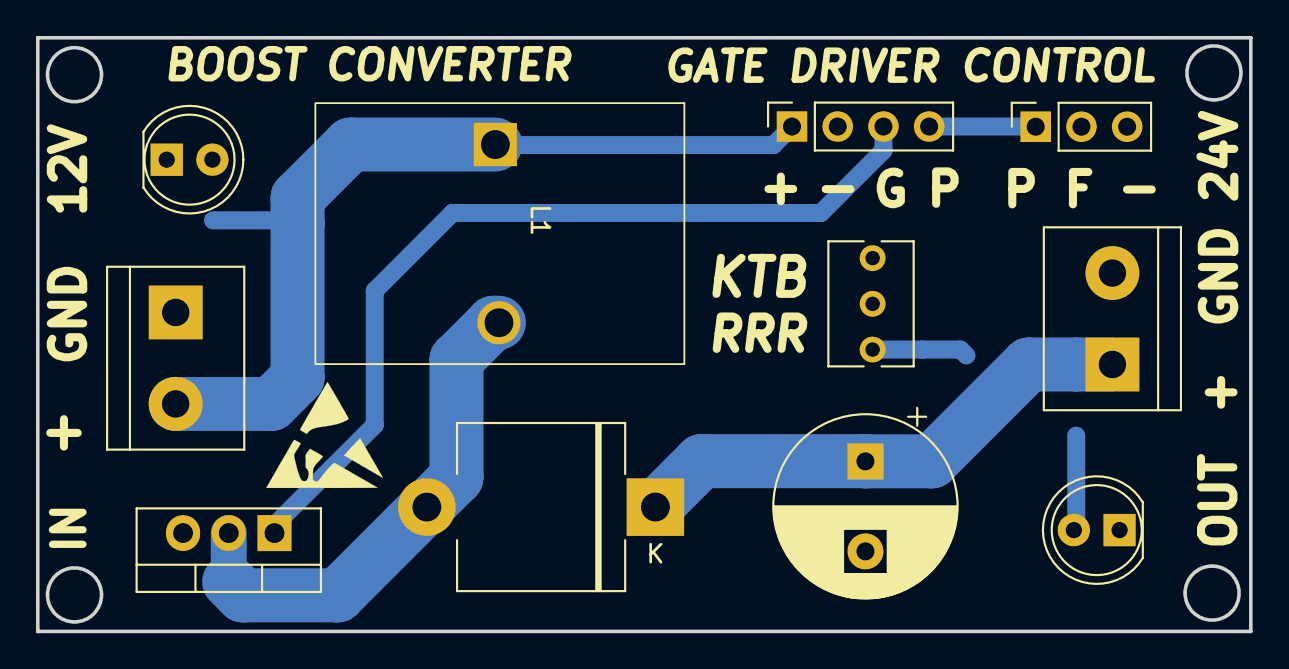
[picture p96: board boost_converter_v1.kicad_pcb from above]

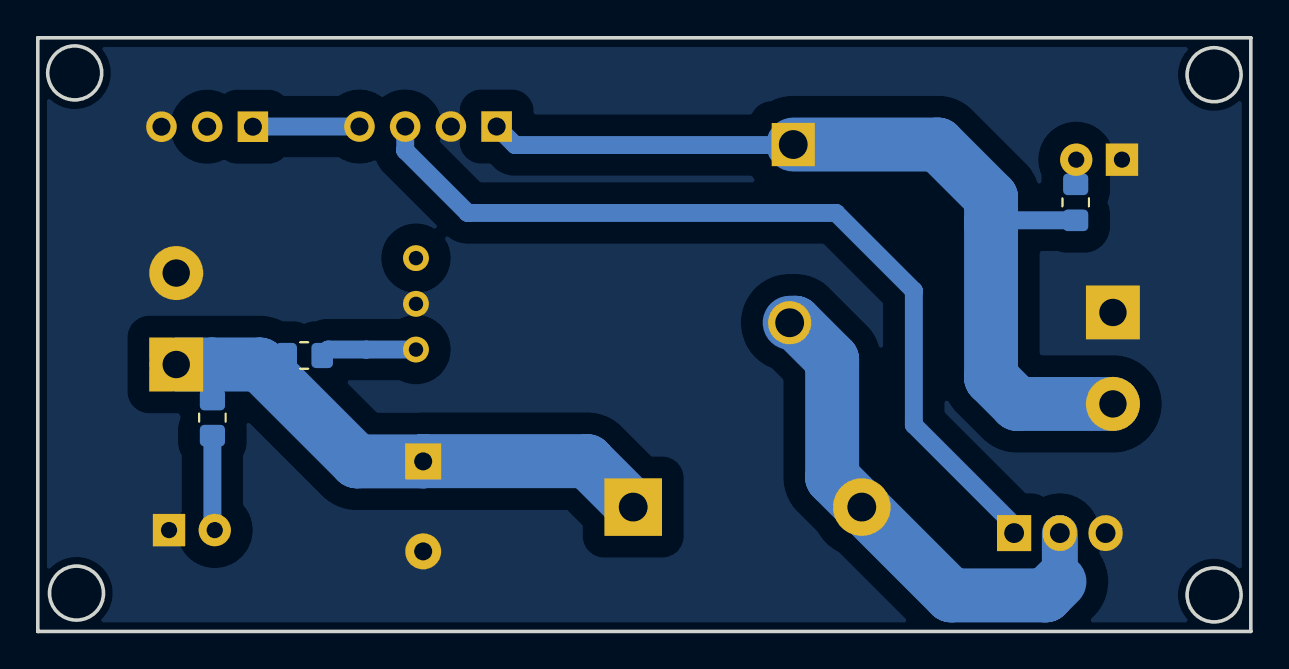
[picture p97: board boost_converter_v1.kicad_pcb from below]

Board: 2 copper layers, 67.4 x 33.0 mm, 14 parts (3 on the bottom side), 9 nets.

Parts:
C1: 100uF; CP_Radial_D10.0mm_P5.00mm
D1: 15SQ045; D_P600_R-6_P12.70mm_Horizontal
D2, D3: LED; LED_D5.0mm
J1: Power_IN; TerminalBlock_bornier-2_P5.08mm
J2: Power_OUT; TerminalBlock_bornier-2_P5.08mm
J3: Control; PinSocket_1x03_P2.54mm_Vertical
J4: Gate_Driver; PinSocket_1x04_P2.54mm_Vertical
L1: 20uH; L_Wurth_WE-HCFT-2012_LeadDiameter1.2mm
Q1: IRF540N; TO-220-3_Vertical
R1: 5K; R_0805_2012Metric_Pad1.20x1.40mm_HandSolder
R2, R3: 10K; R_0805_2012Metric_Pad1.20x1.40mm_HandSolder
R4: R_Variable; Potentiometer_Bourns_3266Y_Vertical

Connections:
+12V: J1.2, J4.1, L1.1, R1.1
+24V: C1.1, D1.1 (K), J2.1, R2.1, R3.1
/Gate: J4.3, Q1.1 (G)
/PWM: J3.1, J4.4
GND: C1.2, D2.1 (K), D3.1 (K), J1.1, J2.2, J3.3, J4.2, Q1.3 (S), R4.2
unnamed: D1.2 (A), L1.2, Q1.2 (D)
unnamed: D2.2 (A), R1.2
unnamed: D3.2 (A), R2.2
unnamed: R3.2, R4.1
