JonhRon/Non-Isolate-DC_DC-Converter/(commit log)

2026-07-28 Push Boost Converter
    [boost_converter_v1.kicad_pcb, boost_converter_v1.kicad_sch, data.xlsx]
2026-07-28 Push Buck Converter
    [Buck_converter_ver01.kicad_pcb, Buck_converter_ver01.kicad_sch, boost.pdsprj, buck [20250702, 15-20-02].pdsprj, buck.pdsprj, buck_1.pdsprj]
2026-07-28 push inspection power supply report
    [nmos_gate_ir2182.kicad_pcb, nmos_gate_ir2182.kicad_sch]
